liorknafo/power-feed-manual-mill/hardware/fab/README.md

# Fabrication files — MILL POWER FEED v1 controller

Generated by `hardware/tools/export_fab.py` from `hardware/kicad/power-feed.kicad_pcb` (KiCad 9, DRC clean,
schematic parity clean).

| File | Content |
|---|---|
| `power-feed-gerbers.zip` | Gerbers (4 copper, 2 mask, 2 silk, 2 paste, edge) + Excellon drills + drill map: upload this to JLCPCB |
| `gerbers/` | the same files unzipped |
| `power-feed-bom.csv` | BOM, JLCPCB columns: Comment, Designator, Footprint, LCSC Part # (+ MPN) |
| `power-feed-cpl.csv` | pick-and-place: Designator, Mid X, Mid Y, Layer, Rotation (mm, KiCad placement convention: Y up) |

## Board specification (order form)

- Size 100 x 100 mm, rectangular, 4 mounting holes M3.
- **4 layers**, 1.6 mm FR-4, stack-up F.Cu signal / In1 GND / In2 power (+36 V, +3V3) / B.Cu signal.
  JLCPCB standard 4-layer stack (JLC04161H-7628) is fine.
- **Outer copper 1 oz**, inner 0.5 oz (JLC standard). The motor-phase / supply widths and pours are sized for
  1 oz at ~3.5 A RMS; the via counts are the real current limit. Do not order 2 oz: the 0.15 mm spaces and the
  fine-pitch parts (QFN-56, TQFP-48) are below JLC's 2 oz rules.
- Minimum track / space **0.15 mm**, minimum via **0.5 mm / 0.25 mm drill**, minimum drill **0.2 mm**
  (TQFP-48 exposed-pad thermal vias). Hole-to-copper 0.25 mm.
- Surface finish: **HASL lead-free or ENIG** (ENIG preferred for the TQFP-48, QFN-56 and 0402 parts).
- Solder mask any colour; silkscreen white. Vias tented.
- Remove order number: yes (or put it under J6).
- Castellated holes: no. Impedance control: no.

## Assembly notes

- Components on the top side only. Through-hole parts: J1, J2, J5 (Phoenix MSTBA 5.08), J6 (2x7 IDC),
  J7 (JST-XH 7p), C1, C27 (470 uF radial), F1 (5x20 fuse holder) — hand solder or JLC THT assembly.
- J3 (SWD, 1x3 0.1 in pin header, THT) is hand-soldered; it is only needed for debugging (firmware loads over
  USB-C in BOOTSEL mode).
- The MCU is a bare RP2040 (U3, QFN-56 0.4 mm pitch, exposed pad on thermal vias) with W25Q128JVS flash (U4),
  12 MHz crystal (Y1), AP2112K-3.3 LDO (U6), USBLC6-2SC6 USB ESD (U5) and a USB-C receptacle (J4, SMD pins +
  THT shell pegs) on the bottom edge: all machine-placed, no module to hand-solder.
- U2 (TMC5160A) exposed pad and the four CSD88537ND half-bridges need the paste layer as generated.

## Parts without an LCSC number

The schematic carries an `LCSC` field for 190 of 191 parts (73 of 74 BOM lines).
These BOM lines have no LCSC number yet and must be matched to a JLC basic/extended part (or sourced
separately) before ordering assembly:

| Comment | Footprint | Designators |
|---|---|---|
| SWD | PinHeader_1x03_P2.54mm_Vertical | J3 |
