liorknafo/power-feed-manual-mill/mechanical/clutch/MACHINING.md

# Clutch — machining sheet

The model: `mechanical/solidcraft/parts/clutch/` and `clutch.sc` (`mechanical/solidcraft/README.md`). This sheet was
generated from the build123d model the SolidCraft project replaced, with the same numbers as the SolidCraft parts;
keep it in step by hand when a part changes.

All dimensions mm. **Bold** = critical for concentricity or the magnetic gaps: turn these in ONE chucking.
Concentricity budget: every bold diameter ≤ 0.03 TIR to its part's reference bore. After assembly, indicate the
rotor OD and the output shaft: ≤ 0.05 TIR each, or the 0.3 mm hub gap and the tooth mesh suffer.
Magnetic parts: low-carbon steel (1018/1020/12L14), anneal after machining if possible. Never 300-series stainless.

## Field housing (steel) — `field_housing.step`
| Feature | Dimension | Tolerance / note |
|---|---|---|
| OD | **Ø80.0** | h7 (cover spigot fits over it) |
| Length | 20.0 | ±0.05 — sets the 0.3 mm rotor face gap |
| Motor pilot recess (back) | **Ø38.1 (measure your motor) × 2.0 deep** | slide fit on the pilot, ≤0.02 play; the model shows +0.2 |
| Inner pole bore | **Ø19.2** through | concentric with OD and pilot within 0.03 |
| Coil cavity | Ø28.0 … Ø54.0, 15.0 deep from the front | **CNC:** circular pocket with a Ø8–10 end mill round the inner pole (a boring bar can't reach the inner wall), or a face-grooving tool on the lathe. Cut the 4 Ø9 counterbores FIRST: only 1.8 mm of wall is left between each and the cavity |
| Back plate | 5.0 thick | |
| Motor screws | 4× Ø5.5 thru on 47.00 square, c'bore Ø9 from front to z=6 | M5×20 SHCS + nuts behind the motor flange |
| Coil leads | Ø3.2 thru at r=20.5 + 3.2×1.5 groove on the back face | |
| Cover screws | 6× M4 tapped radial, every 60°, 12.0 from the back face (motor side) | no 4th axis needed: fit the cover, then drill Ø3.3 through the cover's holes into the housing, and tap |

## Rotor (steel) — `rotor.step`
| Feature | Dimension | Tolerance / note |
|---|---|---|
| Hub OD | **Ø18.6** × 18.1 long | runs in the Ø19.2 bore: 0.3 radial gap, keep runout < 0.05. Starts 2.2 above the motor flange, clear of the 1.6 pilot |
| Shaft bore | **Ø10 H7**, **flat bottom 0.70 ± 0.03 in front of the face disc's back face** (that is what sets the 0.3 face gap); depth from the hub end ≈ 18.8 with the model's shaft length | finish the bottom with a boring bar (a reamer can't reach it); **the 23HS45-4204S's shaft is 24 long: cut it to 21.0 from the flange face** (face it square, drill Ø2.5 × 8, tap M3 in its end), then the bottom sits at that length + 0.3 from the housing back. Loctite 641 on the D-shaft |
| Retaining screw | Ø3.4 thru + c'bore Ø5.8 × 3.2 from the front | M3×8 SHCS (3.0 head, sits 0.2 below the pole face) into the tapped motor shaft end (drill Ø2.5 × 8, tap M3) |
| Face disc | **Ø76.0** × 5.6 thick | back face sits 0.3 from the housing front; front face = pole face |
| Banana slots | 3 × 112° arcs, r 19.0 … 22.0, through (8° bridges), full-round ends | CNC, Ø3 end mill on the r 20.5 arc (slot = tool width) |
| Tooth ring | r 32.0 … 38.0, 30 teeth (12.0° pitch), flank 30° from axis | flanks meet 0.5 below the pole face; root floor 0.5 deeper (1.0 below the pole face, from r 31.0 out to the OD); tips 0.80 above where the flanks meet; see Teeth |

## Armature (steel) — `armature.step`
| Feature | Dimension | Tolerance / note |
|---|---|---|
| OD × thickness | **Ø76.0 h7 × 6.0** | OD, bore and the tooth-ring face in one chucking (≤ 0.02 TIR): the OD centres the part for milling the teeth and the pin holes; faces parallel within 0.02 |
| Bore | Ø11.5 | clearance over the rotor's M3 head |
| Tooth ring | as the rotor, rotated half a pitch (6.0°) | flanks meet 0.25 behind the pole face, root floor 0.75 behind it (from r 31.0 out), tips truncated 0.1 |
| Drive-pin holes | 3× **Ø6.15–6.20 through** (glue gap for Loctite 680) at r=21.0, 90°/210°/330°, position ±0.02 from the bore, 0.3 × 45° chamfer at the front-face mouth (glue trap) | same program and zero as the hub's bush holes. The pins are bonded in place through the bushes (assembly step 0), so the bushes line them up; through, so excess glue leaves at the back face (r 21 faces the rotor's slot ring, between the poles) |

## Output hub (6061) — `output_hub.step`
| Feature | Dimension | Note |
|---|---|---|
| Flange | **Ø76.0 h7** × **8.7** | its armature-side face is the **released stop** the springs pull the armature against: face it flat and square to the bore within 0.02, and turn the OD, in the same chucking as the bore (the OD, = the armature's, centres the armature when its pins are bonded) |
| Boss | Ø24.0 × 10.0, bore **Ø12 H7** | 2× M5 set screws, mid-boss, at 30° and 150° (midway between the pins, so a hex key reaches them past the springs): one on the shaft flat, one on the round (+ Loctite 243) |
| Bush holes | 3× **Ø10 H7** through at r=21.0, 90°/210°/330°, position ±0.02 from the bore | same program and zero as the armature's pin holes; press the bronze bushes in flush with the **stop face** (the bush bore closes to about F7 on the pins); the 0.7 left on the spring side locates the springs |

## Cover (6061 — must be non-magnetic) — `cover.step`
| Feature | Dimension | Tolerance / note |
|---|---|---|
| OD | Ø88.0 | |
| Spigot bore (over the housing) | **Ø80.0 H7** × 18.0 | slide fit on the housing OD, same chucking as the bearing bore |
| Shoulder / inner cavity | Ø78.0 | the step from the spigot sits on the housing rim and locates the cover axially; clears the Ø76 rotor / armature |
| Bearing bore | **Ø28 H7**, straight through the 8 wall + 28 boss (≈ 89 mm from the open face) | two setups, no long reach: (1) grip the OD lightly (soft jaws: thin wall), face the front, turn the boss, then drill/rough and **bore Ø28 H7 right through from the boss end (36 deep, ~1.3×D)** and cut **both** circlip grooves from that end; (2) mount it on a Ø28 expanding mandrel (or a Ø28 h6 stub turned in place) in the chuck, boss toward the chuck, and bore the Ø80 H7 spigot and the Ø78 cavity: the spigot is then concentric with the bearing bore to the mandrel's accuracy (≤ 0.01). Boring the Ø28 from the open side instead would mean an ~89 mm reach (4.5×D, chatter) |
| Circlip grooves | 2× for DIN 472-28: Ø29.4 × 1.3, **2.1 land** from each end of the bore | the land takes the circlip load: keep the entry chamfer smaller than it |
| Radial screws | 6× Ø4.5 every 60°, 10.0 from the open end, **90° countersink Ø9.2** | M4×8 countersunk (ISO 10642) into the housing, flush: a socket head would stand 4 mm proud, and the one at the bottom would hit the mains tray; drilled together with the housing (see there) |
| Front wall | 8 thick, 4× M5 tapped thru on r=36 at 40/140/190/350° (0° = +X, 90° = drawbolt) | bolts the module to the feed-unit plate |
| Drawbolt hole | M4 tapped **14** deep (drill Ø3.3 × 16), radial, in the front wall at mid-thickness, between two of the M5 (M4 leaves 2 mm of wall each side in the 8 mm wall) | feed-unit belt tension; it points away from the leadscrew. 14 deep because the module moves 6 mm along the M4×30 drawbolt over the tension range |

## Other parts
- Output shaft: Ø12 h6 **unhardened** ground rod (NOT hardened linear shaft: the flats and groove can't be cut in it) × 78. Flats 0.6 deep: × 22 at the pulley end; under the hub boss a Ø10 spot face (plunge a Ø10 end mill). DIN 471-12 groove (Ø11.5 × 1.1) at 29.7 from its motor-side end, just outboard of the inner bearing.
- Drive pins: 3× Ø6 h6 silver steel (unhardened ground rod) × 25.5, 0.5 × 45° lead chamfer at the armature end, bonded 5.5 deep into the armature with Loctite 680 (Amazon B00KC541DA; 0.5 short of its back face). E-clip groove Ø5 × 0.74 (DIN 6799 RS5), 1.0 from the free end. They slide in the hub's bronze bushes, carry the torque (≈ 71 N per pin at the 4.5 N·m cam-out torque) and keep the armature centred.
- Return springs: 3× compression spring, music wire 0.8, OD 9 (ID 7.4: clears the pin, sits on the bush end), free length ≈ 11.9, rate ≈ 2.5 N/mm, solid ≤ 5. Installed 8.7 long released (≈ 8 N each, 24 N total: the armature is pulled firmly against the hub) and 7.6 long engaged (≈ 11 N each, 32 N total). Any catalogue spring near this works; the coil current is calibrated afterwards. On each pin: spring, M6 washer (ISO 7089, Ø6.4/12 × 1.6), E-clip.
- Bushes: 3× sintered (oil-impregnated) bronze plain bush 6 × 10 × 8, ISO 2795 form C.
- Bearing stack (cavity side → outer end): circlip, inner 6001, spacer tube Ø27.95/Ø25 × 12.8 (outer races), outer 6001, circlip. The INNER bearing locates the shaft both ways: the stepped spacer Ø15/Ø12 × 6.6 (hub boss → inner race) on one side, the DIN 471-12 on the shaft on the other (inside the spacer tube); the outer bearing floats on the shaft.
- Assembly (the hub and armature must go on the shaft first: once inside the cover nothing on them is reachable):
  0. **Armature on the hub; the bushes line the pins up.** Glue must never reach a bush (the pin-to-bush gap is
     0.01–0.03; Loctite 680 there would lock the pin), so in this order:
     a. Press the 3 bushes into the hub from the spring side, the stop face on a flat plate, so they finish flush with it.
        Wax both ends of each bush (clean the wax off after curing).
     b. Hub on the shaft with the shaft end **3.70 inside the stop face** (depth micrometer), then the set screws.
     c. Armature on its own: a thin film of 680 on the walls of its 3 holes only, keeping the 1.5 mm at the front-face
        (hub-side) mouth of each dry.
     d. Armature pole face down on PE film on a surface plate (it stands on its tooth tips, ~0.55 proud: that gap lets
        the glue out); the hub on it, stop face on the armature's front face, its bush holes lined up over the armature's
        holes by eye; then a **centring sleeve** over both (any tube bored Ø76 H7, ~25 long). The first pin's chamfer
        finds the rest of the alignment.
     e. Each pin: a Ø6 shaft collar (OD 12–16: it must bridge the Ø10 bush counterbore and clear the Ø24 boss) set 14.2
        from its chamfered end. Push it, dry, straight **down** through its bush into the hole until the collar lands on the
        hub's spring-side face, and never lift it: the tip then sits 0.5 inside the armature's back face. Excess glue is
        pushed out of the open bottom of the hole onto the PE film; the 0.3 mouth chamfer catches any that creeps up.
     f. Clamp lightly (on the hub boss or the shaft end, never on the teeth), let it cure (24 h), collars and sleeve off,
        scrape the back face flush: nothing may stand proud of it (the engaged pole gap is 0.15). Each pin was set by its
        own bush, so three pins in three bushes can't bind. Slide the armature off the bushes, clean the wax off both
        stop faces and the bush ends, slide it back.
     g. On each pin, from the hub's far side: spring (into the counterbore on the bush), washer, E-clip (compress the
        spring with a slotted tube). Check: the armature slides 1.1+ mm toward the motor by hand, freely, and snaps back.
        Keep the stop faces dry (degrease): oil from the bushes on them can make the armature stick to the hub a little.
  1. Inner circlip into the empty cover. 2. Inner 6001 in from the outer end until it seats on that circlip.
  3. Shaft with hub, armature, pins, springs and stepped spacer already fitted: push it through the inner bearing from the cavity side,
     supporting the inner race with a tube from the outer end (Loctite 243 on that seat).
  4. DIN 471-12 down the bore into its groove (~24 deep from the outer end) with a cone on the shaft end and a push tube.
  5. Spacer tube, outer 6001 (slides on), outer circlip.
  6. **Released-gap check.** The springs hold the armature against the hub, so the released gap is set by where the hub
     sits: the stepped spacer (hub boss → inner race) sets it. The gap is out of reach once the cover is on, so measure two
     depths before closing, with a depth micrometer:
     A = rotor pole face above the field housing's front face (rotor glued on, motor shaft in): 5.90;
     B = cover shoulder face (the step that sits on the housing rim) down to the armature's pole face: 7.15.
     B − A is the released gap: 1.25 ± 0.10. Too small: grind the stepped spacer shorter; too big: shim it. After closing,
     turning the output by hand with the coil off must not tick (no tooth contact); coil on (1.5 A) the output locks to
     the motor, coil off it frees at once.
- Coil: ~850 turns 0.32 mm (AWG 28) enamelled Cu on a bobbin Ø28.6…Ø53.4 × 14.5; ≈24 Ω. Leads out through the back plate.
- Bearings: 2× 6001-2RS in an H7 bore. Shaft is h6 ground rod: the inner (locating) bearing is retained with Loctite 243 (Amazon B004L439FE; medium strength, comes off with hand tools: Loctite 641 doesn't ship to Israel), the outer one is a slip fit so it can float. Screws: 4× M5×20 + nuts (motor; the nuts sit behind the 4.8 mm flange in the body's corner relief: check yours has room, else use M5 screws from the motor side into M5 tapped in the housing), 6× M4×8 countersunk ISO 10642 (cover), 1× M3×8 (rotor), 2× M5×6 set screws (hub), 4× M5×35 + washers (module to the 28 mm feed-unit plate), 1× M4×30 drawbolt.
- Coil leads: sleeve them through the back plate, and pot the winding in the cavity (epoxy) so it cannot chafe or move.
## Teeth
- 30 radial teeth, flanks **flat planes** at 30° from the axis: every flank is the plane through a radial line at the pitch
  plane, so a 60° chamfer mill cuts it exactly in one straight pass, and the rotor's gaps and the armature's teeth share those
  lines: both parts come off the SAME program and mate exactly.
- Engaged pole gap 0.15, stroke 1.1 -> released gap 1.25.
- Tips truncated 0.1 (break them 0.1 × 45° after), roots relieved 0.5 below where the flanks meet: a mating tip sits 0.6 above
  the root floor, so the flanks carry all the load and the root corners never touch.
- **Turning (before milling), both parts:**
  - tooth band r 32 → OD: turn to the TIP height: **0.30 proud of the rotor pole face, 0.55 proud of the armature pole face**;
  - run-out groove r 31.0 … 32: turn down to the root floor, 1.3 below the tip height (the cutter runs out into it);
  - face the pole face inside r 31.0 as dimensioned.
- **Milling (3-axis CNC, no indexer needed):**
  - Hold: rotor by its hub in a collet block, teeth up; armature on a fixture plate with a Ø11.5 spigot in its bore and
    3 Ø6 dowels in its pin holes (drill those first), clamped by a centre bolt through the spigot with a Ø24 washer on
    the inner pole face. Centre both on the Ø76 OD.
  - **Z zero on the turned TIP surface** (same on both parts). Pitch plane = 0.35 below it; root floor = 1.30 below it.
  1. Rough each gap with a Ø2 flat end mill to the root floor, radial passes with the **cutter centre from r 32** out past the
     OD (starting further in notches the inner pole face), leaving ~0.1 on the flanks (the floor gap is only 2.25 wide at r 32).
  2. Finish each flank with a **60° chamfer mill** (pointed or ≤ 0.2 flat), one straight radial pass per flank, **tip at the root
     floor (Z −1.30)** (anywhere at or below Z −0.70 still covers the working flank): the cone's side on the flank line at the
     pitch plane, offset by the cone radius at that depth. 60 flanks per part, same program for both.
  3. Measure the chamfer mill's actual angle and point first: each 0.01 mm of flank error on both parts moves the armature 0.035
     axially. **Acceptance:** mate the pair dry and check the pole gap with feeler gauges: 0.15 ± 0.05.
- Lap the pair together with fine compound after cutting; re-check the gap.
- `flank_deg = 45` suits a standard 90° chamfer mill, but the cam-out force then rises ~1.8x (expect ~1.3x more hold current;
  re-calibrate per design.md §7.4).

## Tools (lathe + 3-axis CNC mill; no indexer, no 4th axis, no form cutters)
| Tool | Used for |
|---|---|
| Lathe turning tool, nose radius **≤ 0.3** (e.g. DCMT 11T302) | all ODs, faces, the tooth bands, the run-out grooves, the seating corners (see Corners) |
| Boring bars: min. bore Ø8 (L ≥ 25) and min. bore Ø20 (L ≥ 45) | rotor Ø10 H7 bore with its **flat** bottom; cover Ø28 H7 (from the boss end), Ø78 cavity, Ø80 H7 spigot; housing Ø19.2 pole bore and pilot recess |
| Internal grooving tool 1.3 wide for ≥ Ø26 bores | cover: 2× DIN 472-28 grooves (Ø29.4) |
| External grooving tool 1.1 wide; a 0.7–0.75 wide ground HSS blade | output shaft DIN 471-12 groove; drive-pin E-clip grooves (DIN 6799 RS5, 0.74) |
| Expanding mandrel Ø28 (or a stub turned in place) | cover, 2nd setup |
| Carbide end mills: Ø2 flat (flute ≥ 2), Ø3 (flute ≥ 6), Ø8–10 (flute ≥ 16), Ø10 | tooth roughing; rotor banana slots; housing coil cavity (15 deep); output-shaft spot face and flats, Ø9 counterbores |
| **60° chamfer mill**, pointed or ≤ 0.2 flat (e.g. a 60° spot drill) | the 120 tooth flanks (60 per part) |
| Drills Ø2.5, 3.2, 3.3, 3.4, 4.2, 4.5, 5.5, 6.2, 9.8, 11.8 + reamers Ø10 H7, Ø12 H7 | screw holes; drive-pin holes (Ø6.2 drill = the 6.15–6.20 glue gap); hub bush holes (Ø10 H7); hub bore (Ø12 H7) |
| Taps M3, M4, M5 | rotor screw (motor shaft end), cover/housing radial M4, cover front-wall M5 and drawbolt M4, hub set screws |
| Workholding: ER32 collet block; a fixture plate with an Ø11.5 spigot, 3 Ø6 dowels and a centre bolt | rotor teeth (by its Ø18.6 hub); armature teeth (see Teeth) |
| Measuring: depth micrometer, feeler gauges 0.10–0.20, dial indicator | released-gap check (step 6), tooth-mesh pole gap 0.15 ± 0.05, runout ≤ 0.03 / 0.05 |

## Corners (what the tools leave, and why it doesn't matter)
- Every internal corner along a cutter's axis is modelled round (slot ends, pockets) or is a drilled/counterbored hole.
  (The build123d model's check of this is gone with it: look for sharp internal corners by eye after changing a part.)
- Turned internal corners get the tool's nose radius. Keep it **≤ 0.3** where a part seats in the corner:
  - cover: spigot bore → Ø78 shoulder (the housing's front OD edge is chamfered 0.5 × 45° to clear it);
  - field housing: coil cavity floor corners (the bobbin has 0.3 clearance; chamfer its corners) and the motor-pilot recess
    floor (the motor's pilot edge is chamfered);
  - rotor: hub → face-disc corner (the housing bore's front edge is chamfered 0.5 × 45° to clear it).
- Rotor shaft bore: the motor shaft's end seats on its bottom, so the bottom must be **flat** and is dimensioned from the
  face disc (see Rotor): drill under size, bore to H7 and finish the bottom with the boring bar (a reamer can't reach it).
  A drill point there would set the rotor ~3 mm wrong.
