liorknafo/power-feed-manual-mill/mechanical/feed_unit/FEED_UNIT.md

# X feed unit — SIEG X3.5D left table end

The model: `mechanical/solidcraft/feed_unit.sc` and its parts (`mechanical/solidcraft/README.md`). This sheet was
generated by the build123d model the SolidCraft project replaced; its numbers are the same in the SolidCraft parts.

**Status: concept with PLACEHOLDER mill dimensions.** Measure the items in docs/mill.md, set them in the SolidCraft
parts (`mechanical/solidcraft/README.md` → "Measure first"), run `mechanical/solidcraft/tools/check.py`, and check the
renders before cutting metal.

## Drive
| Item | Value |
|---|---|
| Belt | HTD 5M, 295 mm (59 T), 15 mm wide |
| Pulleys | 20 T (PD 31.83) on the clutch output Ø12; 40 T (PD 63.66) on the Ø15 stub → 2.0:1 |
| Centre distance | 70.71 mm, tension slot ±3 mm along the centre line |
| Module position | 70.7 mm from the leadscrew at -90° (below) |
| Belt plane | 23.0 mm out from the bracket face |
| Overall | ≈316 mm out from the table end (housing end panel) |

Firmware: `belt_ratio = 2.0`, `encoder_counts = 2400` (per leadscrew turn; the encoder is on the stub).

## Parts to make
| Part | Material | Notes |
|---|---|---|
| Plate | 6061, 28 mm, CNC | **Ø32 H7 straight through**: too big to swing on the lathe (300 mm needed), so bore it on the mill with a boring head. DIN 472-32 grooves (Ø33.7 × 1.3) leaving a **2.6 land** at each face: keyseat cutter (head ≤ Ø28, 1.0–1.2 wide, two passes) by circular interpolation, one face, then flip for the other. Clutch-module hole slotted Ø40 **and run on down through the bottom edge** (the module slides up into it from below; the two legs are 35 wide, tied by the tension block) and 4× Ø5.5 slots (±3): 5×D deep, cut them from both faces. Bottom edge: 2 rebates 2.5 deep × 14 wide × 13 in from the outer face at x ±34 (Ø6 end mill from the edge, R3 inner corners) with an M4 × 10 tapped up into each, for the mains tray's tabs. 4× Ø6.6 for the standoffs, each with an Ø11 × 6.5 counterbore in the outer face (M6×70 SHCS heads flush: the low pair sits beside the clutch cover); 3× M3 × 8 deep on r=23 (encoder posts, outer face); 2× M5 × 12 for the tension block (x ±30). Edge holes (M3 × 8 for the housing): stand the plate in the vise on its edge, or use a drill-guide block. Corners R9 |
| Standoffs | steel or 6061 | 4× Ø14 × 35, Ø6.6 thru (M6 screws into the table end) |
| Leadscrew stub | steel, turned from **Ø20** stock | from the table side: tongue 4.8 × 14 × 4 (across the Oldham slot), Ø15 with a 0.6 flat for the 40T set screws, **Ø18 × 2 shoulder** on the inner bearing's inner race (corner radius ≤ 0.3 so the bearing's chamfer clears it), Ø15 h6 at both bearings with **Loctite 243 on the inner one** (as on the clutch; easier than holding k6 and h6 bands on a manual lathe), DIN 471-15 groove (Ø14.3 × 1.1) just outboard of the inner bearing, Ø8 × 10 encoder end |
| Bearing spacer tube | steel or 6061 | Ø31.95 / Ø28 × 1.8, between the outer races. The inner bearing locates the stub (shoulder + DIN 471-15 either side of it); the outer one floats on the stub |
| Oldham disc | steel (1045) or bronze (CuSn12), greased — acetal creeps at the ~45 MPa of a stall/cam-out | Ø24 × 9: tongue 14 × 3.8 on one face (into the leadscrew slot), cross slot 5.0 wide × 4.5 deep on the other. Takes up to ~1 mm offset between the plate and the leadscrew, and end float |
| Encoder disc | 6061, 5 mm | Ø50 with a flat 20 from centre toward the clutch module; Ø22 centre hole; 3× Ø3.4 on r=23 (posts) and 3× Ø3.4 on r=15, 60° offset (encoder, **check your encoder's hole circle**) |
| Encoder posts | 3× M3 hex standoffs F-F, 30 mm, 6 across flats (priaolker brass, Amazon B09NDJFLG7) | |
| Tension block | 6061 | 72 × 14 × 12 on the plate's outer face below the module, bridging the plate's slot, 2× M5 into the plate's legs (x ±30), **with a 39.8 × 28 tongue that fills the slot** from the plate's bottom edge up to 60 (just under the clutch boss): it seals the belt chamber off from the box (chips, coolant) and ties the plate's legs (checked); M4 drawbolt through it into a radial M4 tapped 7 deep in the cover's front wall (bottom, between two module bolts). Tighten the drawbolt to tension the belt, then lock the 4 module bolts |
| Belt guard | PETG print | a cup: closed back against the table end (Ø28 pass-through for the leadscrew and Oldham disc), open face covered by the plate; captured between the two |

## Assembly
1. Plate: outer circlip, outer 6002 (pressed in from the chamber side), spacer tube.
2. Stub: inner 6002 against the shoulder, DIN 471-15 behind it. Push the stub through the outer bearing from the
   chamber side (support the outer bearing's inner race) until the inner bearing seats, then the inner circlip.
3. Encoder to its disc, coupling on the encoder shaft, disc onto the posts, coupling onto the stub end.
4. 40T pulley on the stub (set screws: one on the flat, one on the round), Oldham disc on the stub tongue, guard into the chamber, then
   the plate onto the standoffs: the Oldham tongue goes into the leadscrew slot.
5. Clutch module through the plate's slotted hole (motor bolted to the clutch with its leads toward the front wall, not up
   toward the PCB: checked), 20T pulley and belt, 4 module bolts finger-tight, drawbolt to tension, lock.
   The bolt heads are on the chamber side, outside the guard outline: reach them from the side with a ball-end key.

## Buy
Every bought part ships to Israel from Amazon.com (checked with an Israeli address); the Amazon list "Mill power feed
(SIEG X3.5D)" has them all, and `mechanical/solidcraft/parts/bought/` models each from its listing's drawing.
- HTD 5M pulleys, both hubless (flange, teeth, flange): **20 T Saelno 20-5M-15-8mm** (Amazon B0FNQTJZMX: Ø35 flanges, 16
  between them, 20 overall, Ø8 bore, 2× M5 through the teeth 90° apart) and **40 T uxcell 5M-40T-1/2B** (B0G5YDQS1N:
  Ø67 flanges, 22 overall, Ø12.7 bore with a keyway). Re-bore to Ø12 / Ø15 H7 (the 40T's keyway leaves a 0.25
  trace: harmless). Set screws 90° apart through a tooth root, one on the shaft's flat, one on the round, like the
  clutch hub: the 20T's own 2× M5 (M5×6), on the 40T 2× M5×20 (use its own holes if they are in a tooth root, else
  drill Ø4.2 and tap; the drill nicks the teeth either side: harmless, deburr).
- Belt 295-5M-15 (uxcell B0D5R5Y6VL).
- 2× 6002-2RS, 2× DIN 472-32, 1× DIN 471-15.
- Flexible coupling 6 × 8 mm, uxcell Ø19 × 25 beam type with set screws (B0FN786WNM).
- Encoder: Aideepen LPD3806-600BM-G5-24C, 600 P/R, NPN open collector (B01MZ4V1XP).
- Retaining compounds (Loctite 641 and 638 don't ship to Israel): **Loctite 243** (Amazon B004L439FE) on the bearing
  seats and the motor shaft (medium strength, comes off with hand tools), **Loctite 680** (B00KC541DA, seller ACTOOLS)
  for the clutch's drive pins. Both checked shipping to Israel.
- 4× M6 for the standoffs; 4× M5×35 + washers for the clutch module (28 plate + 8 wall: the tips stop clear of the hub); 2× M5×20 (tension block) + 1× M4×30 (drawbolt); 3× M3 hex standoffs 30 mm F-F (room for the 25 mm coupling) and 6× M3×8.

## Notes
- The module hangs ≈177 mm off the plate on 4 M5 into the cover. The cover's spigot over the clutch housing is
  18 mm long with 6 radial M4, so the motor is held stiffly. A strap from the motor's tail to the
  table end is optional if the mill vibrates a lot.
- The chamber (35 mm) is set by the Oldham disc plus the belt plane: the 40T pulley's inner flange clears the stub tongue.

## Housing: the whole power feed in one compact box (3D printed)
The drive, the controller PCB, the controls and the 36 V supply share one rounded housing on the table end. Outside
it there is only the belt chamber (closed by the guard cup) and the limit switches. The housing carries no load
(the aluminium plate carries the bearings, the module and the belt), so it is printed.

Packing: the clutch and motor hang below the leadscrew, the encoder sits on the leadscrew next to the plate, the
**PCB lies flat above the motor** (components up, connector edge toward the end wall), and the controls sit in a
strip along the upper front with their bodies reaching back over the PCB.

| | |
|---|---|
| Outer size | 116 (front-back) × 204 (high) × 262 mm (along the table); long edges R12, the top-front edge and the end wall chamfered 45° (they lie on the print bed); plus the 35 mm belt chamber and the controls proud of the front |
| `shell` (one print) | back and lower-front walls (3 mm) from the plate to W 248, the rails, the 4 PCB bosses, the louvre blocks; **no floor** (that is the door), no end wall (that is the end cap). **Print standing on its cut face** (the plate-side rim up), 193 mm tall (MK3S: 210), on the 5 × 3 brace that ties its back and front walls across the cut face; above the brace they stand as two tall walls, so **use a brim** (5 mm). Every boss and block has a 45° underside, so **no supports**; only short bridges (≤ 12 mm: rail windows, louvre slots). PETG, 4 perimeters, 20 % gyroid |
| `end_cap` (one print) | the last 68 mm of the box: the end wall, the ends of the back, front and top walls and of the control strip, and the floor under the mains tray's far end (2 ribs carry that end). It exists because the LRS-150-36 (the only 36 V Mean Well on Amazon that ships to Israel) makes the box 262 mm long, too long for one print. **Print standing on the end wall**, 90 mm tall with its blocks; the blocks' ends are 45° wedges, no supports. It goes on **last, sliding along the table axis** (checked: nothing in its way): its floor slides under the tray's far end, a 45° scarf on its bottom band slides under the door's far end and holds the door shut, and 3 blocks reach 22 mm into the shell along its back and front walls: 3× M3×8 countersunk through the shell's walls into heat-set inserts in them. The seam is **lapped over the top and the sides**: the cap's outer 1.2 mm runs 8 mm on over a step in the shell's walls, and the hood's runs 8 mm on over a step in the cap's top (0.2 mm clear), so coolant on the top or the sides can't reach the plugs or the mains tray. Only the sides' bottom 5.5 mm (beside the hinge knuckles) is a plain butt joint, which leads only to the floor under the earthed tray: a bead of silicone there, as on the door seam, if coolant gets in; the hood still lifts straight off, the cap still slides. Take it off (3 screws) before opening the door: it then hangs on the USB, SWD, button and limit-switch wires, so leave them ~150 mm of slack and set the cap down beside the box (or tie it up) rather than let it hang |
| `door` (one print) | **the floor** up to the end cap, both rounded bottom edges included (116 × 193 mm, up to 8.5 mm on the walls): open it and the clutch/motor module and the mains tray go in and come out **from below** (checked: both lift into place with nothing in the way). Hinged along the **back bottom edge** on a Ø3 × 180 steel pin (silver steel / drill blank) through 5 knuckles outside the back wall; push the pin in **from the end-wall end** (that line runs just outside the box; from the plate end it would hit the mill): it slides through every knuckle (Ø3.2) and only its last 30 mm press into the plate-end knuckle (Ø2.95, a drop of CA). To take the door off, punch the pin out from the plate end (there is room under the belt guard). Opened, it swings down and hangs beside the box, so the opening is clear (swing checked to 100°). Shut by one screw on the front side, M3×8 countersunk up into the plate's bottom edge (x 44); its far end lies on the end cap's 45° scarf, which holds it up, so the cap comes off before the door opens and goes on after it shuts. It carries the belt drawbolt access hole (belt tension is set with it shut) and pockets for the PSU's and the tray tabs' screw heads. **Print outer face down**: 45° feet under the rounded edges, 45° drips and a 1.2 mm web from each door knuckle down to the bed (trim the webs off flush after printing), and its far end leans out at 45° (the scarf), no supports. The seam is a plain 0.3 mm butt joint: run a bead of silicone or a strip of foam tape along the front if coolant gets in |
| `hood` (one print) | top + control strip up to the end cap, one L-shaped piece. **Print with the strip face down**: the engraved labels come out crisp on the bed side; its back lip has a 45° inside so it prints without support. Lift it off and the whole PCB is exposed from above |
| Plate | aluminium, 110 wide, bottom corners R9, both top corners chamfered 10.5 × 45° to sit under the housing's chamfered inside |
| Fixing | shell, hood and door overlap the plate edges by 8 mm with 0.25 mm clearance per side, and screw into them (12× M3×8 countersunk into tapped holes); the hood also takes 7× M3×8 into heat-set inserts (Kadrick M3 × 5, B0FD88XTV4: Ø4.0 × 6 holes) in the shell's rails, and the end cap 3 through the shell's walls into inserts in its blocks |
| PCB | on 4 printed bosses (heat-set inserts, M3×6), underside -33 mm below the leadscrew axis, ≥ 3 mm above the motor even with the motor raised 3 mm by the belt tensioner. The rails above it have 12 mm windows over all 4 holes, so a screwdriver and the insert iron go straight down (checked). Trim the SWD header's (J3) pins flush underneath. Air rises past the board between the bosses |
| Plugs | J1/J2/J5 MSTB plugs (≈13 mm) + ferrules: the wires run toward the end wall and turn down past the board's edge, behind the motor tail (74 mm), checked with a plug + wire-bend envelope. Unplugging in place: slide the plug off, the wires have slack below |
| Controls (strip, left → right as you face it) | E-stop **ZGSZJHF 22 mm ultra-short** (Amazon B0FZCN2HCP; 1 NO + 1 NC: the NC is the E-stop loop, ESTOP_SRC–ESTOP_RET; Ø22.35 hole with its key notch, 3.5 wide (its drawing: 3.3 +0.2), so it can't turn; Ø32.3 mushroom 25.7 proud, only 18.3 behind the panel to its pin tips, so it clears the J6 ribbon plug with room to spare; its ring nut is drawn but not dimensioned, modelled Ø30) on a **printed yellow Ø45 legend plate** (1 mm, keyed the same), LEFT/STOP/RIGHT toggle (DMWD ON-OFF-ON latching DPDT, B0BTSPYM34: Ø12 hole (Ø12.2 here) + key notch for its lock washer, body 29.7 × 19.8 × 28.7) over RAPID (Gebildet Ø16 stainless momentary, B081JJBN4G: 22 behind the panel), SPEED dial (EC11-type encoder; CAD = Bourns PEC11R: M7 bushing, nut in front, no lug hole; snip the lug if yours has one: two printed ribs either side of its body stop it turning into the OLED) with the uxcell Ø30 knurled aluminium handwheel (B0DGFB1K9F, hub toward the panel, its 2 set screws on the shaft), the Hosyond 1.3" SH1106 OLED (B0C3L7N917, holes on 30.3 × 28) on 4 M2 posts behind its window; adapter board 40 × 28 (2×7 IDC) on 4 posts on the strip's inside, ~200 mm ribbon down to J6 so the hood can be lifted and set beside the unit. All shapes from the Amazon listings' drawings (`mechanical/solidcraft/parts/bought/`), checked against the strip, the PCB, its plugs and each other, the E-stop and toggle through their key play |
| End wall (on the end cap) | the mains inlet (recessed 9 mm, see Power), one M16 cable gland for the limit switches (uxcell nylon M16×1.5, B08K8HPHGM), low beside the motor. **Programming ports, usable with the box closed:** a Ø21.6 hole for a round threaded USB-C panel extension (QIANRENON 5 Gbps, B0FX2MZDTS: M21 thread, Ø27.5 flange outside, its nut inside; body and strain relief reach 34.5 in, 30 cm cable to a male plug; the Adafruit #6069 with its M12 thread doesn't ship to Israel), **plus a 90° USB-C adapter (male to female, "up/down" type, rgzhihuifz B08P5HRH3Z) in J4**: J4 is only 29 mm from the wall and the extension's straight male end is long (~38 mm allowed: the listing doesn't give it), so it goes down into the adapter from above (space checked, with the panel end's body and its cable turning away); **BOOT and RESET** buttons (Twidec PBS-110 7 mm momentary NO, pre-wired, B07RPS2ZY3, in Ø7.2 holes, recessed in Ø16.5 × 8.5 counterbores (room for a 1/4" 10 mm socket, ≤ 16 OD, on the 10 AF nut) so the caps stay 0.3 mm below the wall face and can't be pressed by a bump or a palm; a fingertip still reaches them; solder their 2 wires across the pads of SW1 / SW2 on the PCB, in parallel with them) and a recessed **SWD port** (1×3 0.1" header, SWCLK / GND / SWDIO like J3, pressed into the slot from outside with a drop of CA; solder 3 wires to its inner pins and run them to J3) |
| Vents | intake through louvre blocks on the back and front walls beside the motor (slots climb 45° inward, so chips and spray can't reach the mains tray); no floor vents; exhaust through a louvre block high on the back wall, beside the encoder (slots climb 45° inward through 7.5 mm, so chips can't fall in), away from the fuse. The block takes a 40 mm fan (4× M3 self-tapping, 32 mm square) on its inside |

- **Power, built in: the mains tray.** All 230 V lives in an earthed, folded **aluminium tray** under the clutch and
  motor (104 wide, 32 high over the PSU and 42 over the terminal/inlet zone, W 63…308; 1.5 mm
  1050/5052 sheet: floor, two side walls with inward-folded lid flanges over the terminal zone, end face, and two flat floor tabs
  that reach under the plate). Model: `mechanical/solidcraft/parts/mains/mains_tray.json` (+ `mains_tray_lid.json`), SolidCraft sheet-metal parts with
  the real 1.5 mm bends (export STEP from them for a fold drawing); flat patterns below. It holds:
  - a Mean Well **LRS-150-36** (36 V / 4.3 A, 159 × 97 × 30, case 241A; Amazon B019GYOQDW, PowerNex: no LRS-75-36 or
    LRS-100-36 listing ships to Israel), screwed through the tray floor into its two base holes (24 and 102 from the
    terminal end): **M3 × 4 button head (ISO 7380)** — the case allows 3 mm of thread, the tray is 1.5 — reached through
    the service door; their heads sit in pockets in the door. Terminals 1 L, 2 N, 3 FG, 4–5 −V, 6–7 +V, toward the inlet;
  - a **snap-in IEC C14 inlet with fuse and rocker switch** clipped into the tray's end face (cut-out
    47.2 × 28.2): the **JOYNANO 3-in-1** (Amazon B071VLCTPB), sold for 0.8–1.5 mm panels, so it grips the 1.5 mm
    tray sheet (most snap-ins are for 2 mm and would rattle); its listing has no drawing, so the CAD uses the same generic
    module's drawing (SINORS, B0H5TNSZ7L: flange 50 × 30.8 × 3, cut-out 47 × 27.5 R2, body 20.5 + tabs 10): C14 bay left,
    rocker right, fuse drawer under the bay. Swap its 5 A fuse for a T 2 A ceramic. The cord: buy it locally, an ordinary
    C13 cord with an Israeli (SI 32) plug, 3 × 0.75 mm² or more. The C13
    plug (LS-13 type: body 24.6 × 17, nose 23 × 15) reaches the inlet through the end wall's opening. It sits 9 mm behind the printed end wall's opening, so
    coolant running down the end wall doesn't reach it. Fit an IEC retaining clip (V-lock or a wire bail) so the cord
    can't half-unplug on a vibrating table;
  - a separate aluminium **lid** over the terminal/inlet zone, its plate-side edge folded down to just above the PSU
    (so the zone is closed all round): 4× M3×8 button head + Ø12 washer into **open-end M3 rivnuts** (HANGLIFE, B0DF72LHVP: Ø5 hole,
    grip 0.5–1.5, 9 long; no closed-end M3 rivnut ships to Israel) in the walls' 10 mm folded flanges: the lid's holes
    are Ø8.5 so it lies flat over the rivnuts' Ø8 × 0.8 flanges, the washer clamps it, and each M3×8 ends inside its
    rivnut (2.7 mm short of the open end as bought; setting shortens the body, so check with the screw in that the
    tip stays inside, else use M3×6), so no screw tip reaches into the mains zone; the screws also bond the lid to the tray. Its flat part lies 1 mm above the
    PSU case; over the terminals it rises with the terminal zone (checked: ≥ 3 mm to the modelled screw heads; the head
    height is inferred from the drawing, so check it on your PSU), and line the
    inside of the fold (and the lid above the terminals) with 0.4 mm Nomex/Formex insulating sheet either way. A Ø10 grommet in it: the **only** thing that leaves the
    tray is the 36 V pair (1 mm², 300/500 V insulation since it runs inside the mains tray, to J1).
  - **Flat patterns** (cut flat on the CNC, then fold): `mechanical/solidcraft/flat/mains_tray_flat.dxf` and
    `mains_tray_lid_flat.dxf`, SolidCraft's own unfold of the sheet-metal parts (K 0.33, inside radius 1.5). They were
    checked against the build123d flats they replace: the same blank sizes (tray 197.535 × 295.134, lid 104 × 93.134),
    the same outline vertex for vertex, the same holes, inlet cut-out, drawbolt notch and reliefs (Ø5.43 round relief
    where two bend lines cross). Bend lines are drawn only where there is material, so the end face's stops at ±47.85
    and each wall's at the corner relief, split at W 223 where the wall height steps. DXF in mm: the outline on layer
    `OUTLINE`, holes and cut-outs on `CUT`, bend centre lines on `BEND_UP` (ignore them in CAM). **The tray's blank is
    drawn from the INSIDE** (seen from above the floor: every bend folds up toward you); the lid's from above, as
    before. Re-export them from the parts after any change (`mechanical/solidcraft/README.md`). The end face takes the
    corners: its full 104 width folds up, the walls stop 0.25 mm inside it, so above the corner reliefs the only gap is
    that slit.
    **Bend method:** inside radius 1.5 mm (1 t: about the least 5052-H32 takes at 1.5 mm; radius the brake's
    clamping-bar nose to it), **K-factor 0.33** (DIN 6935: k/2 = (0.65 + 0.5·lg(r/t))/2 = 0.325 at r = t; the
    generic K-factor chart, The Fabricator, gives 0.33 for air-bent aluminium with r ≤ t), so a bend allowance of
    3.134 mm and a **bend deduction of 2.866 mm per bend**: a flange is its outside length − BD/2 for each
    bent edge, and each bend line lies BD/2 in from where the two outside faces meet. Fold a test strip first and
    correct `bend_k` if the flanges come out long or short.
    Tray blank 197.5 × 295.1 (9 holes, 5 bends): fold the two lid flanges first, then the
    side walls, then the end face (brake fingers set at most 84 wide, between the lid flanges' edges,
    and taller than the 42.5 walls). The end face takes the corners (full width);
    the walls stop 0.25 mm short of its inside, the lid's folded edge is 0.25 mm narrower a side than the
    gap between the walls, and the lid flanges start 1.75 mm past that edge's inside face, clear of its
    inside radius, so the lid sits down on them (that leaves a 1.75 × 3.5 window at the top of each wall
    beside the lid's folded edge: close both with silicone too). Ø5.4 round reliefs where the floor's two bends meet at the end
    face (each leaves a small hole in a bottom corner of the inlet end: close them with a dab of silicone after
    folding, against swarf), and reliefs 3.5 deep where a bend starts partway along an edge: 1.5 wide at the
    walls' plate ends, 3.25 at the lid flanges' PSU-side ends, 1.75 at both ends of
    the lid's fold (so cut the blank with a Ø1.5 cutter or smaller, or file those reliefs). Lid blank
    104.0 × 93.1 (5 holes, 1 bend).
    **Holes near a fold** (from the check):
    2× Ø5.0 hole in the back lid flange: its edge 0.50 mm inside the fold's tangent line;
    2× Ø5.0 hole in the front lid flange: its edge 0.50 mm inside the fold's tangent line;
    2× Ø8.5 hole in the lid: its edge 0.75 mm short of the fold's tangent line.
    The rivnut holes sit 5 mm from the walls'
    outside, so at this radius they reach into the lid flanges' folds: they are cut flat with the rest (layer `CUT`)
    and may pull slightly oval, so run a Ø5 drill through each after folding. The rivnuts' Ø8 flanges also overhang
    the folds' outside round (flat only from 3.0 mm out): check each rivnut seats; moving them out needs
    wider flanges (not done). The lid's Ø8.5 holes stay outside its fold.
  - **Fixing and earth:** the tray goes in from below. Its two floor tabs sit in rebates in the plate's bottom edge and
    2× **M4 × 8 button head (ISO 7380)** go up through them into the plate, with a **serrated lock washer (DIN 6798 J
    M4, 0.5 thick) between each tab and the plate**, in the rebate: it bites both bare metals (checked against every other
    hole in the plate); the heads sit in pockets in the door. That holds it and earths it; 2 ribs on the end cap
    carry its far end. PE: inlet ⏚ → an M4 stud on the tray (ring terminal, star washer) → PSU ⏚. Leave both earth
    leads longer than L/N so they pull out last. Don't anodise the plate or the tray, or scrape the bond faces.
    Through the plate the motor (4 M5), the clutch (cover + housing screws), the encoder posts, the stub and the mill
    table are all on the same earth.
  - **Wiring:** 0.75 mm² 300/500 V wire, insulated female spades on the inlet (fuse in **L**), crimp ferrules in the
    PSU. 36 mm of free wiring room between the PSU terminals and the inlet body (checked). Tie each mains wire next to
    its spade and its terminal, so one loose wire can't move. Wire the whole tray on the bench, lid on, before it
    goes in: the PSU terminals can't be reached with the motor above them.
  - **Fuse:** T 2 A ceramic (high breaking capacity) 5 × 20 for 230 V; T 4 A for 120 V (the LRS-150 draws 3 A there at full load).
  - **Power budget:** about 35–50 W at rapid traverse and about 60 W during the clutch pull-in (54 W for 50 ms with
    the motor at its 1 A hold current); the LRS-150's 155 W covers all of it, a jam at rapid (motor at full torque,
    ~100 W) included. If the LRS ever trips (overload, or the overvoltage latch,
    which needs a mains off/on to reset), the clutch springs release and the board shows `NO 36V`; nothing restarts
    on its own until the switch is centred.
  - **No floor vents** (the tray is above the floor). The motor breathes through louvred slots in the back and front
    walls beside it; the PSU convects up out of the open tray (its own perforated case is the cover there). Two Ø4
    drains in the floor behind the inlet let out any coolant that gets past the recess.
  - The cord moves with the table: give it a loop or a cable chain, a P-clip on the unit and strain relief at the
    stand. The rocker switch is the mains switch; the E-stop removes the drive enable and the clutch, not mains.
  - **Before first power-up (commissioning):** with the cord unplugged, measure from the cord's earth pin to the plate,
    the motor case, the clutch cover, the encoder body and the PSU case: each ≤ 0.1 Ω. Check L/N/PE continuity and
    that the fuse is in L. Only then plug in.
  - Your S-350-36 is no longer needed for this unit.
- **Programming with the box closed:**
  - **From your Mac, whatever the firmware does:** USB-C cable from the Mac to the end-wall USB-C. Hold **BOOT**, tap
    **RESET**, release BOOT: the RP2040 comes up as the `RPI-RP2` drive; copy `power-feed.uf2` onto it. (With the 36 V
    supply off it's even simpler: hold BOOT while plugging the cable in; USB powers the logic.)
  - **Same thing from the menu** when the firmware runs: settings (long-press the dial while stopped) → last item
    **USB FLASH** → hold.
  - **Debugging:** Raspberry Pi Debug Probe on the end-wall SWD port (its
    JST-to-0.1" cable), then `cargo run --release` in `firmware/feed-app` (probe-rs flashes, resets and shows logs).
    The 36 V supply must be on (the probe doesn't power the board), or USB-C power is enough for the logic.
- **Fuse:** the inlet's fuse drawer, under its C14 bay, is reached from outside through the end wall's opening (cord unplugged).
- **Heat:** the motor is inside and the PCB sits above it. Default run current 3 A (~16 W in the coils), 1 A at standstill.
  PETG's glass transition is ~80 °C; the walls are ≥ 5.8 mm from the motor. On the bench, run it closed for 30 min:
  if the motor case passes ~60 °C or the PSU case passes ~60 °C (the LRS gives full power only up to 50 °C ambient;
  it runs at about a third of its load here), fit the 40 mm fan (exhaust), lower `MOTOR mA` in the menu (light feeds need far
  less), or reprint in ASA (needs an enclosure on the MK3S to print without warping).
- **Order** (on the bench, before the plate goes onto the mill; the box goes on first, the module and the tray go in
  from below, the PCB from above):
  1. Plate: stub bearings and stub, encoder. Put the 4 module bolts (M5×35) into the plate's slots from the chamber side
     now, tips just flush with the outer face (on the mill there is no room for them: the chamber is 35 deep). Shell onto
     the plate edges (back and front screws), heat-set inserts, door on its hinge (pin through the knuckles along the
     back), hanging open.
  2. **Clutch/motor module up through the bottom**: its bearing boss and output shaft slide up the plate's slot until the
     cover's front face is on the plate (checked: nothing in the way on the whole lift). Run the 4 bolts into the cover,
     then the 20T pulley, belt and guard in the chamber.
  3. **Tension block up from below**: its tongue slides up into the slot and closes it; 2× M5 into the plate's legs,
     drawbolt into the cover. Tension the belt, lock the 4 module bolts.
  4. Mains tray, fully built on the bench (PSU in, **inlet clipped into its end face**, earth stud, L/N/PE tied, 36 V pair
     out through the grommet, lid on): **up through the bottom** with the inlet in place (checked, flange included),
     tabs into the plate's rebates (a serrated washer on each tab's M4 hole first), 2× M4 up into the plate. Feed the 36 V pair up beside the motor.
     Recommended extra: a green/yellow lead from the tray's earth stud to an M4 tapped hole in the plate's outer face,
     so the tray stays bonded even with its two screws loose.
  5. Hood off: PCB onto its bosses; plug the 36 V pair into J1, the motor, clutch and encoder leads behind the motor tail.
  6. Limit-switch cable through the end cap's gland; USB-C extension, BOOT/RESET and SWD wires from the end cap to the
     PCB (the cap stays off, beside the box, on its wires).
  7. Fan (optional; it covers the H1 hole's tool path, so after the PCB); hood with its controls.
  8. Close the door: its screw on the front side. Then slide the end cap on along the table axis (its floor under the
     tray's end, its scarf under the door's end) and fit its 3 screws through the shell's walls. Earth test (above)
     before the first plug-in. Then the plate onto the mill.
  - **Service on the mill, from below:** **unplug the mains cord first** (the tray hangs on it otherwise). The end
    cap's 3 screws (slide it off; it hangs on its wires), the door's screw, and the door swings down to the back: the PSU's screws, the belt
    tension, and the mains tray (unplug J1, 2 screws: it drops out with its inlet). **Repeat the earth test every time
    the tray has been out.**
  - **The module can't come out on the mill:** its 20T pulley sits inside the belt guard, which is trapped between the
    plate and the table. Take the plate off the table first, then: door open, tray out, tension block off, belt off, back
    the 4 bolts out of the cover (they stay in the plate), and the module comes down out of the slot.
- **Possible next size cut:** the floor is set by the belt-tension block under the clutch; behind it (from W ≈ 130)
  the floor could step up ~35 mm, under the motor. Not done yet.

## PLACEHOLDERS (measure, then edit `F`)
- `screw_d`, `screw_end_slot_w`, `screw_end_slot_d`, `screw_end_z`: the left leadscrew end and its drive slot.
  - If there is no slot, use a pinned sleeve coupling instead of the tongue.
- `standoffs`: where M6 can go into the table end or the left bracket.
- `motor_angle_deg`: rotate the module if it hits the saddle, the base or the DRO cable at full travel.
- The housing reaches -10 mm in front of the table's front edge (the dial knob, 22 proud, included) and 157 mm below the
  leadscrew: check both against the saddle, the DRO reader and the base at full right travel.
- `chamber`: the minimum is set by the clutch output shaft; the script asserts it fits.
