liorknafo/power-feed-manual-mill/hardware/renders/pcb_bottom.png

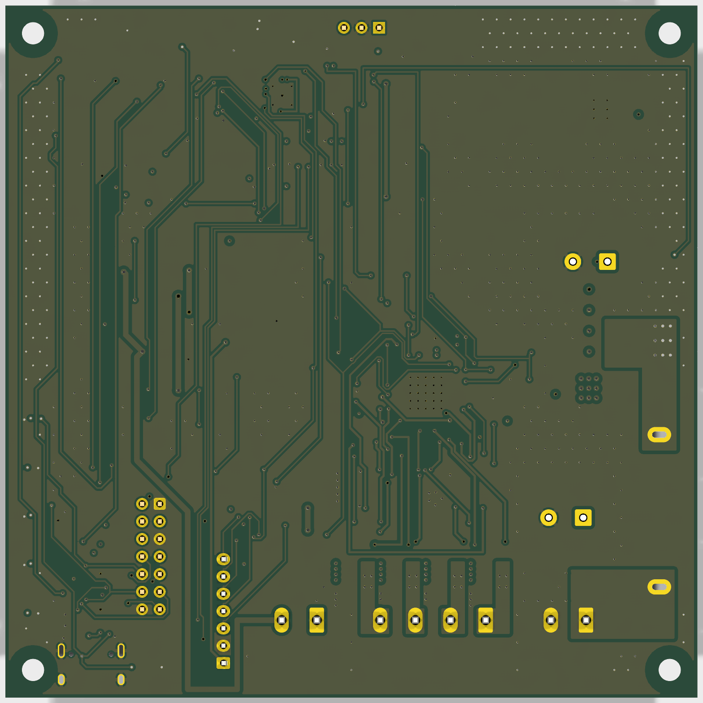
hardware/renders/pcb_bottom.png
