liorknafo/power-feed-manual-mill/hardware/renders/pcb_top.png

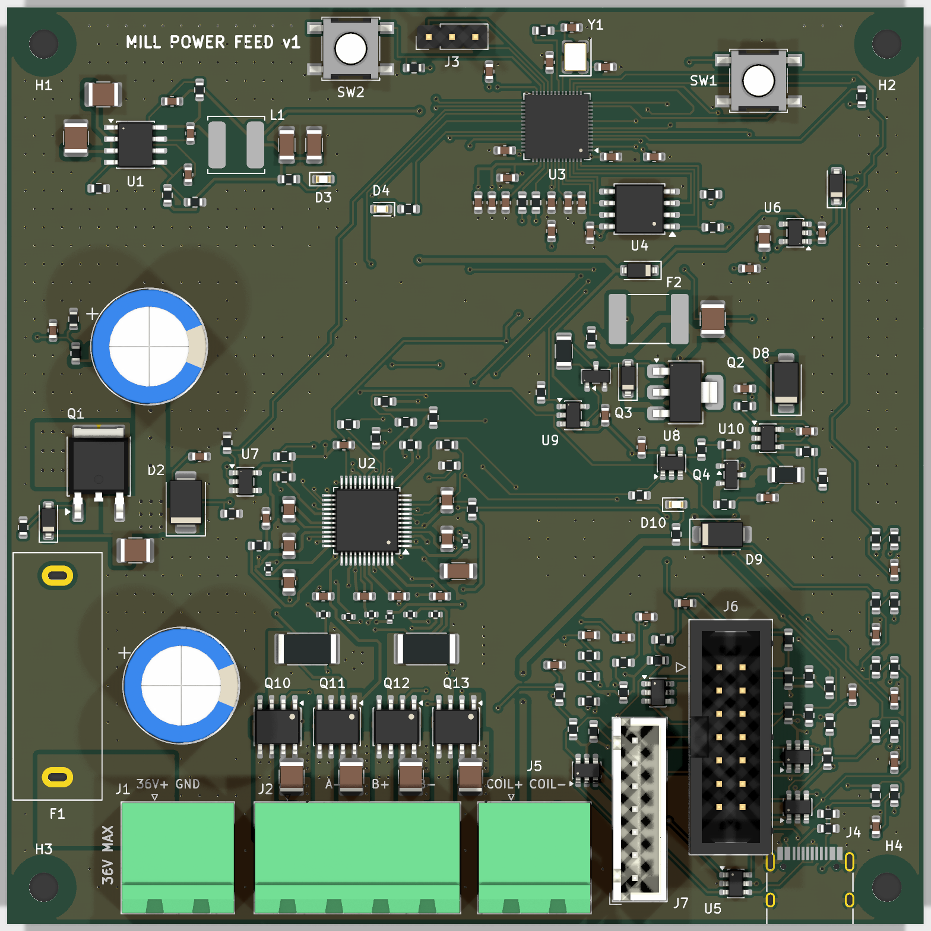
hardware/renders/pcb_top.png
