liorknafo/power-feed-manual-mill/mechanical/solidcraft/renders/feed_unit_back.png

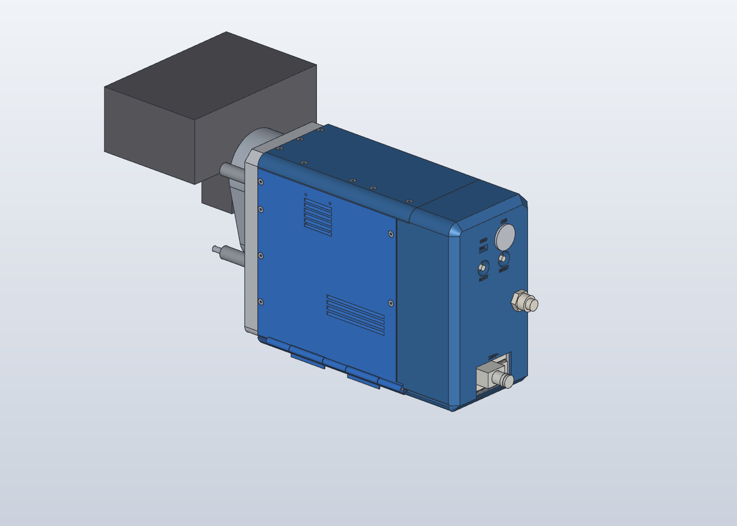
mechanical/solidcraft/renders/feed_unit_back.png
