liorknafo/power-feed-manual-mill/mechanical/solidcraft/renders/mains_tray.png

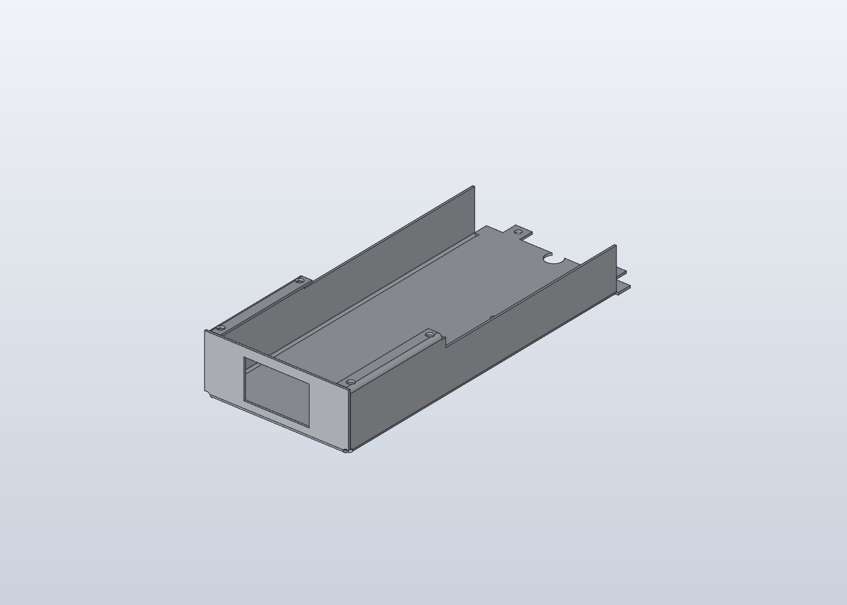
mechanical/solidcraft/renders/mains_tray.png
