liorknafo/power-feed-manual-mill/hardware/fab/power-feed-bom.csv

Comment | Designator | Footprint | LCSC Part # | MPN
2.2nF 50V | C5 | C_0603_1608Metric | C1604 | FH 0603B222K500NT
3.3nF | C6 | C_0603_1608Metric | C1613 | Samsung CL10B332KB8NNNC
22nF 100V | C13 | C_0805_2012Metric | C107137 | Yageo CC0805KRX7R0BB223
470nF | C16 | C_0603_1608Metric | C1623 | Samsung CL10B474KA8NNNC
10uF 25V | C17 | C_1206_3216Metric | C13585 | Samsung CL31A106KBHNNNE
1nF | C51 | C_0603_1608Metric | C1588 | Samsung CL10B102KB8NNNC
470uF 63V | C1,C27 | CP_Radial_D12.5mm_P5.00mm | C407954 | Panasonic EEUFR1J471
10nF | C10,C53,C57,C58,C59,C60 | C_0603_1608Metric | C57112 | FH 0603B103K500NT
100nF 100V | C11,C12,C14 | C_0805_2012Metric | C28233 | Samsung CL21B104KCFNNNE
4.7uF 10V | C15,C45 | C_0805_2012Metric | C1779 | Samsung CL21A475KAQNNNE
100nF | C18,C28,C29,C30,C31,C32,C33,C34,C35,C38,C39,C40,C41,C46,C47,C48,C49,C52,C54,C55,C56,C61 | C_0603_1608Metric | C14663 | Yageo CC0603KRX7R9BB104
220nF 50V | C19,C21,C23,C25 | C_0603_1608Metric | C64705 | Samsung CL10B224KB8NNNC
2.2uF 100V | C2,C3,C4,C20,C22,C24,C26,C50 | C_1210_3225Metric | C86054 | Murata GRM32ER72A225KA35L
1uF | C36,C37,C44 | C_0603_1608Metric | C15849 | Samsung CL10A105KB8NNNC
15pF | C42,C43 | C_0603_1608Metric | C1644 | Samsung CL10C150JB8NNNC
100pF | C7,C62,C63,C64 | C_0603_1608Metric | C14858 | Samsung CL10C101JB8NNNC
22uF 10V | C8,C9 | C_1206_3216Metric | C12891 | Samsung CL31A226KAHNNNE
15V | D1 | D_SOD-123 | C129730 | onsemi MMSZ5245BT1G
SMBJ36A (TVS) | D2 | D_SMB | C114001 | SMBJ36A
12V | D7 | D_SOD-123 | C82050 | onsemi MMSZ5242BT1G
SS210 (fast decay) | D8 | D_SMA | C14996 | SS210
SS210 (freewheel) | D9 | D_SMA | C14996 | SS210
yellow | D10 | LED_0603_1608Metric | C965802 | XINGLIGHT XL-1608UYC-06
USBLC6-4SC6 | D11,D12,D13,D14 | SOT-23-6 | C111212 | USBLC6-4SC6
green | D3,D4 | LED_0603_1608Metric | C12624 | KENTO KT-0603G
B5819W | D5,D6 | D_SOD-123 | C8598 | Changjing B5819W SL
5A T 5x20 | F1 | Fuseholder_XC_BLX-A_5x20mm_P22.00mm | C3131 | BLX-A holder + Littelfuse 0215005.MXP (C142718)
PTC 0.5A/60V | F2 | Fuse_2920_7451Metric | C207082 | Littelfuse 2920L050DR (0.5 A hold, 1 A trip, 60 V)
36V IN | J1 | PhoenixContact_MSTBA_2,5_2-G-5,08_1x02_P5.08mm_Horizontal | C441204 | KF2EDGR-5.08-2P (+ plug KF2EDGK-5.08-2P C440880)
MOTOR A+ A- B+ B- | J2 | PhoenixContact_MSTBA_2,5_4-G-5,08_1x04_P5.08mm_Horizontal | C441206 | KF2EDGR-5.08-4P (+ plug KF2EDGK-5.08-4P C440882)
SWD | J3 | PinHeader_1x03_P2.54mm_Vertical |  | 2.54 mm 1x3 male header, hand-solder (Debug Probe's JST-to-0.1in cable)
USB-C | J4 | USB_C_Receptacle_HRO_TYPE-C-31-M-12 | C165948 | HRO TYPE-C-31-M-12
CLUTCH COIL | J5 | PhoenixContact_MSTBA_2,5_2-G-5,08_1x02_P5.08mm_Horizontal | C441204 | KF2EDGR-5.08-2P (+ plug KF2EDGK-5.08-2P C440880)
PANEL 2x7 IDC | J6 | IDC-Header_2x07_P2.54mm_Vertical | C2977595 | ZHOURI DC3-2.54-14PAS (2x7 shrouded box header)
JST-XH 7p | J7 | JST_XH_B7B-XH-A_1x07_P2.50mm_Vertical | C144398 | JST B7B-XH-A(LF)(SN)
47uH | L1 | L_TDK_VLS6045EX_VLS6045AF | C404505 | TDK VLS6045EX-470M
SQD50P06-15L | Q1 | TO-252-2 | C3281500 | SQD50P06-15L_GE3
AGM60P20R | Q2 | SOT-223-3_TabPin2 | C6719402 | AGM60P20R
2N7002 | Q3 | SOT-23 | C8545 | 2N7002
SI2308A | Q4 | SOT-23 | C347491 | UMW SI2308A
CSD88537ND | Q10,Q11,Q12,Q13 | SOIC-8_3.9x4.9mm_P1.27mm | C117439 | CSD88537ND
41.2k | R2 | R_0603_1608Metric | C2930101 | FOJAN FRC0603F4122TS
31.6k | R4 | R_0603_1608Metric | C25967 | UNI-ROYAL 0603WAF3162T5E
4.7k | R6 | R_0603_1608Metric | C23162 | UNI-ROYAL 0603WAF4701T5E
7.5k | R8 | R_0603_1608Metric | C23234 | UNI-ROYAL 0603WAF7501T5E
2.2 | R9 | R_0603_1608Metric | C22939 | UNI-ROYAL 0603WAF220KT5E
330 | R43 | R_0603_1608Metric | C23138 | UNI-ROYAL 0603WAF3300T5E
4.7k | R48 | R_1206_3216Metric | C17936 | UNI-ROYAL 1206W4F4701T5E
0.1 1% 1W | R51 | R_1206_3216Metric | C7467250 | FOJAN FRM121WFR100TM
22k | R1,R52 | R_0603_1608Metric | C31850 | UNI-ROYAL 0603WAF2202T5E
4.7 | R10,R11,R12,R13,R14,R15,R16,R17 | R_0402_1005Metric | C25121 | UNI-ROYAL 0402WGF470KTCE
0.05 1% 3W | R18,R21 | R_2512_6332Metric | C346860 | CSM2512FT50L0
47 | R19,R20,R22,R23 | R_0603_1608Metric | C23182 | UNI-ROYAL 0603WAF470JT5E
10k | R24,R27,R37,R38,R39,R45,R55,R57,R59,R61,R63,R65,R67,R69,R71,R79,R80 | R_0603_1608Metric | C25804 | UNI-ROYAL 0603WAF1002T5E
1k | R25,R26,R28,R44,R53,R56,R58,R60,R62,R64,R66,R68,R70,R72 | R_0603_1608Metric | C21190 | UNI-ROYAL 0603WAF1001T5E
5.1k | R29,R30 | R_0603_1608Metric | C23186 | UNI-ROYAL 0603WAF5101T5E
100k | R3,R7,R40,R41,R42,R46,R50 | R_0603_1608Metric | C25803 | UNI-ROYAL 0603WAF1003T5E
27 | R31,R32 | R_0603_1608Metric | C25190 | UNI-ROYAL 0603WAF270JT5E
33 | R33,R34,R35,R36 | R_0603_1608Metric | C23140 | UNI-ROYAL 0603WAF330JT5E
2.2k | R47,R73,R75,R77 | R_0603_1608Metric | C4190 | UNI-ROYAL 0603WAF2201T5E
100 | R49,R74,R76,R78,R81,R82 | R_0603_1608Metric | C22775 | UNI-ROYAL 0603WAF1000T5E
200k | R5,R54 | R_0603_1608Metric | C25811 | UNI-ROYAL 0603WAF2003T5E
BOOTSEL | SW1 | SW_SPST_B3S-1000 | C2733655 | Omron B3S-1000
RESET | SW2 | SW_SPST_B3S-1000 | C2733655 | Omron B3S-1000
LM5164DDAR | U1 | HSOP-8-1EP_3.9x4.9mm_P1.27mm_EP2.41x3.1mm_ThermalVias | C477928 | LM5164DDAR
TMC5160A-TA | U2 | TQFP-48-1EP_7x7mm_P0.5mm_EP5x5mm_ThermalVias | C516354
RP2040 | U3 | QFN-56-1EP_7x7mm_P0.4mm_EP3.2x3.2mm_ThermalVias | C2040 | Raspberry Pi RP2040
W25Q128JVS | U4 | SOIC-8_5.3x5.3mm_P1.27mm | C113767 | Winbond W25Q128JVSIQ (W25Q16 is out of stock; firmware uses the first 2 MB)
USBLC6-2SC6 | U5 | SOT-23-6 | C7519 | STMicroelectronics USBLC6-2SC6
AP2112K-3.3 | U6 | SOT-23-5 | C51118 | Diodes AP2112K-3.3TRG1
74LVC1G00 | U7 | SOT-23-5 | C7826 | SN74LVC1G00DBVR
TLV9061 | U10 | SOT-23-5 | C398358 | TLV9061IDBVR
74AHCT1G08 | U8,U9 | SOT-23-5 | C113521 | SN74AHCT1G08DBVR
12MHz | Y1 | Crystal_SMD_3225-4Pin_3.2x2.5mm | C20625731 | Abracon ABM8-272-T3 (12 MHz, CL 10 pF, ESR 50R; RPi-approved)
