liorknafo/power-feed-manual-mill/mechanical/solidcraft/flat/mains_tray_lid_flat.dxf

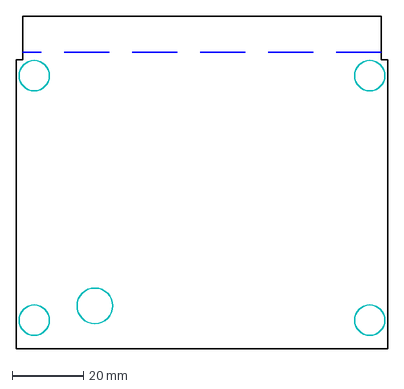
[picture p9: CAD file, 2026-11-13]
mechanical/solidcraft/flat/mains_tray_lid_flat.dxf
104.0 x 93.1 mm
