liorknafo/power-feed-manual-mill/mechanical/solidcraft/flat/mains_tray_flat.dxf

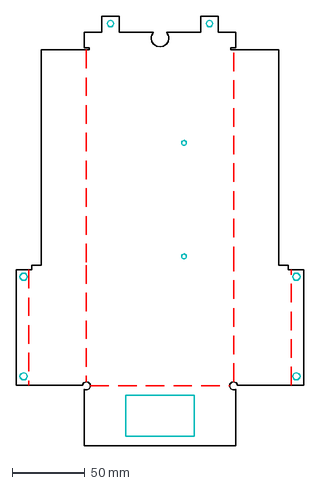
[picture p10: CAD file, 2026-11-13]
mechanical/solidcraft/flat/mains_tray_flat.dxf
197.5 x 295.1 mm
