liorknafo/power-feed-manual-mill/hardware/kicad/power-feed.kicad_pcb

## KiCad design hardware/kicad/power-feed.kicad_pcb (2026-10-21)

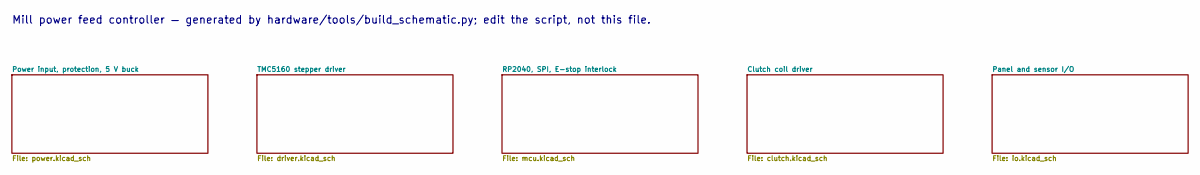
[picture p11: schematic power-feed.kicad_sch, Mill power feed controller]

Notes on the sheet:
Mill power feed controller — generated by hardware/tools/build_schematic.py; edit the script, not this file.

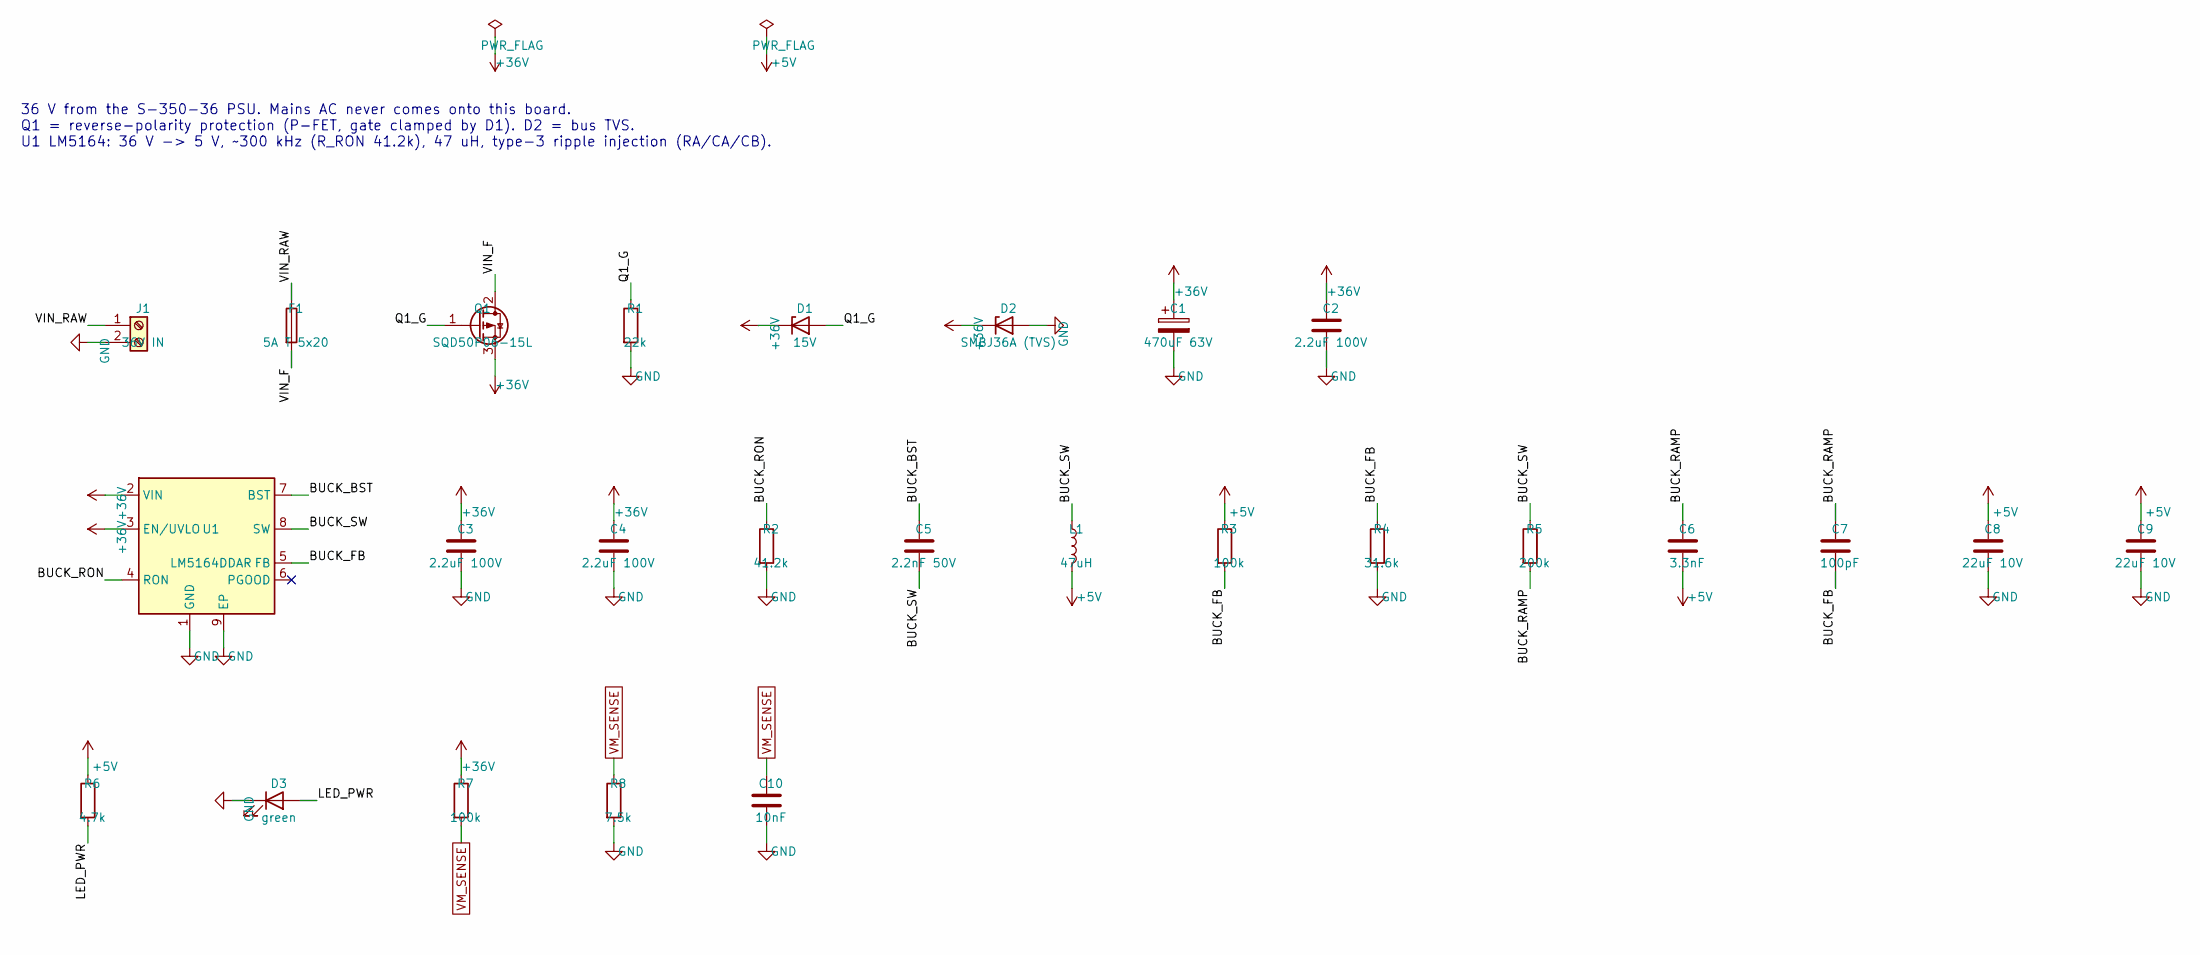
[picture p12: schematic power.kicad_sch, Power input, protection, 5 V buck]

Parts:
C1: 470uF 63V; CP_Radial_D12.5mm_P5.00mm; MPN Panasonic EEUFR1J471; LCSC C407954
C2, C3, C4: 2.2uF 100V; C_1210_3225Metric; MPN Murata GRM32ER72A225KA35L; LCSC C86054
C5: 2.2nF 50V; C_0603_1608Metric; MPN FH 0603B222K500NT; LCSC C1604
C6: 3.3nF; C_0603_1608Metric; MPN Samsung CL10B332KB8NNNC; LCSC C1613
C7: 100pF; C_0603_1608Metric; MPN Samsung CL10C101JB8NNNC; LCSC C14858
C8, C9: 22uF 10V; C_1206_3216Metric; MPN Samsung CL31A226KAHNNNE; LCSC C12891
C10: 10nF; C_0603_1608Metric; MPN FH 0603B103K500NT; LCSC C57112
D1: 15V; D_SOD-123; MPN onsemi MMSZ5245BT1G; LCSC C129730
D2: SMBJ36A (TVS); D_SMB; MPN SMBJ36A; LCSC C114001
D3: green; LED_0603_1608Metric; MPN KENTO KT-0603G; LCSC C12624
F1: 5A T 5x20; Fuseholder_XC_BLX-A_5x20mm_P22.00mm; MPN BLX-A holder + Littelfuse 0215005.MXP (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; LCSC C3131
J1: 36V IN; PhoenixContact_MSTBA_2,5_2-G-5,08_1x02_P5.08mm_Horizontal; MPN KF2EDGR-5.08-2P (+ plug KF2EDGK-5.08-2P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; LCSC C441204
L1: 47uH; L_TDK_VLS6045EX_VLS6045AF; MPN TDK VLS6045EX-470M; LCSC C404505
Q1: SQD50P06-15L; TO-252-2; MPN SQD50P06-15L_GE3; LCSC C3281500
R1: 22k; R_0603_1608Metric; MPN UNI-ROYAL 0603WAF2202T5E; LCSC C31850
R2: 41.2k; R_0603_1608Metric; MPN FOJAN FRC0603F4122TS; LCSC C2930101
R3, R7: 100k; R_0603_1608Metric; MPN UNI-ROYAL 0603WAF1003T5E; LCSC C25803
R4: 31.6k; R_0603_1608Metric; MPN UNI-ROYAL 0603WAF3162T5E; LCSC C25967
R5: 200k; R_0603_1608Metric; MPN UNI-ROYAL 0603WAF2003T5E; LCSC C25811
R6: 4.7k; R_0603_1608Metric; MPN UNI-ROYAL 0603WAF4701T5E; LCSC C23162
R8: 7.5k; R_0603_1608Metric; MPN UNI-ROYAL 0603WAF7501T5E; LCSC C23234
U1: LM5164DDAR; HSOP-8-1EP_3.9x4.9mm_P1.27mm_EP2.41x3.1mm_ThermalVias; MPN LM5164DDAR; LCSC C477928

Connections:
+5V: C6.2, C8.1, C9.1, L1.2, R3.1, R6.1; also elsewhere on the board
+36V: C1.1, C2.1, C3.1, C4.1, D1.1 (K), D2.1 (K), Q1.3 (S), R7.1, U1.2 (VIN), U1.3 (EN/UVLO); also elsewhere on the board
/Power input, protection, 5 V buck/BUCK_BST: C5.1, U1.7 (BST)
/Power input, protection, 5 V buck/BUCK_FB: C7.2, R3.2, R4.1, U1.5 (FB)
/Power input, protection, 5 V buck/BUCK_RAMP: C6.1, C7.1, R5.2
/Power input, protection, 5 V buck/BUCK_RON: R2.1, U1.4 (RON)
/Power input, protection, 5 V buck/BUCK_SW: C5.2, L1.1, R5.1, U1.8 (SW)
/Power input, protection, 5 V buck/LED_PWR: D3.2 (A), R6.2
/Power input, protection, 5 V buck/Q1_G: D1.2 (A), Q1.1 (G), R1.1
/Power input, protection, 5 V buck/VIN_F: F1.2, Q1.2 (D)
/Power input, protection, 5 V buck/VIN_RAW: F1.1, J1.1
GND: C1.2, C2.2, C3.2, C4.2, C8.2, C9.2, C10.2, D2.2 (A), D3.1 (K), J1.2, R1.2, R2.2, R4.2, R8.2, U1.1 (GND), U1.9 (EP); also elsewhere on the board
VM_SENSE: C10.1, R7.2, R8.1; also elsewhere on the board

Notes on the sheet:
36 V from the S-350-36 PSU. Mains AC never comes onto this board. Q1 = reverse-polarity protection (P-FET, gate clamped by D1). D2 = bus TVS. U1 LM5164: 36 V -> 5 V, ~300 kHz (R_RON 41.2k), 47 uH, type-3 ripple injection (RA/CA/CB).

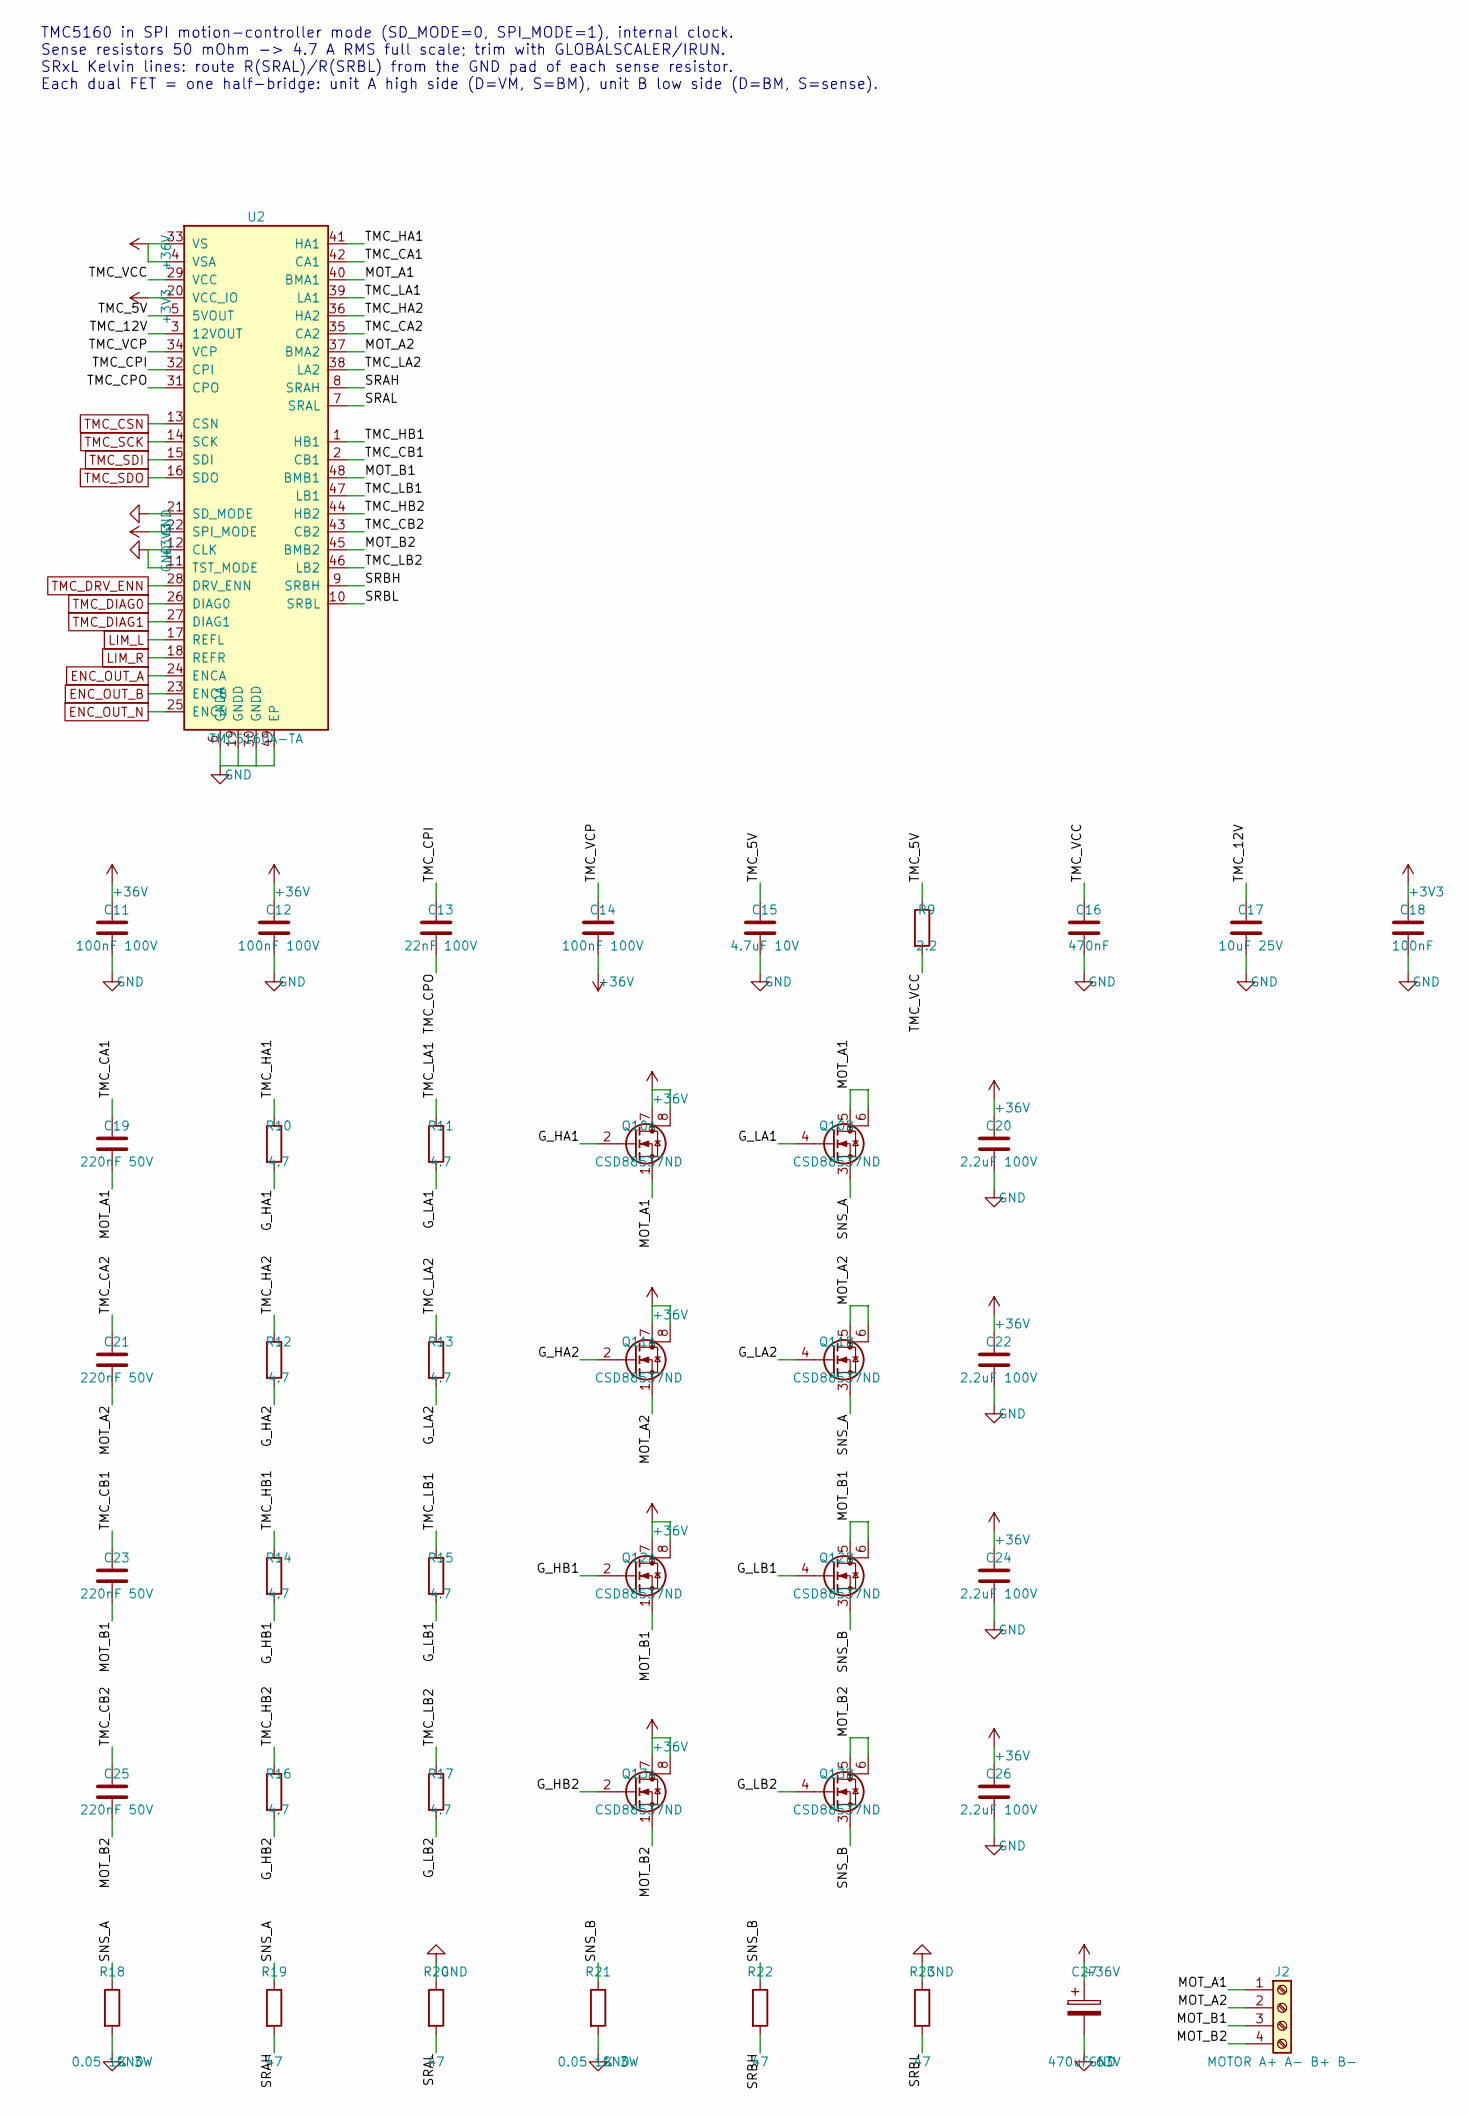
[picture p13: schematic driver.kicad_sch, TMC5160 stepper driver]

Parts:
C11, C12, C14: 100nF 100V; C_0805_2012Metric; MPN Samsung CL21B104KCFNNNE; LCSC C28233
C13: 22nF 100V; C_0805_2012Metric; MPN Yageo CC0805KRX7R0BB223; LCSC C107137
C15: 4.7uF 10V; C_0805_2012Metric; MPN Samsung CL21A475KAQNNNE; LCSC C1779
C16: 470nF; C_0603_1608Metric; MPN Samsung CL10B474KA8NNNC; LCSC C1623
C17: 10uF 25V; C_1206_3216Metric; MPN Samsung CL31A106KBHNNNE; LCSC C13585
C18: 100nF; C_0603_1608Metric; MPN Yageo CC0603KRX7R9BB104; LCSC C14663
C19, C21, C23, C25: 220nF 50V; C_0603_1608Metric; MPN Samsung CL10B224KB8NNNC; LCSC C64705
C20, C22, C24, C26: 2.2uF 100V; C_1210_3225Metric; MPN Murata GRM32ER72A225KA35L; LCSC C86054
C27: 470uF 63V; CP_Radial_D12.5mm_P5.00mm; MPN Panasonic EEUFR1J471; LCSC C407954
J2: MOTOR A+ A- B+ B-; PhoenixContact_MSTBA_2,5_4-G-5,08_1x04_P5.08mm_Horizontal; MPN KF2EDGR-5.08-4P (+ plug KF2EDGK-5.08-4P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; LCSC C441206
Q10, Q11, Q12, Q13: CSD88537ND; SOIC-8_3.9x4.9mm_P1.27mm; MPN CSD88537ND; LCSC C117439
R9: 2.2; R_0603_1608Metric; MPN UNI-ROYAL 0603WAF220KT5E; LCSC C22939
R10, R11, R12, R13, R14, R15, R16, R17: 4.7; R_0402_1005Metric; MPN UNI-ROYAL 0402WGF470KTCE; LCSC C25121
R18, R21: 0.05 1% 3W; R_2512_6332Metric; MPN CSM2512FT50L0; LCSC C346860
R19, R20, R22, R23: 47; R_0603_1608Metric; MPN UNI-ROYAL 0603WAF470JT5E; LCSC C23182
U2: TMC5160A-TA; TQFP-48-1EP_7x7mm_P0.5mm_EP5x5mm_ThermalVias; LCSC C516354

Connections:
+3V3: C18.1, U2.20 (VCC_IO), U2.22 (SPI_MODE); also elsewhere on the board
+36V: C11.1, C12.1, C14.2, C20.1, C22.1, C24.1, C26.1, C27.1, Q10.7 (D), Q10.8 (D), Q11.7 (D), Q11.8 (D), Q12.7 (D), Q12.8 (D), Q13.7 (D), Q13.8 (D), U2.4 (VSA), U2.33 (VS); also elsewhere on the board
/TMC5160 stepper driver/G_HA1: Q10.2 (G), R10.2
/TMC5160 stepper driver/G_HA2: Q11.2 (G), R12.2
/TMC5160 stepper driver/G_HB1: Q12.2 (G), R14.2
/TMC5160 stepper driver/G_HB2: Q13.2 (G), R16.2
/TMC5160 stepper driver/G_LA1: Q10.4 (G), R11.2
/TMC5160 stepper driver/G_LA2: Q11.4 (G), R13.2
/TMC5160 stepper driver/G_LB1: Q12.4 (G), R15.2
/TMC5160 stepper driver/G_LB2: Q13.4 (G), R17.2
/TMC5160 stepper driver/MOT_A1: C19.2, J2.1, Q10.1 (S), Q10.5 (D), Q10.6 (D), U2.40 (BMA1)
/TMC5160 stepper driver/MOT_A2: C21.2, J2.2, Q11.1 (S), Q11.5 (D), Q11.6 (D), U2.37 (BMA2)
/TMC5160 stepper driver/MOT_B1: C23.2, J2.3, Q12.1 (S), Q12.5 (D), Q12.6 (D), U2.48 (BMB1)
/TMC5160 stepper driver/MOT_B2: C25.2, J2.4, Q13.1 (S), Q13.5 (D), Q13.6 (D), U2.45 (BMB2)
/TMC5160 stepper driver/SNS_A: Q10.3 (S), Q11.3 (S), R18.1, R19.1
/TMC5160 stepper driver/SNS_B: Q12.3 (S), Q13.3 (S), R21.1, R22.1
/TMC5160 stepper driver/SRAH: R19.2, U2.8 (SRAH)
/TMC5160 stepper driver/SRAL: R20.2, U2.7 (SRAL)
/TMC5160 stepper driver/SRBH: R22.2, U2.9 (SRBH)
/TMC5160 stepper driver/SRBL: R23.2, U2.10 (SRBL)
/TMC5160 stepper driver/TMC_5V: C15.1, R9.1, U2.5 (5VOUT)
/TMC5160 stepper driver/TMC_12V: C17.1, U2.3 (12VOUT)
/TMC5160 stepper driver/TMC_CA1: C19.1, U2.42 (CA1)
/TMC5160 stepper driver/TMC_CA2: C21.1, U2.35 (CA2)
/TMC5160 stepper driver/TMC_CB1: C23.1, U2.2 (CB1)
/TMC5160 stepper driver/TMC_CB2: C25.1, U2.43 (CB2)
/TMC5160 stepper driver/TMC_CPI: C13.1, U2.32 (CPI)
/TMC5160 stepper driver/TMC_CPO: C13.2, U2.31 (CPO)
/TMC5160 stepper driver/TMC_HA1: R10.1, U2.41 (HA1)
/TMC5160 stepper driver/TMC_HA2: R12.1, U2.36 (HA2)
/TMC5160 stepper driver/TMC_HB1: R14.1, U2.1 (HB1)
/TMC5160 stepper driver/TMC_HB2: R16.1, U2.44 (HB2)
/TMC5160 stepper driver/TMC_LA1: R11.1, U2.39 (LA1)
/TMC5160 stepper driver/TMC_LA2: R13.1, U2.38 (LA2)
/TMC5160 stepper driver/TMC_LB1: R15.1, U2.47 (LB1)
/TMC5160 stepper driver/TMC_LB2: R17.1, U2.46 (LB2)
/TMC5160 stepper driver/TMC_VCC: C16.1, R9.2, U2.29 (VCC)
/TMC5160 stepper driver/TMC_VCP: C14.1, U2.34 (VCP)
ENC_OUT_A: U2.24 (ENCA); also elsewhere on the board
ENC_OUT_B: U2.23 (ENCB); also elsewhere on the board
ENC_OUT_N: U2.25 (ENCN); also elsewhere on the board
GND: C11.2, C12.2, C15.2, C16.2, C17.2, C18.2, C20.2, C22.2, C24.2, C26.2, C27.2, R18.2, R20.1, R21.2, R23.1, U2.6 (GNDA), U2.11 (TST_MODE), U2.12 (CLK), U2.19 (GNDD), U2.21 (SD_MODE), U2.30 (GNDD), U2.49 (EP); also elsewhere on the board
LIM_L: U2.17 (REFL); also elsewhere on the board
LIM_R: U2.18 (REFR); also elsewhere on the board
TMC_CSN: U2.13 (CSN); also elsewhere on the board
TMC_DIAG0: U2.26 (DIAG0); also elsewhere on the board
TMC_DIAG1: U2.27 (DIAG1); also elsewhere on the board
TMC_DRV_ENN: U2.28 (DRV_ENN); also elsewhere on the board
TMC_SCK: U2.14 (SCK); also elsewhere on the board
TMC_SDI: U2.15 (SDI); also elsewhere on the board
TMC_SDO: U2.16 (SDO); also elsewhere on the board

Notes on the sheet:
TMC5160 in SPI motion-controller mode (SD_MODE=0, SPI_MODE=1), internal clock. Sense resistors 50 mOhm -> 4.7 A RMS full scale; trim with GLOBALSCALER/IRUN. SRxL Kelvin lines: route R(SRAL)/R(SRBL) from the GND pad of each sense resistor. Each dual FET = one half-bridge: unit A high side (D=VM, S=B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

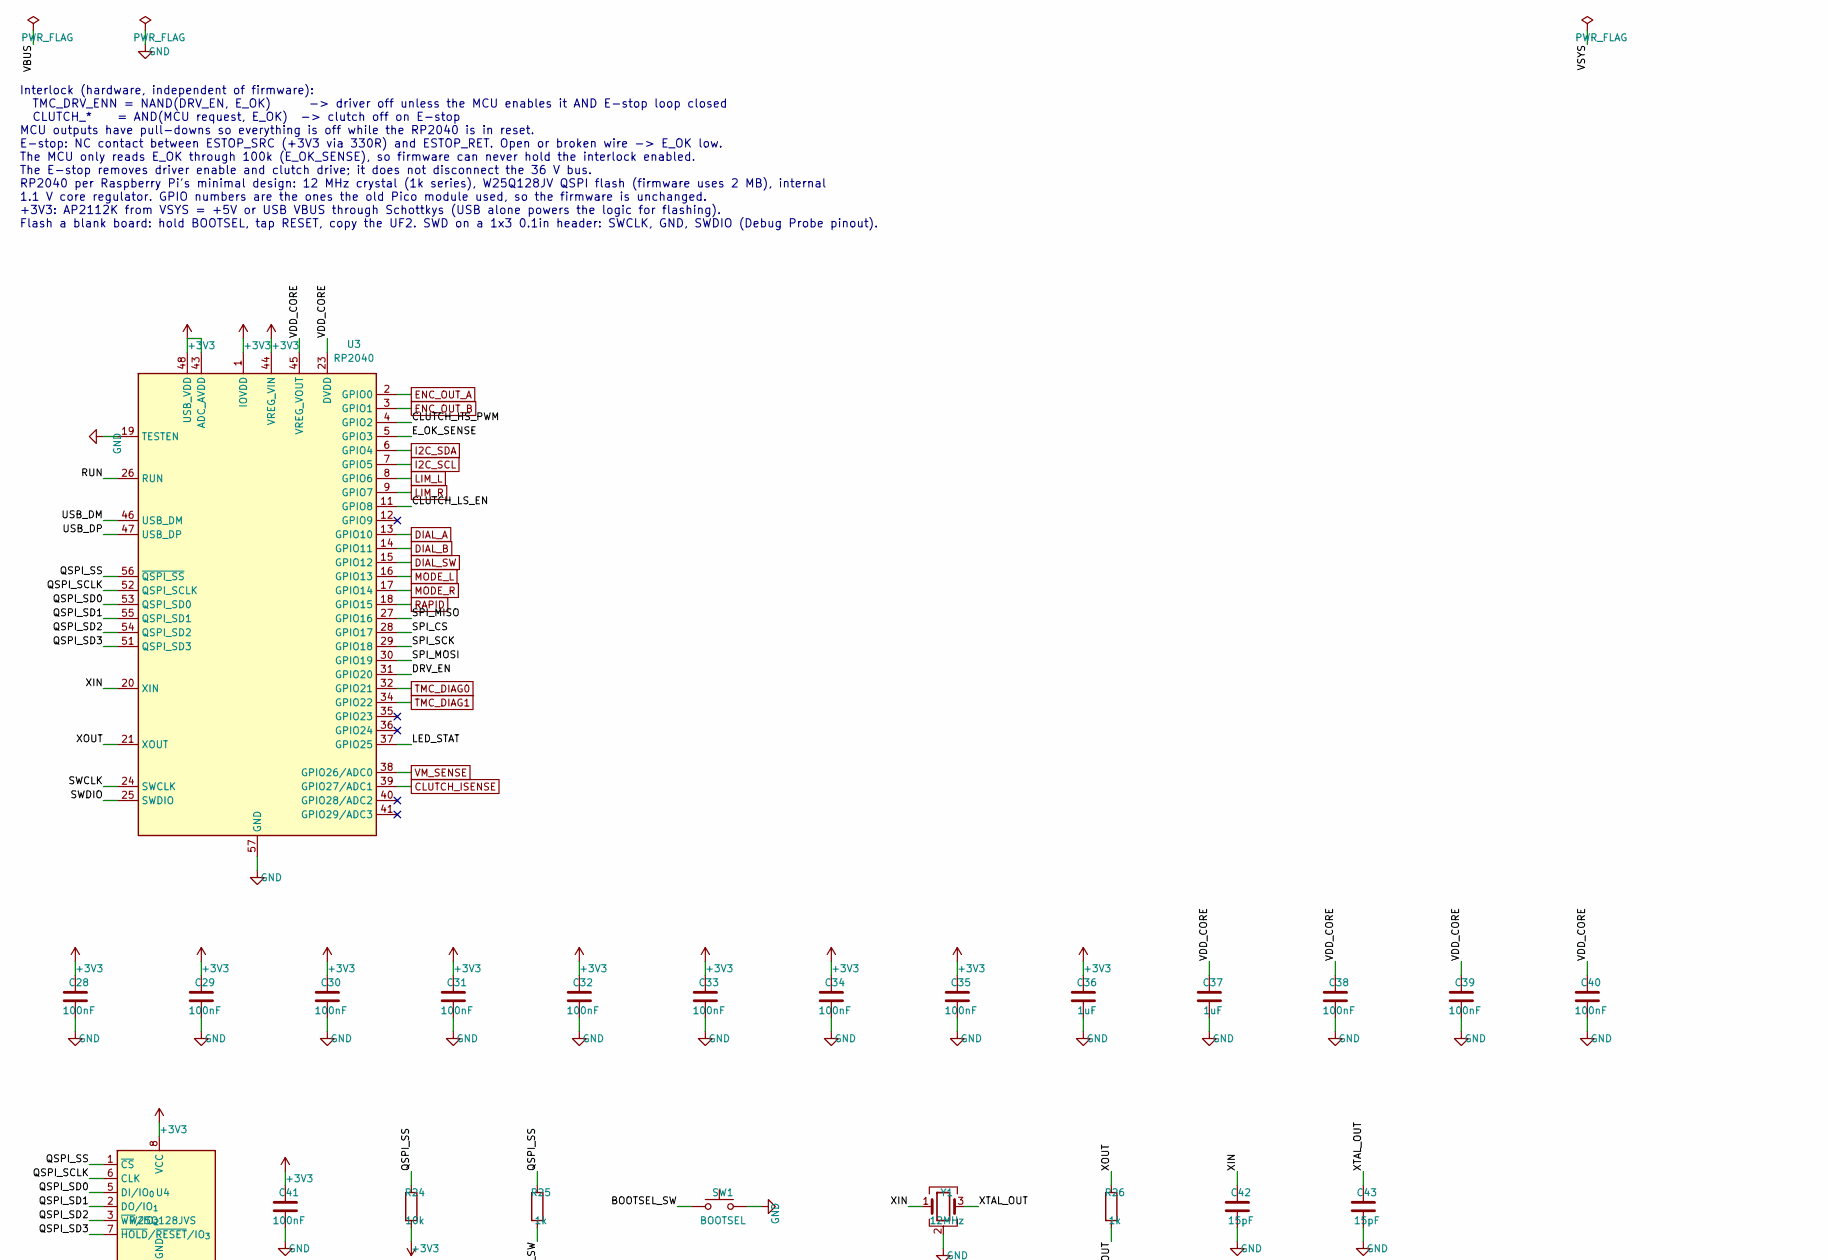
[picture p14: schematic mcu.kicad_sch, RP2040, SPI, E-stop interlock, part in row 1, column 1]

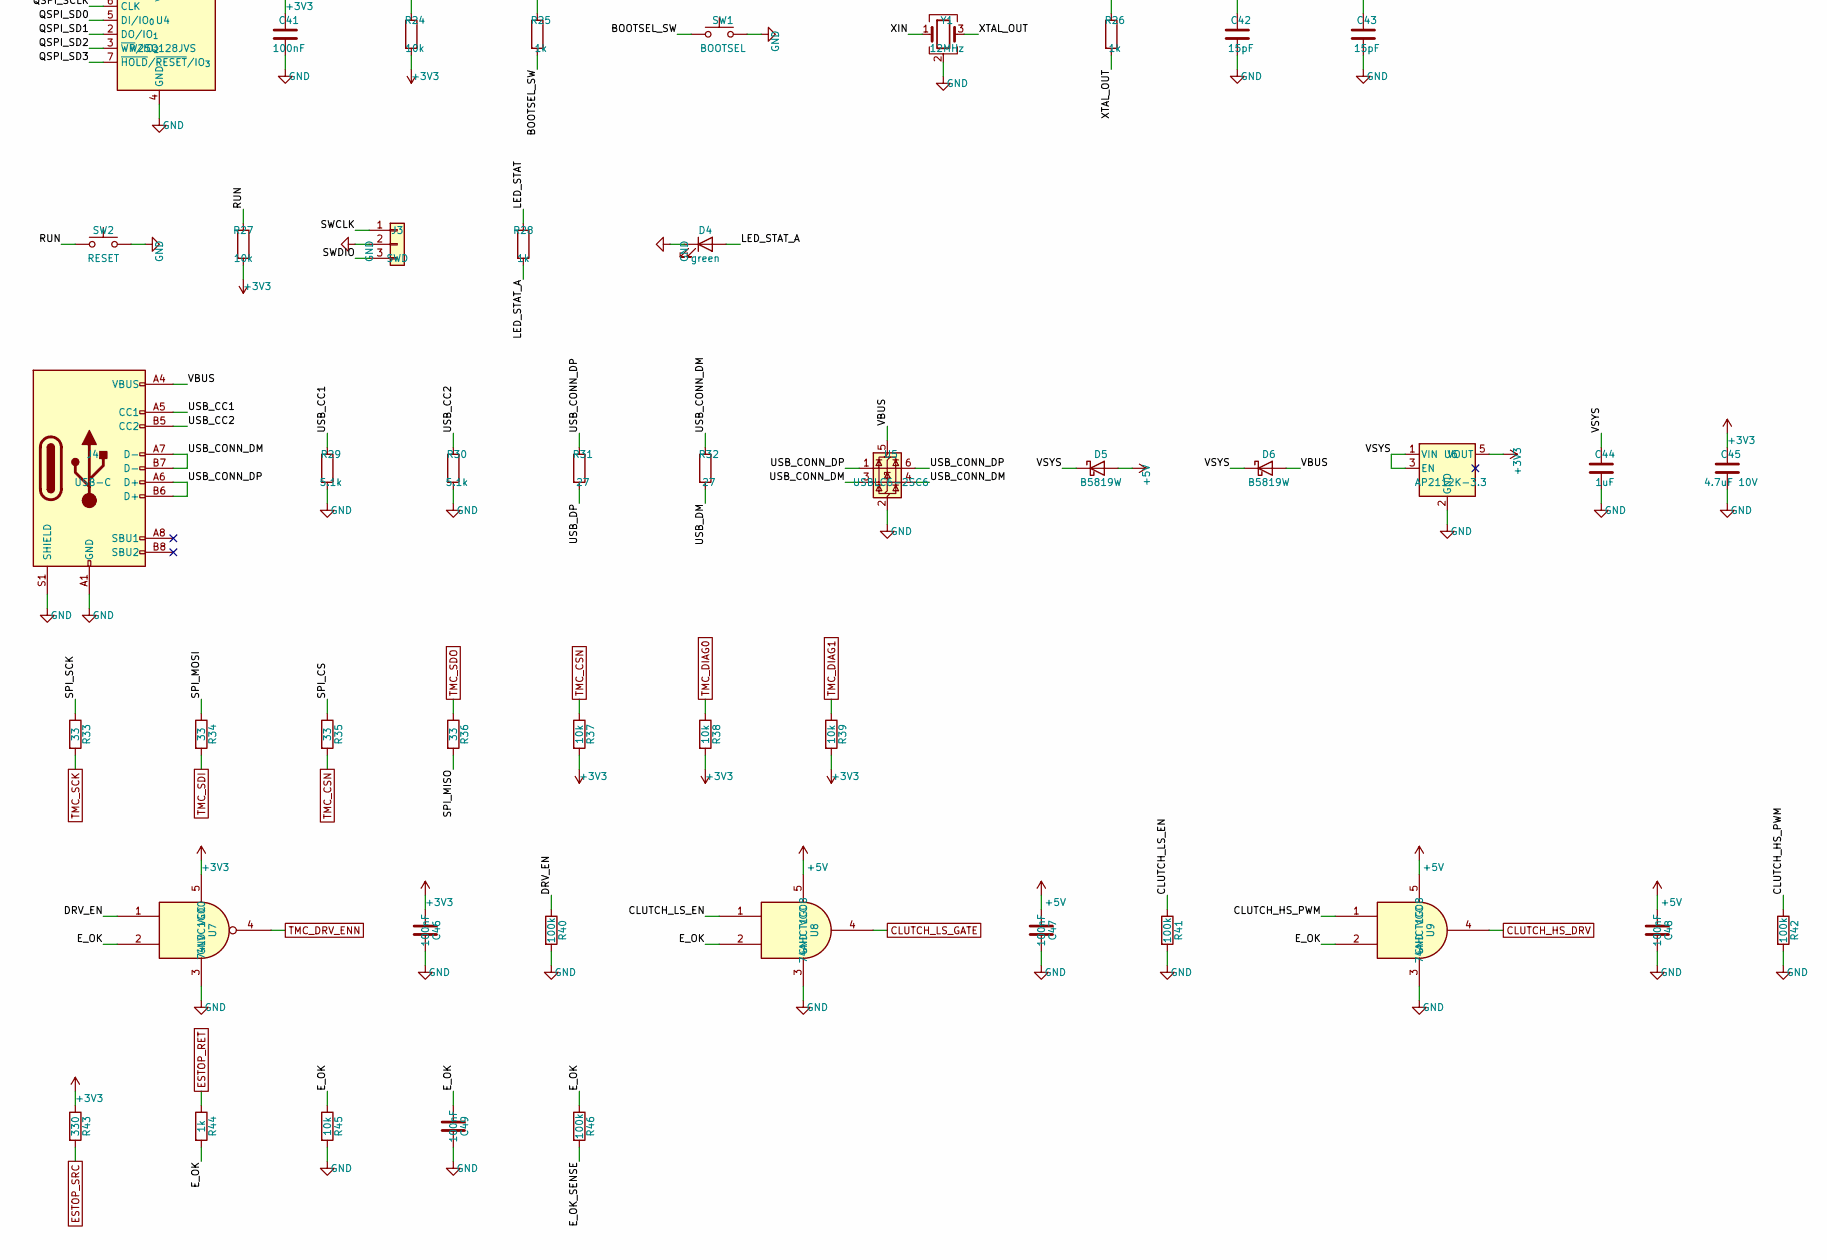
[picture p15: schematic mcu.kicad_sch, RP2040, SPI, E-stop interlock, part in row 2, column 1]

Parts:
C28, C29, C30, C31, C32, C33, C34, C35, C38, C39, C40, C41, C46, C47, C48, C49: 100nF; C_0603_1608Metric; MPN Yageo CC0603KRX7R9BB104; LCSC C14663
C36, C37, C44: 1uF; C_0603_1608Metric; MPN Samsung CL10A105KB8NNNC; LCSC C15849
C42, C43: 15pF; C_0603_1608Metric; MPN Samsung CL10C150JB8NNNC; LCSC C1644
C45: 4.7uF 10V; C_0805_2012Metric; MPN Samsung CL21A475KAQNNNE; LCSC C1779
D4: green; LED_0603_1608Metric; MPN KENTO KT-0603G; LCSC C12624
D5, D6: B5819W; D_SOD-123; MPN Changjing B5819W SL; LCSC C8598
J3: SWD; PinHeader_1x03_P2.54mm_Vertical; MPN 2.54 mm 1x3 male header, hand-solder (D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
J4: USB-C; USB_C_Receptacle_HRO_TYPE-C-31-M-12; MPN HRO TYPE-C-31-M-12; LCSC C165948
R24, R27, R37, R38, R39, R45: 10k; R_0603_1608Metric; MPN UNI-ROYAL 0603WAF1002T5E; LCSC C25804
R25, R26, R28, R44: 1k; R_0603_1608Metric; MPN UNI-ROYAL 0603WAF1001T5E; LCSC C21190
R29, R30: 5.1k; R_0603_1608Metric; MPN UNI-ROYAL 0603WAF5101T5E; LCSC C23186
R31, R32: 27; R_0603_1608Metric; MPN UNI-ROYAL 0603WAF270JT5E; LCSC C25190
R33, R34, R35, R36: 33; R_0603_1608Metric; MPN UNI-ROYAL 0603WAF330JT5E; LCSC C23140
R40, R41, R42, R46: 100k; R_0603_1608Metric; MPN UNI-ROYAL 0603WAF1003T5E; LCSC C25803
R43: 330; R_0603_1608Metric; MPN UNI-ROYAL 0603WAF3300T5E; LCSC C23138
SW1: BOOTSEL; SW_SPST_B3S-1000; MPN Omron B3S-1000; LCSC C2733655
SW2: RESET; SW_SPST_B3S-1000; MPN Omron B3S-1000; LCSC C2733655
U3: RP2040; QFN-56-1EP_7x7mm_P0.4mm_EP3.2x3.2mm_ThermalVias; MPN Raspberry Pi RP2040; LCSC C2040
U4: W25Q128JVS; SOIC-8_5.3x5.3mm_P1.27mm; MPN Winbond W25Q128JVSIQ (W25Q16 is out of 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; LCSC C113767
U5: USBLC6-2SC6; SOT-23-6; MPN STMicroelectronics USBLC6-2SC6; LCSC C7519
U6: AP2112K-3.3; SOT-23-5; MPN Diodes AP2112K-3.3TRG1; LCSC C51118
U7: 74LVC1G00; SOT-23-5; MPN SN74LVC1G00DBVR; LCSC C7826
U8, U9: 74AHCT1G08; SOT-23-5; MPN SN74AHCT1G08DBVR; LCSC C113521
Y1: 12MHz; Crystal_SMD_3225-4Pin_3.2x2.5mm; MPN Abracon ABM8-272-T3 (12 MHz, CL 10 pF, 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; LCSC C20625731

Connections:
+3V3: C28.1, C29.1, C30.1, C31.1, C32.1, C33.1, C34.1, C35.1, C36.1, C41.1, C45.1, C46.1, R24.2, R27.2, R37.2, R38.2, R39.2, R43.1, U3.1 (IOVDD), U3.10 (IOVDD), U3.22 (IOVDD), U3.33 (IOVDD), U3.42 (IOVDD), U3.43 (ADC_AVDD), U3.44 (VREG_VIN), U3.48 (USB_VDD), U3.49 (IOVDD), U4.8 (VCC), U6.5 (VOUT), U7.5 (VCC); also elsewhere on the board
+5V: C47.1, C48.1, D5.2 (A), U8.5 (VCC), U9.5 (VCC); also elsewhere on the board
/RP2040, SPI, E-stop interlock/BOOTSEL_SW: R25.2, SW1.1
/RP2040, SPI, E-stop interlock/CLUTCH_HS_PWM: R42.1, U3.4 (GPIO2), U9.1
/RP2040, SPI, E-stop interlock/CLUTCH_LS_EN: R41.1, U3.11 (GPIO8), U8.1
/RP2040, SPI, E-stop interlock/DRV_EN: R40.1, U3.31 (GPIO20), U7.1
/RP2040, SPI, E-stop interlock/E_OK: C49.1, R44.2, R45.1, R46.1, U7.2, U8.2, U9.2
/RP2040, SPI, E-stop interlock/E_OK_SENSE: R46.2, U3.5 (GPIO3)
/RP2040, SPI, E-stop interlock/LED_STAT: R28.1, U3.37 (GPIO25)
/RP2040, SPI, E-stop interlock/LED_STAT_A: D4.2 (A), R28.2
/RP2040, SPI, E-stop interlock/QSPI_SCLK: U3.52 (QSPI_SCLK), U4.6 (CLK)
/RP2040, SPI, E-stop interlock/QSPI_SD0: U3.53 (QSPI_SD0), U4.5 (DI/IO_{0})
/RP2040, SPI, E-stop interlock/QSPI_SD1: U3.55 (QSPI_SD1), U4.2 (DO/IO_{1})
/RP2040, SPI, E-stop interlock/QSPI_SD2: U3.54 (QSPI_SD2), U4.3 (~WP/IO_{2})
/RP2040, SPI, E-stop interlock/QSPI_SD3: U3.51 (QSPI_SD3), U4.7 (~HOLD/~RESET/IO_{3})
/RP2040, SPI, E-stop interlock/QSPI_SS: R24.1, R25.1, U3.56 (~QSPI_SS), U4.1 (~CS)
/RP2040, SPI, E-stop interlock/RUN: R27.1, SW2.1, U3.26 (RUN)
/RP2040, SPI, E-stop interlock/SPI_CS: R35.1, U3.28 (GPIO17)
/RP2040, SPI, E-stop interlock/SPI_MISO: R36.2, U3.27 (GPIO16)
/RP2040, SPI, E-stop interlock/SPI_MOSI: R34.1, U3.30 (GPIO19)
/RP2040, SPI, E-stop interlock/SPI_SCK: R33.1, U3.29 (GPIO18)
/RP2040, SPI, E-stop interlock/SWCLK: J3.1, U3.24 (SWCLK)
/RP2040, SPI, E-stop interlock/SWDIO: J3.3, U3.25 (SWDIO)
/RP2040, SPI, E-stop interlock/USB_CC1: J4.A5 (CC1), R29.1
/RP2040, SPI, E-stop interlock/USB_CC2: J4.B5 (CC2), R30.1
/RP2040, SPI, E-stop interlock/USB_CONN_DM: J4.A7 (D-), J4.B7 (D-), R32.1, U5.3 (I/O2), U5.4 (I/O2)
/RP2040, SPI, E-stop interlock/USB_CONN_DP: J4.A6 (D+), J4.B6 (D+), R31.1, U5.1 (I/O1), U5.6 (I/O1)
/RP2040, SPI, E-stop interlock/USB_DM: R32.2, U3.46 (USB_DM)
/RP2040, SPI, E-stop interlock/USB_DP: R31.2, U3.47 (USB_DP)
/RP2040, SPI, E-stop interlock/VBUS: D6.2 (A), J4.A4 (VBUS), J4.A9 (VBUS), J4.B4 (VBUS), J4.B9 (VBUS), U5.5 (VBUS)
/RP2040, SPI, E-stop interlock/VDD_CORE: C37.1, C38.1, C39.1, C40.1, U3.23 (DVDD), U3.45 (VREG_VOUT), U3.50 (DVDD)
/RP2040, SPI, E-stop interlock/VSYS: C44.1, D5.1 (K), D6.1 (K), U6.1 (VIN), U6.3 (EN)
/RP2040, SPI, E-stop interlock/XIN: C42.1, U3.20 (XIN), Y1.1
/RP2040, SPI, E-stop interlock/XOUT: R26.1, U3.21 (XOUT)
/RP2040, SPI, E-stop interlock/XTAL_OUT: C43.1, R26.2, Y1.3
CLUTCH_HS_DRV: U9.4; also elsewhere on the board
CLUTCH_ISENSE: U3.39 (GPIO27/ADC1); also elsewhere on the board
CLUTCH_LS_GATE: U8.4; also elsewhere on the board
DIAL_A: U3.13 (GPIO10); also elsewhere on the board
DIAL_B: U3.14 (GPIO11); also elsewhere on the board
DIAL_SW: U3.15 (GPIO12); also elsewhere on the board
ENC_OUT_A: U3.2 (GPIO0); also elsewhere on the board
ENC_OUT_B: U3.3 (GPIO1); also elsewhere on the board
ESTOP_RET: R44.1; also elsewhere on the board
ESTOP_SRC: R43.2; also elsewhere on the board
GND: C28.2, C29.2, C30.2, C31.2, C32.2, C33.2, C34.2, C35.2, C36.2, C37.2, C38.2, C39.2, C40.2, C41.2, C42.2, C43.2, C44.2, C45.2, C46.2, C47.2, C48.2, C49.2, D4.1 (K), J3.2, J4.A1 (GND), J4.A12 (GND), J4.B1 (GND), J4.B12 (GND), J4.S1 (SHIELD), R29.2, R30.2, R40.2, R41.2, R42.2, R45.2, SW1.2, SW2.2, U3.19 (TESTEN), U3.57 (GND), U4.4 (GND), U5.2 (GND), U6.2 (GND), U7.3 (GND), U8.3 (GND), U9.3 (GND), Y1.2 (G), Y1.4 (G); also elsewhere on the board
I2C_SCL: U3.7 (GPIO5); also elsewhere on the board
I2C_SDA: U3.6 (GPIO4); also elsewhere on the board
LIM_L: U3.8 (GPIO6); also elsewhere on the board
LIM_R: U3.9 (GPIO7); also elsewhere on the board
MODE_L: U3.16 (GPIO13); also elsewhere on the board
MODE_R: U3.17 (GPIO14); also elsewhere on the board
RAPID: U3.18 (GPIO15); also elsewhere on the board
TMC_CSN: R35.2, R37.1; also elsewhere on the board
TMC_DIAG0: R38.1, U3.32 (GPIO21); also elsewhere on the board
TMC_DIAG1: R39.1, U3.34 (GPIO22); also elsewhere on the board
TMC_DRV_ENN: U7.4; also elsewhere on the board
TMC_SCK: R33.2; also elsewhere on the board
TMC_SDI: R34.2; also elsewhere on the board
TMC_SDO: R36.1; also elsewhere on the board
VM_SENSE: U3.38 (GPIO26/ADC0); also elsewhere on the board

Notes on the sheet:
Interlock (hardware, independent of firmware): TMC_DRV_ENN = NAND(DRV_EN, E_OK) -> driver off unless the MCU enables it AND E-stop loop closed CLUTCH_* = AND(MCU request, E_OK) -> clutch off on E-stop MCU outputs have pull-downs so everything is off while the RP2040 is in reset. E-stop: NC contact 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

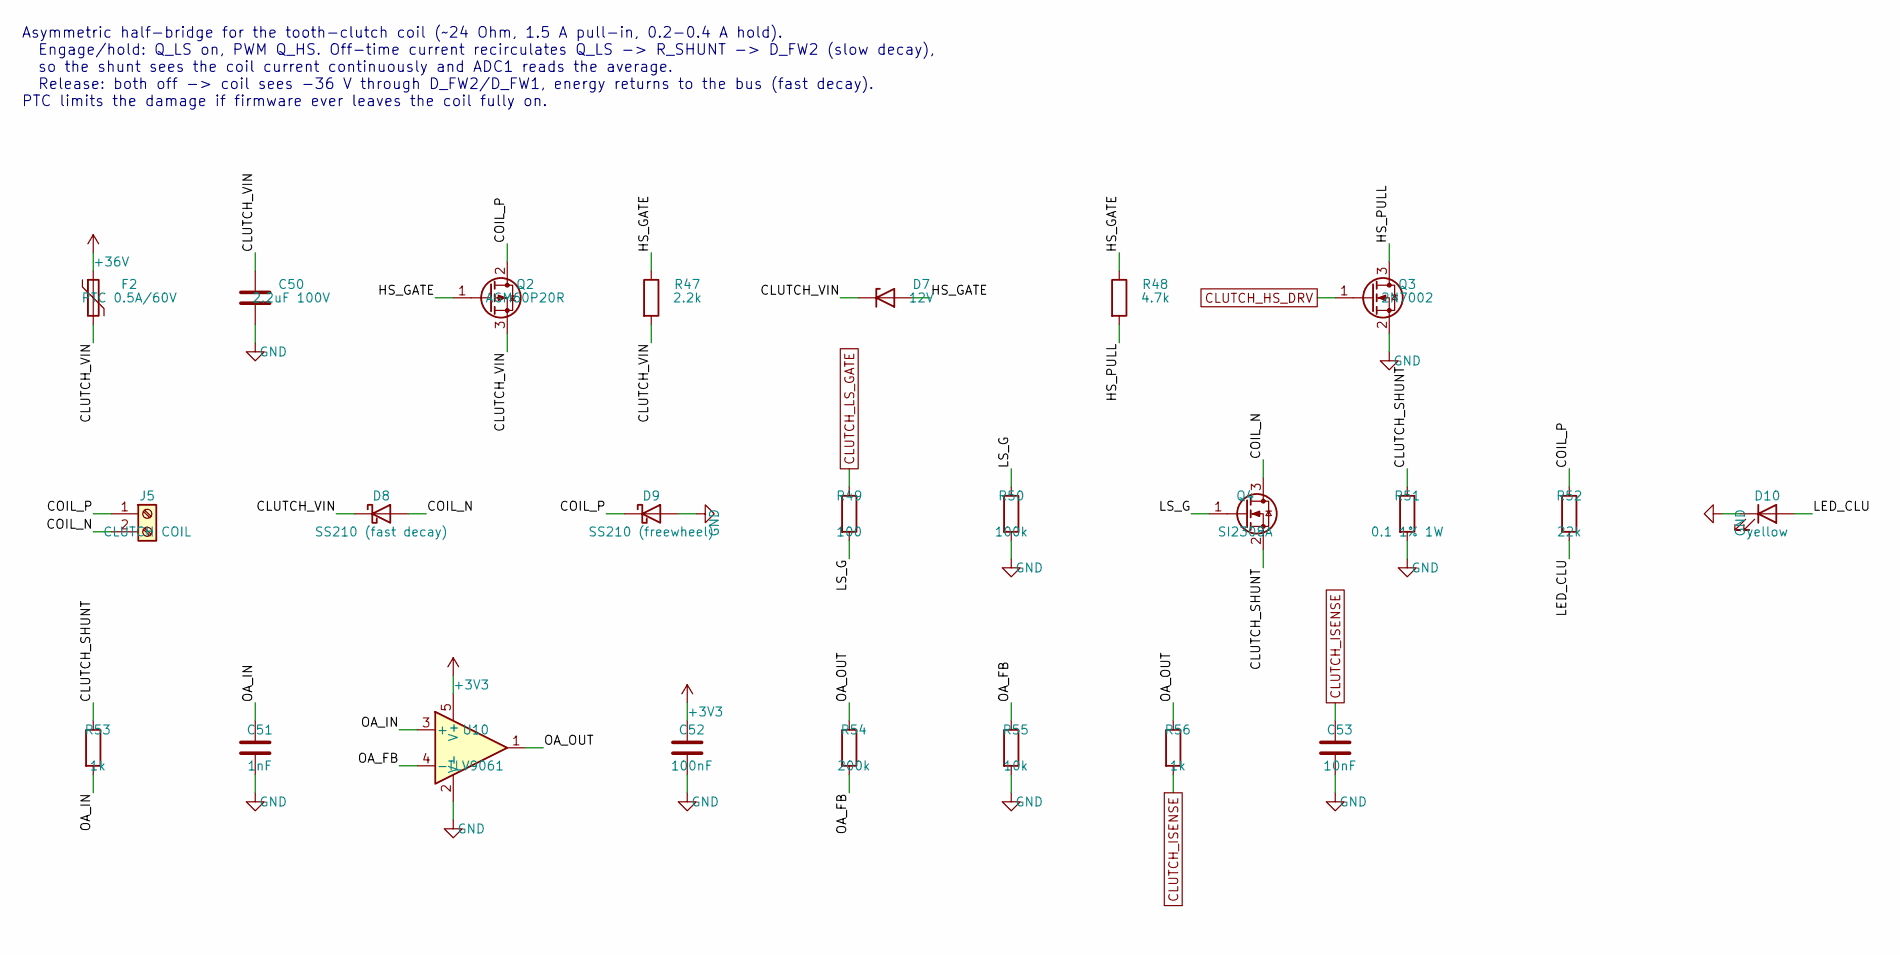
[picture p16: schematic clutch.kicad_sch, Clutch coil driver]

Parts:
C50: 2.2uF 100V; C_1210_3225Metric; MPN Murata GRM32ER72A225KA35L; LCSC C86054
C51: 1nF; C_0603_1608Metric; MPN Samsung CL10B102KB8NNNC; LCSC C1588
C52: 100nF; C_0603_1608Metric; MPN Yageo CC0603KRX7R9BB104; LCSC C14663
C53: 10nF; C_0603_1608Metric; MPN FH 0603B103K500NT; LCSC C57112
D7: 12V; D_SOD-123; MPN onsemi MMSZ5242BT1G; LCSC C82050
D8: SS210 (fast decay); D_SMA; MPN SS210; LCSC C14996
D9: SS210 (freewheel); D_SMA; MPN SS210; LCSC C14996
D10: yellow; LED_0603_1608Metric; MPN XINGLIGHT XL-1608UYC-06; LCSC C965802
F2: PTC 0.5A/60V; Fuse_2920_7451Metric; MPN Littelfuse 2920L050DR (0.5 A hold, 1 A 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; LCSC C207082
J5: CLUTCH COIL; PhoenixContact_MSTBA_2,5_2-G-5,08_1x02_P5.08mm_Horizontal; MPN KF2EDGR-5.08-2P (+ plug KF2EDGK-5.08-2P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; LCSC C441204
Q2: AGM60P20R; SOT-223-3_TabPin2; MPN AGM60P20R; LCSC C6719402
Q3: 2N7002; SOT-23; MPN 2N7002; LCSC C8545
Q4: SI2308A; SOT-23; MPN UMW SI2308A; LCSC C347491
R47: 2.2k; R_0603_1608Metric; MPN UNI-ROYAL 0603WAF2201T5E; LCSC C4190
R48: 4.7k; R_1206_3216Metric; MPN UNI-ROYAL 1206W4F4701T5E; LCSC C17936
R49: 100; R_0603_1608Metric; MPN UNI-ROYAL 0603WAF1000T5E; LCSC C22775
R50: 100k; R_0603_1608Metric; MPN UNI-ROYAL 0603WAF1003T5E; LCSC C25803
R51: 0.1 1% 1W; R_1206_3216Metric; MPN FOJAN FRM121WFR100TM; LCSC C7467250
R52: 22k; R_0603_1608Metric; MPN UNI-ROYAL 0603WAF2202T5E; LCSC C31850
R53, R56: 1k; R_0603_1608Metric; MPN UNI-ROYAL 0603WAF1001T5E; LCSC C21190
R54: 200k; R_0603_1608Metric; MPN UNI-ROYAL 0603WAF2003T5E; LCSC C25811
R55: 10k; R_0603_1608Metric; MPN UNI-ROYAL 0603WAF1002T5E; LCSC C25804
U10: TLV9061; SOT-23-5; MPN TLV9061IDBVR; LCSC C398358

Connections:
+3V3: C52.1, U10.5 (V+); also elsewhere on the board
+36V: F2.1; also elsewhere on the board
/Clutch coil driver/CLUTCH_SHUNT: Q4.2 (S), R51.1, R53.1
/Clutch coil driver/CLUTCH_VIN: C50.1, D7.1 (K), D8.1 (K), F2.2, Q2.3 (S), R47.2
/Clutch coil driver/COIL_N: D8.2 (A), J5.2, Q4.3 (D)
/Clutch coil driver/COIL_P: D9.1 (K), J5.1, Q2.2 (D), R52.1
/Clutch coil driver/HS_GATE: D7.2 (A), Q2.1 (G), R47.1, R48.1
/Clutch coil driver/HS_PULL: Q3.3 (D), R48.2
/Clutch coil driver/LED_CLU: D10.2 (A), R52.2
/Clutch coil driver/LS_G: Q4.1 (G), R49.2, R50.1
/Clutch coil driver/OA_FB: R54.2, R55.1, U10.4 (-)
/Clutch coil driver/OA_IN: C51.1, R53.2, U10.3 (+)
/Clutch coil driver/OA_OUT: R54.1, R56.1, U10.1
CLUTCH_HS_DRV: Q3.1 (G); also elsewhere on the board
CLUTCH_ISENSE: C53.1, R56.2; also elsewhere on the board
CLUTCH_LS_GATE: R49.1; also elsewhere on the board
GND: C50.2, C51.2, C52.2, C53.2, D9.2 (A), D10.1 (K), Q3.2 (S), R50.2, R51.2, R55.2, U10.2 (V-); also elsewhere on the board

Notes on the sheet:
Asymmetric half-bridge for the tooth-clutch coil (~24 Ohm, 1.5 A pull-in, 0.2-0.4 A hold). Engage/hold: Q_LS on, PWM Q_HS. Off-time current recirculates Q_LS -> R_SHUNT -> D_FW2 (slow decay), so the shunt sees the coil current continuously and ADC1 reads the average. Release: both off -> coil sees 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
