liorknafo/power-feed-manual-mill/hardware/kicad/power-feed.kicad_pcb

## KiCad design hardware/kicad/power-feed.kicad_pcb (continued)

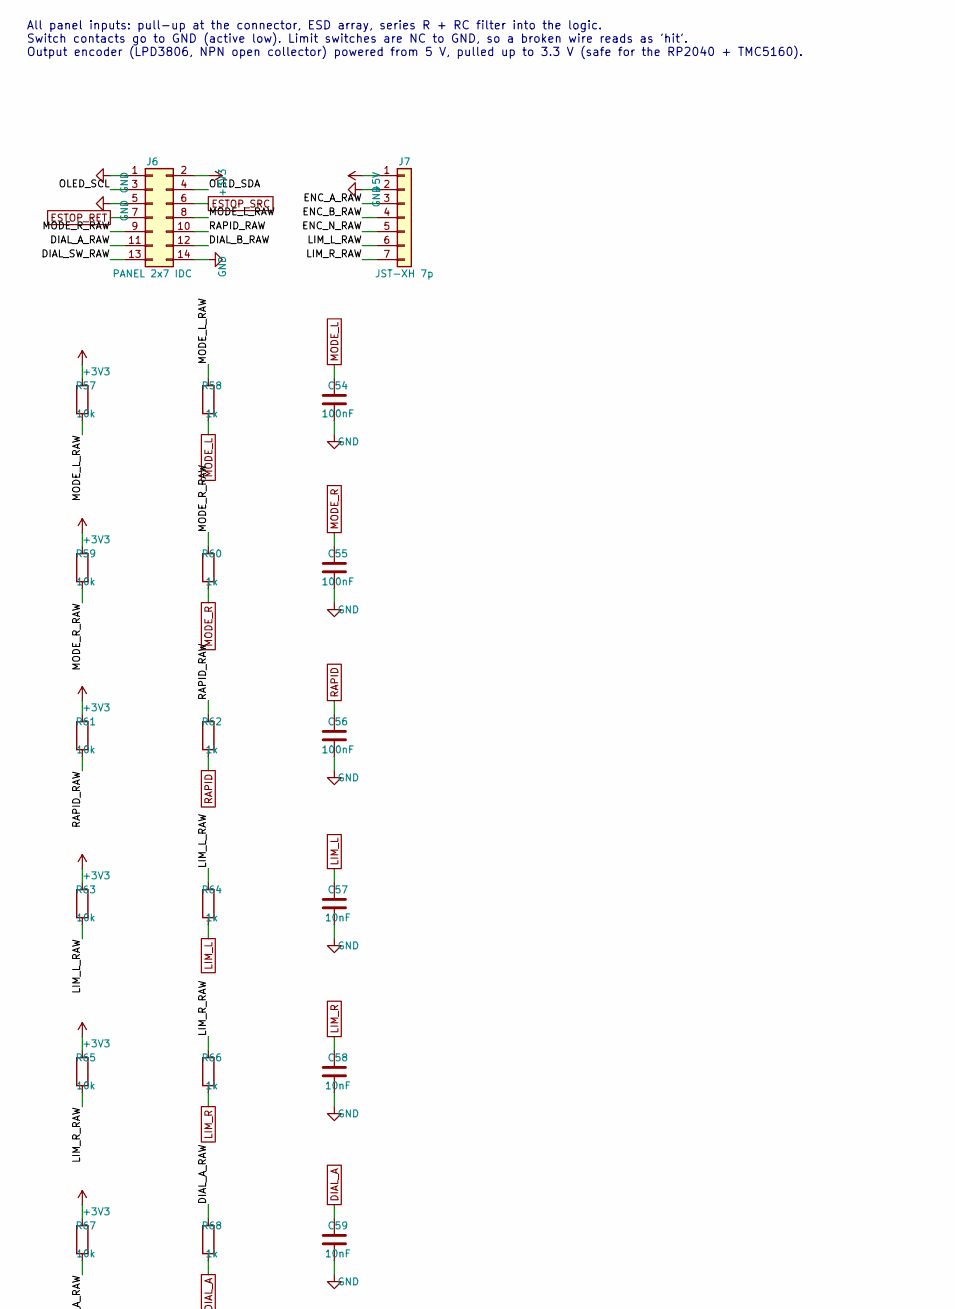
[picture p17: schematic io.kicad_sch, Panel and sensor I/O, part in row 1, column 1]

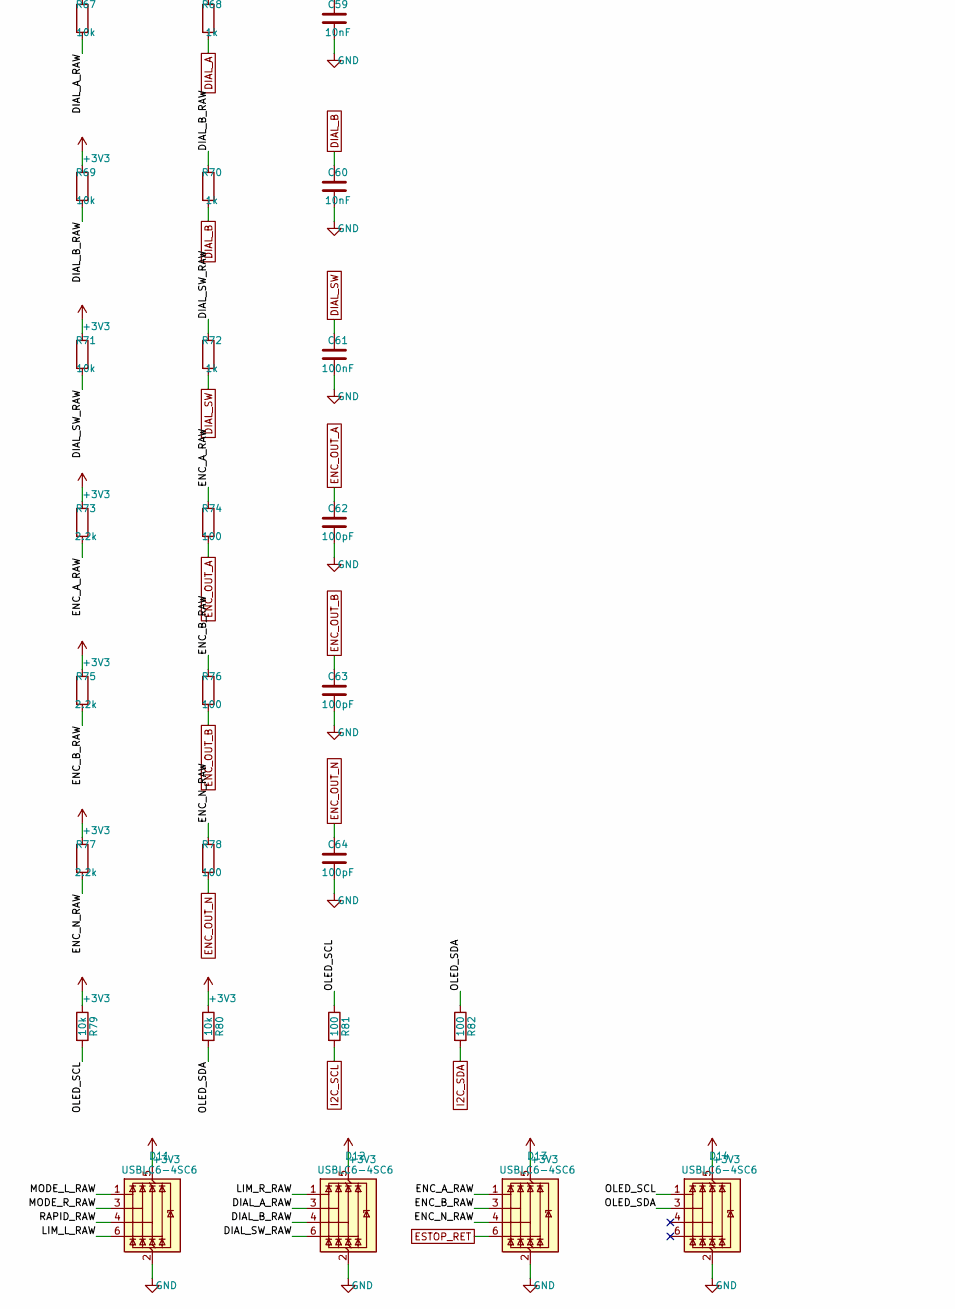
[picture p18: schematic io.kicad_sch, Panel and sensor I/O, part in row 2, column 1]

Parts:
C54, C55, C56, C61: 100nF; C_0603_1608Metric; MPN Yageo CC0603KRX7R9BB104; LCSC C14663
C57, C58, C59, C60: 10nF; C_0603_1608Metric; MPN FH 0603B103K500NT; LCSC C57112
C62, C63, C64: 100pF; C_0603_1608Metric; MPN Samsung CL10C101JB8NNNC; LCSC C14858
D11, D12, D13, D14: USBLC6-4SC6; SOT-23-6; MPN USBLC6-4SC6; LCSC C111212
J6: PANEL 2x7 IDC; IDC-Header_2x07_P2.54mm_Vertical; MPN ZHOURI DC3-2.54-14PAS (2x7 shrouded box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; LCSC C2977595
J7: JST-XH 7p; JST_XH_B7B-XH-A_1x07_P2.50mm_Vertical; MPN JST B7B-XH-A(LF)(SN); LCSC C144398
R57, R59, R61, R63, R65, R67, R69, R71, R79, R80: 10k; R_0603_1608Metric; MPN UNI-ROYAL 0603WAF1002T5E; LCSC C25804
R58, R60, R62, R64, R66, R68, R70, R72: 1k; R_0603_1608Metric; MPN UNI-ROYAL 0603WAF1001T5E; LCSC C21190
R73, R75, R77: 2.2k; R_0603_1608Metric; MPN UNI-ROYAL 0603WAF2201T5E; LCSC C4190
R74, R76, R78, R81, R82: 100; R_0603_1608Metric; MPN UNI-ROYAL 0603WAF1000T5E; LCSC C22775

Connections:
+3V3: D11.5 (VBUS), D12.5 (VBUS), D13.5 (VBUS), D14.5 (VBUS), J6.2, R57.1, R59.1, R61.1, R63.1, R65.1, R67.1, R69.1, R71.1, R73.1, R75.1, R77.1, R79.1, R80.1; also elsewhere on the board
+5V: J7.1; also elsewhere on the board
/Panel and sensor I/O/DIAL_A_RAW: D12.3 (I/O2), J6.11, R67.2, R68.1
/Panel and sensor I/O/DIAL_B_RAW: D12.4 (I/O3), J6.12, R69.2, R70.1
/Panel and sensor I/O/DIAL_SW_RAW: D12.6 (I/O4), J6.13, R71.2, R72.1
/Panel and sensor I/O/ENC_A_RAW: D13.1 (I/O1), J7.3, R73.2, R74.1
/Panel and sensor I/O/ENC_B_RAW: D13.3 (I/O2), J7.4, R75.2, R76.1
/Panel and sensor I/O/ENC_N_RAW: D13.4 (I/O3), J7.5, R77.2, R78.1
/Panel and sensor I/O/LIM_L_RAW: D11.6 (I/O4), J7.6, R63.2, R64.1
/Panel and sensor I/O/LIM_R_RAW: D12.1 (I/O1), J7.7, R65.2, R66.1
/Panel and sensor I/O/MODE_L_RAW: D11.1 (I/O1), J6.8, R57.2, R58.1
/Panel and sensor I/O/MODE_R_RAW: D11.3 (I/O2), J6.9, R59.2, R60.1
/Panel and sensor I/O/OLED_SCL: D14.1 (I/O1), J6.3, R79.2, R81.1
/Panel and sensor I/O/OLED_SDA: D14.3 (I/O2), J6.4, R80.2, R82.1
/Panel and sensor I/O/RAPID_RAW: D11.4 (I/O3), J6.10, R61.2, R62.1
DIAL_A: C59.1, R68.2; also elsewhere on the board
DIAL_B: C60.1, R70.2; also elsewhere on the board
DIAL_SW: C61.1, R72.2; also elsewhere on the board
ENC_OUT_A: C62.1, R74.2; also elsewhere on the board
ENC_OUT_B: C63.1, R76.2; also elsewhere on the board
ENC_OUT_N: C64.1, R78.2; also elsewhere on the board
ESTOP_RET: D13.6 (I/O4), J6.7; also elsewhere on the board
ESTOP_SRC: J6.6; also elsewhere on the board
GND: C54.2, C55.2, C56.2, C57.2, C58.2, C59.2, C60.2, C61.2, C62.2, C63.2, C64.2, D11.2 (GND), D12.2 (GND), D13.2 (GND), D14.2 (GND), J6.1, J6.5, J6.14, J7.2; also elsewhere on the board
I2C_SCL: R81.2; also elsewhere on the board
I2C_SDA: R82.2; also elsewhere on the board
LIM_L: C57.1, R64.2; also elsewhere on the board
LIM_R: C58.1, R66.2; also elsewhere on the board
MODE_L: C54.1, R58.2; also elsewhere on the board
MODE_R: C55.1, R60.2; also elsewhere on the board
RAPID: C56.1, R62.2; also elsewhere on the board

Notes on the sheet:
All panel inputs: pull-up at the connector, ESD array, series R + RC filter into the logic. Switch contacts go to GND (active low). Limit switches are NC to GND, so a broken wire reads as 'hit'. Output encoder (LPD3806, NPN open collector) powered from 5 V, pulled up to 3.3 V (safe for the RP2040 +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

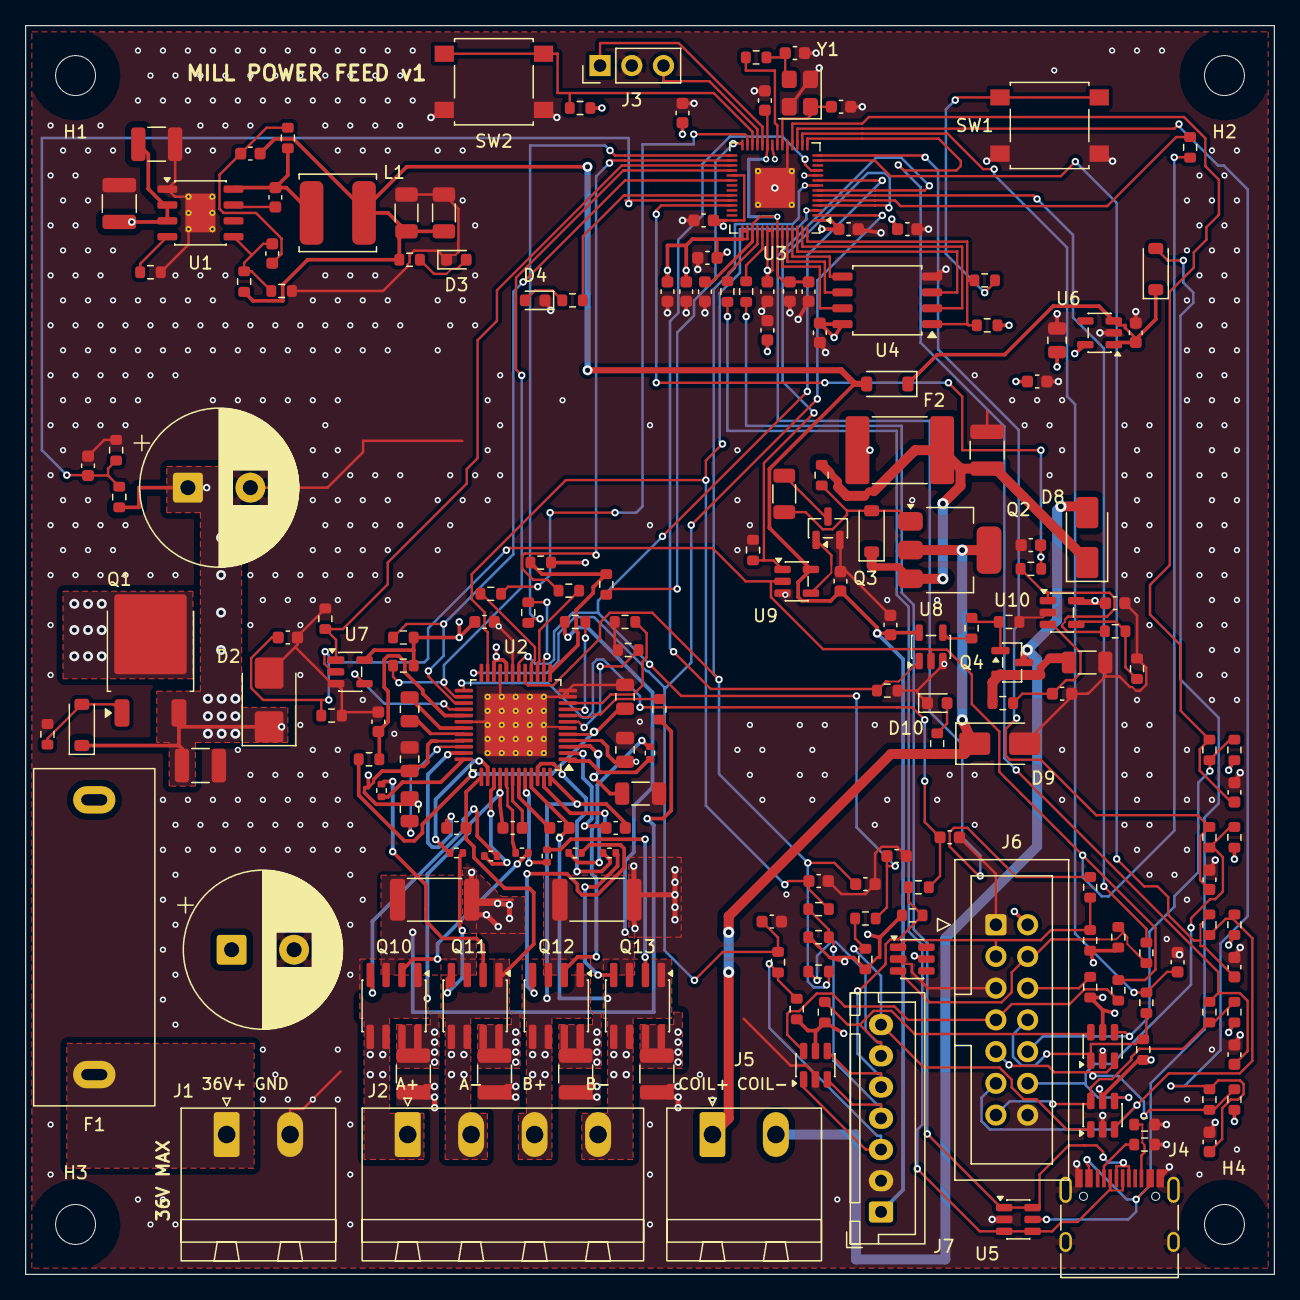
[picture p19: board power-feed.kicad_pcb from above]

Board: 4 copper layers, 100.0 x 100.0 mm, 195 parts (0 on the bottom side), 132 nets.

Other parts of the board:
H1, H2, H3, H4: M3; MountingHole_3.2mm_M3
