liorknafo/power-feed-manual-mill/firmware/feed-core/src/state.rs

//! The power-feed state machine (docs/design.md §3), as a pure function of inputs.
//!
//! ```text
//! INTERLOCK -(switch centre)-> IDLE -(L/R)-> ENGAGING -(teeth meshed)-> RUNNING
//!                               ^                                        |(centre / flip / limit)
//!                               +---- RELEASING <---- STOPPING <---------+
//! any state --(E-stop, driver error, stall, bus V, switch wiring, no engage)--> FAULT
//! FAULT --(switch centre and cause gone)--> IDLE
//! ```
//! Rules enforced here:
//! * the clutch is only energised with the motor stopped (plus the slow engagement jog), and only
//!   released after the motor has stopped and the driver is disabled;
//! * a fault drops the driver enable and the clutch in the same step;
//! * nothing starts moving until the switch has been seen in the centre (at power-up, after a
//!   fault, after a limit stop);
//! * a limit switch blocks motion toward that limit only.

use crate::clutch::ClutchCmd;
use crate::settings::Settings;
use crate::units::{self, MICROSTEPS};

/// 3-position switch.
#[derive(Clone, Copy, Debug, PartialEq, Eq)]
pub enum Mode {
    Center,
    Left,
    Right,
    /// Both contacts closed: wiring fault.
    Invalid,
}

/// Feed direction. `Right` is positive motor velocity (flip the motor wires or `Settings` sign later
/// if the table moves the wrong way).
#[derive(Clone, Copy, Debug, PartialEq, Eq)]
pub enum Dir {
    Left,
    Right,
}

impl Dir {
    pub fn sign(self) -> i32 {
        match self {
            Dir::Left => -1,
            Dir::Right => 1,
        }
    }
    fn of(mode: Mode) -> Option<Dir> {
        match mode {
            Mode::Left => Some(Dir::Left),
            Mode::Right => Some(Dir::Right),
            _ => None,
        }
    }
}

#[derive(Clone, Copy, Debug, PartialEq, Eq)]
pub enum Fault {
    EStop,
    DriverError,
    Stall,
    OverVoltage,
    UnderVoltage,
    SwitchWiring,
    ClutchNoEngage,
    StopTimeout,
    /// TMC5160 not configured (no answer, or it reset).
    DriverNotReady,
    /// ADC readings implausible.
    Sensor,
    /// Clutch commanded on but no coil current: coil unplugged / open, or the sense amp is dead.
    ClutchOpen,
    /// The limit BEHIND the table tripped while feeding: motor or limit wiring reversed.
    WrongDirection,
}

impl Fault {
    pub fn text(self) -> &'static str {
        match self {
            Fault::EStop => "E-STOP",
            Fault::DriverError => "DRIVER FAULT",
            Fault::Stall => "STALL / JAM",
            Fault::OverVoltage => "BUS OVERVOLT",
            Fault::UnderVoltage => "NO 36V",
            Fault::SwitchWiring => "SWITCH WIRING",
            Fault::ClutchNoEngage => "CLUTCH NO ENGAGE",
            Fault::StopTimeout => "STOP TIMEOUT",
            Fault::DriverNotReady => "DRIVER NOT READY",
            Fault::Sensor => "SENSOR FAULT",
            Fault::ClutchOpen => "CLUTCH OPEN",
            Fault::WrongDirection => "LIMIT WRONG WAY",
        }
    }
}

#[derive(Clone, Copy, Debug, PartialEq)]
pub enum EngagePhase {
    /// Driver enabled, motor holding.
    Enable,
    /// Coil full-on.
    PullIn,
    /// Slow jog until the output encoder follows the motor.
    /// `follow` = (motor, encoder) when the output first moved; engagement is proven when, from
    /// there on, the output moves in step with the motor.
    Jog { motor0: i32, enc0: i32, t_jog: u32, follow: Option<(i32, i32)> },
}

#[derive(Clone, Copy, Debug, PartialEq)]
pub enum State {
    Interlock,
    Idle,
    Engaging { dir: Dir, phase: EngagePhase, t0: u32 },
    /// `rapid_armed`: rapid only after the button was seen released in this run;
    /// `behind_was_hit`: the limit behind us was already active when the run started.
    Running { dir: Dir, rapid_armed: bool, behind_was_hit: bool },
    Stopping { dir: Dir, t0: u32 },
    /// `coil_off` = second phase (driver already off, coil now off).
    Releasing { coil_off: bool, t0: u32 },
    Fault(Fault),
}

impl State {
    pub fn name(&self) -> &'static str {
        match self {
            State::Interlock => "CENTRE SWITCH",
            State::Idle => "READY",
            State::Engaging { .. } => "ENGAGING",
            State::Running { .. } => "RUN",
            State::Stopping { .. } => "STOPPING",
            State::Releasing { .. } => "RELEASE",
            State::Fault(f) => f.text(),
        }
    }
}

/// Everything the controller needs to know, sampled once per control step.
#[derive(Clone, Copy, Debug)]
pub struct Inputs {
    pub now_ms: u32,
    pub mode: Mode,
    pub rapid: bool,
    pub estop_ok: bool,
    pub limit_left: bool,
    pub limit_right: bool,
    /// TMC5160 driver error (overtemperature, short) from SPI status / DIAG0.
    pub driver_fault: bool,
    /// Encoder deviation (TMC5160 ENC_STATUS.deviation_warn) or the MCU's own cross-check.
    pub deviation: bool,
    /// TMC5160 reports zero velocity.
    pub standstill: bool,
    /// TMC5160 XACTUAL (microsteps).
    pub motor_usteps: i32,
    /// Output-side encoder position (counts).
    pub output_counts: i32,
    pub bus_mv: u32,
    /// Speed-dial detents since the last step.
    pub dial_detents: i32,
    pub dial_fast: bool,
    /// The TMC5160 answered and is configured.
    pub driver_ready: bool,
    /// The app detected implausible ADC readings.
    pub sensor_fault: bool,
    /// The app saw the clutch commanded on with (almost) no coil current.
    pub clutch_open: bool,
}

impl Inputs {
    /// A quiet, healthy machine with the switch centred; tests start from here.
    pub fn idle(now_ms: u32) -> Inputs {
        Inputs {
            now_ms,
            mode: Mode::Center,
            rapid: false,
            estop_ok: true,
            limit_left: false,
            limit_right: false,
            driver_fault: false,
            deviation: false,
            standstill: true,
            motor_usteps: 0,
            output_counts: 0,
            bus_mv: 36_000,
            dial_detents: 0,
            dial_fast: false,
            driver_ready: true,
            sensor_fault: false,
            clutch_open: false,
        }
    }
}

#[derive(Clone, Copy, Debug, PartialEq)]
pub enum Motion {
    /// Decelerate to zero and hold (velocity mode, v = 0).
    Stop,
    /// Signed speed in microsteps/s (the TMC5160 ramps to it).
    Velocity(f32),
    /// Position move to an absolute XACTUAL target at a given speed (engagement jog).
    Jog { target: i32, speed: f32 },
}

#[derive(Clone, Copy, Debug, PartialEq)]
pub struct Outputs {
    pub driver_enable: bool,
    pub motion: Motion,
    pub clutch: ClutchCmd,
    /// Arm the encoder-deviation (stall) check.
    pub deviation_monitor: bool,
    /// One-shot: set X_ENC := XACTUAL and clear the deviation flag before arming the monitor.
    pub resync_encoder: bool,
}

const DRIVER_SETTLE_MS: u32 = 20;
const DRIVER_OFF_MS: u32 = 5;
const JOG_TIMEOUT_MS: u32 = 3000;
/// Output movement (counts) that starts the "is it following?" check.
const FOLLOW_START_COUNTS: i32 = 2;

pub struct Controller {
    pub settings: Settings,
    pub state: State,
    /// Feed setpoint, mm/min.
    pub feed_mm_min: f32,
    /// Movement is blocked until the switch has been seen in the centre.
    need_center: bool,
    /// Which limit stopped us last (for the display).
    pub limit_hold: Option<Dir>,
}

impl Controller {
    pub fn new(settings: Settings) -> Self {
        Controller {
            feed_mm_min: settings.feed_default_mm_min,
            settings,
            state: State::Interlock,
            need_center: true,
            limit_hold: None,
        }
    }

    fn active_fault(&self, i: &Inputs) -> Option<Fault> {
        if i.mode == Mode::Invalid {
            return Some(Fault::SwitchWiring);
        }
        if !i.estop_ok {
            return Some(Fault::EStop);
        }
        if i.sensor_fault {
            return Some(Fault::Sensor);
        }
        if i.clutch_open {
            return Some(Fault::ClutchOpen);
        }
        if i.driver_fault {
            return Some(Fault::DriverError);
        }
        if i.bus_mv > self.settings.bus_max_mv {
            return Some(Fault::OverVoltage);
        }
        if i.bus_mv < self.settings.bus_min_mv {
            return Some(Fault::UnderVoltage);
        }
        if !i.driver_ready {
            return Some(Fault::DriverNotReady);
        }
        if i.deviation && self.monitoring() {
            return Some(Fault::Stall);
        }
        None
    }

    fn monitoring(&self) -> bool {
        matches!(self.state, State::Running { .. } | State::Stopping { .. })
    }

    fn limit_toward(i: &Inputs, dir: Dir) -> bool {
        match dir {
            Dir::Left => i.limit_left,
            Dir::Right => i.limit_right,
        }
    }

    fn limit_behind(i: &Inputs, dir: Dir) -> bool {
        match dir {
            Dir::Left => i.limit_right,
            Dir::Right => i.limit_left,
        }
    }

    /// Longest normal stop: from the fastest speed at the configured deceleration, with margin.
    pub fn stop_timeout_ms(&self) -> u32 {
        let s = &self.settings;
        let v_mm_s = s.rapid_mm_min.max(s.feed_max_mm_min) / 60.0;
        (v_mm_s / s.accel_mm_s2 * 1500.0) as u32 + 1000
    }

    /// Replace the settings (after a menu save) and keep the feed setpoint inside the new range.
    pub fn set_settings(&mut self, s: Settings) {
        self.settings = s;
        self.feed_mm_min = self.feed_mm_min.clamp(s.feed_min_mm_min, s.feed_max_mm_min);
    }

    /// Run one control step.
    pub fn step(&mut self, i: &Inputs) -> Outputs {
        let s = self.settings;
        let now = i.now_ms;

        // speed dial works in every state
        if i.dial_detents != 0 {
            let step = units::dial_step(self.feed_mm_min, i.dial_fast);
            self.feed_mm_min = (self.feed_mm_min + i.dial_detents as f32 * step).clamp(s.feed_min_mm_min, s.feed_max_mm_min);
        }

        if i.mode == Mode::Center {
            self.need_center = false;
            self.limit_hold = None;
        }

        // faults pre-empt everything
        let mut resync = false;
        if !matches!(self.state, State::Fault(_)) {
            if let Some(f) = self.active_fault(i) {
                self.state = State::Fault(f);
                self.need_center = true;
            }
        }

        self.state = match self.state {
            State::Interlock => {
                if i.mode == Mode::Center {
                    State::Idle
                } else {
                    State::Interlock
                }
            }
            State::Fault(f) => {
                if i.mode == Mode::Center && self.active_fault(i).is_none() {
                    State::Idle
                } else {
                    State::Fault(f)
                }
            }
            State::Idle => match Dir::of(i.mode) {
                Some(dir) if !self.need_center => {
                    if Self::limit_toward(i, dir) {
                        self.need_center = true;
                        self.limit_hold = Some(dir);
                        State::Idle
                    } else {
                        State::Engaging { dir, phase: EngagePhase::Enable, t0: now }
                    }
                }
                _ => State::Idle,
            },
            State::Engaging { dir, phase, t0 } => {
                if Dir::of(i.mode) != Some(dir) || Self::limit_toward(i, dir) {
                    if Self::limit_toward(i, dir) {
                        self.need_center = true;
                        self.limit_hold = Some(dir);
                    }
                    State::Releasing { coil_off: false, t0: now }
                } else {
                    match phase {
                        // the motor must be at a standstill before the coil pulls in (it may still be
                        // coasting down from a previous run that was cut by a fault)
                        EngagePhase::Enable if now.wrapping_sub(t0) >= DRIVER_SETTLE_MS && i.standstill => {
                            State::Engaging { dir, phase: EngagePhase::PullIn, t0: now }
                        }
                        EngagePhase::PullIn if now.wrapping_sub(t0) >= s.clutch_pull_in_ms => State::Engaging {
                            dir,
                            phase: EngagePhase::Jog { motor0: i.motor_usteps, enc0: i.output_counts, t_jog: now, follow: None },
                            t0,
                        },
                        EngagePhase::Jog { motor0, enc0, t_jog, follow } => {
                            let out_moved = (i.output_counts - enc0) * dir.sign();
                            let motor_moved = (i.motor_usteps - motor0) * dir.sign();
                            let jog_len = (s.jog_max_steps * MICROSTEPS) as i32;
                            let upc = units::usteps_per_count(&s);
                            // start the follow check once the output begins to move with the motor turning
                            let follow = match follow {
                                None if out_moved.abs() >= FOLLOW_START_COUNTS && motor_moved > 0 => {
                                    Some((i.motor_usteps, i.output_counts))
                                }
                                f => f,
                            };
                            let engaged = follow.is_some_and(|(m0, e0)| {
                                let out_d = (i.output_counts - e0) * dir.sign();
                                let mot_d = (i.motor_usteps - m0) * dir.sign();
                                let out_us = out_d as f32 * upc;
                                out_d >= s.engage_detect_counts as i32
                                    && mot_d > 0
                                    && out_us >= 0.6 * mot_d as f32
                                    && out_us <= 1.6 * mot_d as f32
                            });
                            if engaged {
                                resync = true;
                                State::Running { dir, rapid_armed: !i.rapid, behind_was_hit: Self::limit_behind(i, dir) }
                            } else if (motor_moved >= jog_len - (MICROSTEPS as i32 / 2) && i.standstill)
                                || now.wrapping_sub(t_jog) > JOG_TIMEOUT_MS
                                || out_moved < -(s.engage_detect_counts as i32)
                            {
                                self.need_center = true;
                                State::Fault(Fault::ClutchNoEngage)
                            } else {
                                State::Engaging { dir, phase: EngagePhase::Jog { motor0, enc0, t_jog, follow }, t0 }
                            }
                        }
                        _ => State::Engaging { dir, phase, t0 },
                    }
                }
            }
            State::Running { dir, rapid_armed, behind_was_hit } => {
                let behind = Self::limit_behind(i, dir);
                if behind && !behind_was_hit {
                    // the limit behind the table tripped while feeding away from it:
                    // the motor (or a limit) is wired the wrong way round
                    self.need_center = true;
                    State::Fault(Fault::WrongDirection)
                } else if Self::limit_toward(i, dir) {
                    self.need_center = true;
                    self.limit_hold = Some(dir);
                    State::Stopping { dir, t0: now }
                } else if Dir::of(i.mode) != Some(dir) {
                    // centre, or flipped straight to the other side: full stop and release first
                    State::Stopping { dir, t0: now }
                } else {
                    State::Running { dir, rapid_armed: rapid_armed || !i.rapid, behind_was_hit: behind_was_hit && behind }
                }
            }
            State::Stopping { dir, t0 } => {
                if i.standstill && now != t0 {
                    State::Releasing { coil_off: false, t0: now }
                } else if now.wrapping_sub(t0) > self.stop_timeout_ms() {
                    self.need_center = true;
                    State::Fault(Fault::StopTimeout)
                } else {
                    State::Stopping { dir, t0 }
                }
            }
            State::Releasing { coil_off, t0 } => {
                if !coil_off && now.wrapping_sub(t0) >= DRIVER_OFF_MS {
                    State::Releasing { coil_off: true, t0: now }
                } else if coil_off && now.wrapping_sub(t0) >= s.clutch_release_ms {
                    State::Idle
                } else {
                    State::Releasing { coil_off, t0 }
                }
            }
        };

        self.outputs(i, resync)
    }

    fn outputs(&self, i: &Inputs, resync: bool) -> Outputs {
        let s = &self.settings;
        let off = Outputs {
            driver_enable: false,
            motion: Motion::Stop,
            clutch: ClutchCmd::Off,
            deviation_monitor: false,
            resync_encoder: false,
        };
        match self.state {
            State::Interlock | State::Idle | State::Fault(_) => off,
            State::Engaging { dir, phase, .. } => match phase {
                EngagePhase::Enable => Outputs { driver_enable: true, ..off },
                EngagePhase::PullIn => Outputs { driver_enable: true, clutch: ClutchCmd::PullIn, ..off },
                EngagePhase::Jog { motor0, .. } => Outputs {
                    driver_enable: true,
                    clutch: ClutchCmd::Hold,
                    motion: Motion::Jog {
                        target: motor0 + dir.sign() * (s.jog_max_steps * MICROSTEPS) as i32,
                        speed: (s.jog_speed_steps_s * MICROSTEPS) as f32,
                    },
                    ..off
                },
            },
            State::Running { dir, rapid_armed, .. } => {
                let mm_min = if i.rapid && rapid_armed { s.rapid_mm_min } else { self.feed_mm_min };
                Outputs {
                    driver_enable: true,
                    clutch: ClutchCmd::Hold,
                    motion: Motion::Velocity(dir.sign() as f32 * units::feed_to_usteps_s(s, mm_min)),
                    deviation_monitor: !resync,
                    resync_encoder: resync,
                }
            }
            State::Stopping { .. } => Outputs { driver_enable: true, clutch: ClutchCmd::Hold, deviation_monitor: true, ..off },
            // driver off first (unloads the teeth), then the coil
            State::Releasing { coil_off, .. } => Outputs { clutch: if coil_off { ClutchCmd::Off } else { ClutchCmd::Hold }, ..off },
        }
    }

    /// Speed currently shown on the display, mm/min.
    pub fn display_feed(&self, rapid: bool) -> f32 {
        match self.state {
            State::Running { rapid_armed: true, .. } if rapid => self.settings.rapid_mm_min,
            _ => self.feed_mm_min,
        }
    }
}

#[cfg(test)]
mod tests {
    use super::*;

    /// Small simulator: TMC5160 ramps instantly, clutch meshes after `mesh_after` motor microsteps of jog.
    struct Sim {
        c: Controller,
        i: Inputs,
        mesh_after: Option<i32>,
        engaged: bool,
        out_acc: f32,
        log: Vec<Outputs>,
    }

    impl Sim {
        fn new() -> Sim {
            Sim { c: Controller::new(Settings::default()), i: Inputs::idle(0), mesh_after: Some(256 * 3), engaged: false, out_acc: 0.0, log: vec![] }
        }
        fn tick(&mut self, n: u32) -> Outputs {
            let mut o = None;
            for _ in 0..n {
                self.i.now_ms += 1;
                let out = self.c.step(&self.i);
                // crude plant: instant ramps; once meshed, the leadscrew encoder follows the motor
                // through the belt (usteps_per_count microsteps per count)
                let upc = units::usteps_per_count(&self.c.settings);
                let d = match out.motion {
                    Motion::Jog { target, .. } if out.driver_enable => (target - self.i.motor_usteps).signum() * 64,
                    Motion::Velocity(v) if out.driver_enable => (v / 1000.0) as i32,
                    _ => 0,
                };
                self.i.motor_usteps += d;
                self.i.standstill = d == 0;
                if let Some(m) = self.mesh_after {
                    if self.i.motor_usteps.abs() >= m && out.clutch != ClutchCmd::Off {
                        self.engaged = true;
                    }
                }
                if self.engaged {
                    self.out_acc += d as f32 / upc;
                    self.i.output_counts = self.out_acc.round() as i32;
                }
                if out.clutch == ClutchCmd::Off {
                    self.engaged = false;
                }
                self.log.push(out);
                o = Some(out);
            }
            o.unwrap()
        }
        fn run_to_running(&mut self, mode: Mode) {
            self.i.mode = Mode::Center;
            self.tick(2);
            self.i.mode = mode;
            for _ in 0..2000 {
                self.tick(1);
                if matches!(self.c.state, State::Running { .. }) {
                    return;
                }
            }
            panic!("never reached Running: {:?}", self.c.state);
        }
    }

    #[test]
    fn powers_up_in_interlock_until_switch_centred() {
        let mut s = Sim::new();
        s.i.mode = Mode::Right;
        let o = s.tick(100);
        assert_eq!(s.c.state, State::Interlock);
        assert!(!o.driver_enable && o.clutch == ClutchCmd::Off);
        s.i.mode = Mode::Center;
        s.tick(1);
        assert_eq!(s.c.state, State::Idle);
    }

    #[test]
    fn engage_sequence_order() {
        let mut s = Sim::new();
        s.run_to_running(Mode::Right);
        // driver enabled before the clutch, clutch pulled in before any motion
        let first_drv = s.log.iter().position(|o| o.driver_enable).unwrap();
        let first_clutch = s.log.iter().position(|o| o.clutch != ClutchCmd::Off).unwrap();
        let first_move = s.log.iter().position(|o| !matches!(o.motion, Motion::Stop)).unwrap();
        assert!(first_drv < first_clutch && first_clutch < first_move);
        let pullin: Vec<_> = s.log.iter().filter(|o| o.clutch == ClutchCmd::PullIn).collect();
        assert!(pullin.iter().all(|o| matches!(o.motion, Motion::Stop)), "no motion during pull-in");
        // the step that enters Running re-syncs the encoder before arming the stall monitor
        let enter = s.log.iter().position(|o| matches!(o.motion, Motion::Velocity(_))).unwrap();
        assert!(s.log[enter].resync_encoder && !s.log[enter].deviation_monitor);
        let o = s.tick(1);
        assert!(o.deviation_monitor && !o.resync_encoder);
        assert!(matches!(o.motion, Motion::Velocity(v) if v > 0.0));
    }

    #[test]
    fn stop_then_release_driver_before_coil() {
        let mut s = Sim::new();
        s.run_to_running(Mode::Left);
        s.log.clear();
        s.i.mode = Mode::Center;
        for _ in 0..200 {
            s.tick(1);
            if s.c.state == State::Idle {
                break;
            }
        }
        assert_eq!(s.c.state, State::Idle);
        // the coil is never switched off while the driver is still enabled or the motor commanded to move
        for o in &s.log {
            if o.clutch == ClutchCmd::Off {
                assert!(!o.driver_enable);
            }
        }
        let drv_off = s.log.iter().position(|o| !o.driver_enable).unwrap();
        let coil_off = s.log.iter().position(|o| o.clutch == ClutchCmd::Off).unwrap();
        assert!(drv_off < coil_off);
    }

    #[test]
    fn direct_reversal_goes_through_idle() {
        let mut s = Sim::new();
        s.run_to_running(Mode::Left);
        s.i.mode = Mode::Right; // flip straight across
        let mut seen = vec![];
        for _ in 0..3000 {
            s.tick(1);
            let n = s.c.state.name();
            if seen.last() != Some(&n) {
                seen.push(n);
            }
            if matches!(s.c.state, State::Running { dir: Dir::Right, .. }) {
                break;
            }
        }
        assert_eq!(seen, ["STOPPING", "RELEASE", "READY", "ENGAGING", "RUN"]);
    }

    #[test]
    fn estop_drops_everything_in_the_same_step_and_latches() {
        let mut s = Sim::new();
        s.run_to_running(Mode::Right);
        s.i.estop_ok = false;
        let o = s.tick(1);
        assert_eq!(s.c.state, State::Fault(Fault::EStop));
        assert!(!o.driver_enable && o.clutch == ClutchCmd::Off);
        // releasing the E-stop does not restart while the switch is still on
        s.i.estop_ok = true;
        let o = s.tick(500);
        assert!(matches!(s.c.state, State::Fault(_)) && !o.driver_enable);
        // centre clears it, and only then can a new run start
        s.i.mode = Mode::Center;
        s.tick(1);
        assert_eq!(s.c.state, State::Idle);
    }

    #[test]
    fn fault_does_not_clear_while_cause_persists() {
        let mut s = Sim::new();
        s.tick(2);
        s.i.estop_ok = false;
        s.tick(5);
        s.i.mode = Mode::Center;
        s.tick(50);
        assert_eq!(s.c.state, State::Fault(Fault::EStop));
    }

    #[test]
    fn stall_only_counts_while_monitoring() {
        let mut s = Sim::new();
        s.tick(2);
        s.i.deviation = true; // stale flag while idle is ignored
        s.tick(10);
        assert_eq!(s.c.state, State::Idle);
        s.i.deviation = false;
        s.run_to_running(Mode::Right);
        s.tick(2);
        s.i.deviation = true;
        let o = s.tick(1);
        assert_eq!(s.c.state, State::Fault(Fault::Stall));
        assert!(!o.driver_enable && o.clutch == ClutchCmd::Off);
    }

    #[test]
    fn limit_blocks_only_its_direction_and_needs_centre() {
        let mut s = Sim::new();
        s.run_to_running(Mode::Right);
        s.i.limit_right = true;
        s.tick(200);
        assert_eq!(s.c.state, State::Idle);
        // limit released but switch still Right: must not restart by itself
        s.i.limit_right = false;
        s.tick(200);
        assert_eq!(s.c.state, State::Idle);
        // the other direction works after passing through centre
        s.i.limit_right = true;
        s.run_to_running(Mode::Left);
        // and Right stays blocked while its limit is active
        s.i.mode = Mode::Center;
        s.tick(200);
        s.i.mode = Mode::Right;
        s.tick(200);
        assert_eq!(s.c.state, State::Idle);
        assert_eq!(s.c.limit_hold, Some(Dir::Right));
    }

    #[test]
    fn clutch_that_never_meshes_faults() {
        let mut s = Sim::new();
        s.mesh_after = None;
        s.i.mode = Mode::Center;
        s.tick(2);
        s.i.mode = Mode::Left;
        s.tick(4000);
        assert_eq!(s.c.state, State::Fault(Fault::ClutchNoEngage));
    }

    #[test]
    fn switch_back_to_centre_during_engage_releases() {
        let mut s = Sim::new();
        s.mesh_after = None;
        s.i.mode = Mode::Center;
        s.tick(2);
        s.i.mode = Mode::Right;
        s.tick(30); // in pull-in
        assert!(matches!(s.c.state, State::Engaging { .. }));
        s.i.mode = Mode::Center;
        s.tick(100);
        assert_eq!(s.c.state, State::Idle);
    }

    #[test]
    fn bus_voltage_and_wiring_faults() {
        let mut s = Sim::new();
        s.tick(2);
        s.i.bus_mv = 45_000;
        s.tick(1);
        assert_eq!(s.c.state, State::Fault(Fault::OverVoltage));
        s.i.bus_mv = 36_000;
        s.i.mode = Mode::Invalid;
        s.tick(5);
        s.i.mode = Mode::Center;
        s.tick(1);
        assert_eq!(s.c.state, State::Idle);
        s.i.bus_mv = 5_000; // PSU off, board on USB
        s.tick(1);
        assert_eq!(s.c.state, State::Fault(Fault::UnderVoltage));
    }

    #[test]
    fn rapid_and_dial() {
        let mut s = Sim::new();
        s.i.dial_detents = 4; // 50 + 4*5 = 70
        s.tick(1);
        s.i.dial_detents = 0;
        assert_eq!(s.c.feed_mm_min, 70.0);
        s.i.dial_detents = -1000;
        s.tick(1);
        s.i.dial_detents = 0;
        assert_eq!(s.c.feed_mm_min, s.c.settings.feed_min_mm_min);
        s.run_to_running(Mode::Right);
        let slow = match s.tick(1).motion {
            Motion::Velocity(v) => v,
            m => panic!("{m:?}"),
        };
        s.i.rapid = true;
        let fast = match s.tick(1).motion {
            Motion::Velocity(v) => v,
            m => panic!("{m:?}"),
        };
        assert!(fast > slow * 10.0);
    }

    #[test]
    fn handwheel_nudge_without_motor_motion_does_not_engage() {
        let mut s = Sim::new();
        s.mesh_after = None; // clutch never meshes
        s.i.mode = Mode::Center;
        s.tick(2);
        s.i.mode = Mode::Right;
        // during pull-in the motor is still: a handwheel nudge must not count
        s.tick(25);
        for _ in 0..20 {
            s.i.output_counts += 2;
            s.tick(1);
            assert!(!matches!(s.c.state, State::Running { .. }), "engaged while the motor was still");
        }
        // during the jog: the handwheel spun much faster than the motor drives it
        for _ in 0..30 {
            s.i.output_counts += 10;
            s.tick(1);
            assert!(!matches!(s.c.state, State::Running { .. }), "engaged on foreign motion");
        }
    }

    #[test]
    fn pull_in_waits_for_standstill() {
        let mut c = Controller::new(Settings::default());
        let mut i = Inputs::idle(0);
        c.step(&i);
        i.mode = Mode::Left;
        i.standstill = false; // motor still coasting from a previous run
        for t in 1..200 {
            i.now_ms = t;
            let o = c.step(&i);
            assert_eq!(o.clutch, ClutchCmd::Off, "coil must stay off while the rotor turns");
        }
        i.standstill = true;
        let mut pulled = false;
        for t in 200..300 {
            i.now_ms = t;
            pulled |= c.step(&i).clutch == ClutchCmd::PullIn;
        }
        assert!(pulled);
    }

    #[test]
    fn limit_behind_tripping_means_wrong_direction() {
        let mut s = Sim::new();
        s.run_to_running(Mode::Right);
        s.tick(5);
        s.i.limit_left = true; // the LEFT limit trips while we feed RIGHT
        let o = s.tick(1);
        assert_eq!(s.c.state, State::Fault(Fault::WrongDirection));
        assert!(!o.driver_enable && o.clutch == ClutchCmd::Off);
    }

    #[test]
    fn can_drive_away_from_a_limit_already_hit() {
        let mut s = Sim::new();
        s.i.limit_left = true; // parked on the left limit
        s.run_to_running(Mode::Right);
        s.tick(50);
        assert!(matches!(s.c.state, State::Running { .. }));
        s.i.limit_left = false; // moved off it
        s.tick(50);
        s.i.limit_left = true; // and if it trips again now, that is wrong
        s.tick(1);
        assert_eq!(s.c.state, State::Fault(Fault::WrongDirection));
    }

    #[test]
    fn driver_not_ready_blocks_running() {
        let mut s = Sim::new();
        s.i.driver_ready = false;
        s.tick(2);
        s.i.mode = Mode::Right;
        let o = s.tick(500);
        assert_eq!(s.c.state, State::Fault(Fault::DriverNotReady));
        assert!(!o.driver_enable && o.clutch == ClutchCmd::Off);
    }

    #[test]
    fn rapid_needs_a_fresh_press() {
        let mut s = Sim::new();
        s.i.rapid = true; // held through the engagement
        s.run_to_running(Mode::Right);
        let held = match s.tick(1).motion {
            Motion::Velocity(v) => v,
            m => panic!("{m:?}"),
        };
        s.i.rapid = false;
        s.tick(1);
        s.i.rapid = true;
        let fresh = match s.tick(1).motion {
            Motion::Velocity(v) => v,
            m => panic!("{m:?}"),
        };
        assert!(fresh > held * 5.0);
    }

    #[test]
    fn stop_timeout_scales_with_speed_and_accel() {
        let mut c = Controller::new(Settings::default());
        let base = c.stop_timeout_ms();
        let mut s = c.settings;
        s.accel_mm_s2 = 5.0;
        s.rapid_mm_min = 2000.0;
        c.set_settings(s);
        assert!(c.stop_timeout_ms() > 6700 + 1000, "{} vs base {}", c.stop_timeout_ms(), base);
    }

    #[test]
    fn lowering_feed_max_clamps_the_setpoint() {
        let mut c = Controller::new(Settings::default());
        c.feed_mm_min = 300.0;
        let mut s = c.settings;
        s.feed_max_mm_min = 200.0;
        c.set_settings(s);
        assert_eq!(c.feed_mm_min, 200.0);
    }

    #[test]
    fn sensor_fault_drops_outputs() {
        let mut s = Sim::new();
        s.run_to_running(Mode::Left);
        s.i.sensor_fault = true;
        let o = s.tick(1);
        assert_eq!(s.c.state, State::Fault(Fault::Sensor));
        assert!(!o.driver_enable && o.clutch == ClutchCmd::Off);
    }

    #[test]
    fn driver_reset_mid_run_latches_until_centre() {
        let mut s = Sim::new();
        s.run_to_running(Mode::Right);
        // the app sees the TMC5160 reset flag: one step with the driver not ready...
        s.i.driver_ready = false;
        let o = s.tick(1);
        assert_eq!(s.c.state, State::Fault(Fault::DriverNotReady));
        assert!(!o.driver_enable && o.clutch == ClutchCmd::Off);
        // ...and even after it is configured again, nothing restarts while the switch is still on
        s.i.driver_ready = true;
        let o = s.tick(500);
        assert!(matches!(s.c.state, State::Fault(_)) && !o.driver_enable);
        s.i.mode = Mode::Center;
        s.tick(1);
        assert_eq!(s.c.state, State::Idle);
    }

    #[test]
    fn open_clutch_coil_faults_with_its_own_message() {
        let mut s = Sim::new();
        s.i.mode = Mode::Center;
        s.tick(2);
        s.i.mode = Mode::Left;
        s.tick(30);
        s.i.clutch_open = true;
        let o = s.tick(1);
        assert_eq!(s.c.state, State::Fault(Fault::ClutchOpen));
        assert_eq!(s.c.state.name(), "CLUTCH OPEN");
        assert!(!o.driver_enable && o.clutch == ClutchCmd::Off);
    }
}
