liorknafo/power-feed-manual-mill/(commit log)

2026-10-20 Add power-feed design spec and controller PCB schematic
    - docs/design.md: requirements, architecture, firmware state machine,
    Pico pin map, BOM, DIY electromagnetic tooth clutch, safety notes.
    - hardware/tools: Python generator that writes the KiCad 9 schematic
    from a circuit description, plus a checker (KiCad ERC, exported
    netlist vs intended nets, footprint presence).
    - hardware/kicad: generated project — TMC5160 + 4x CSD88537ND bridge,
    LM5164 36->5 V buck, Pico, hardware E-stop interlock, clutch coil
    half-bridge with current sense, protected panel I/O, BOM with LCSC
    numbers, BLX-A fuse-holder footprint.
    [bom.csv, clutch.kicad_sch, driver.kicad_sch, io.kicad_sch, mcu.kicad_sch, power-feed.kicad_sch, power.kicad_sch]
2026-10-20 Add routed controller PCB, clutch CAD and mill notes
    - Schematic: panel ribbon (2x7 IDC) + feed-unit header (JST-XH 7) so all
    connectors fit one 100 mm board edge; fix stub-bridging in the generator.
    - PCB (hardware/tools/build_pcb.py): 100x100 mm 4-layer board built from the
    netlist - fixed placement for power/connectors, auto-placed passives,
    GND / split +36V/+3V3 inner planes, Freerouting, post-route power pours,
    GND stitching; fix_planes.py drops plane vias for leftovers;
    check_pcb.py runs DRC with schematic parity. 3D renders in hardware/renders.
    Status: 5 unconnected items + 2 starved thermals left for interactive
    routing (see hardware/kicad/drc.json after check_pcb.py).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
    [clutch.kicad_sch, driver.kicad_sch, io.kicad_sch, mcu.kicad_sch, power-feed.kicad_pcb, power.kicad_sch]
2026-10-20 Add parametric controller enclosure and front panel CAD
    build123d models with STEP/STL export and shaded renders:
    - mechanical/enclosure: base, lid and fuse hatch for the 100x100 PCB
    (connector window/slot, USB hole, vents, ears, PETG and 3 mm alu presets)
    - mechanical/panel: pendant box with E-stop, toggle, rapid, encoder, OLED,
    ribbon strain relief, magnet back cover and engraved labels
    - mechanical/README.md with parameters, print notes and hardware lists
2026-10-20 Add Rust firmware: tested core logic + Embassy app for the Pico
    - firmware/feed-core (no_std, 35 host tests): power-feed state machine with
    every safety rule from design.md §3 (interlock, engage sequence with
    jog-to-mesh, stop->release ordering, latched faults, limits, reversal via
    idle), units, TMC5160 register maths, clutch PI current control,
    quadrature dial, button/menu, versioned settings blob.
    - firmware/feed-app (embassy-rp 0.10): 1 kHz control loop on an interrupt
    executor with watchdog, TMC5160 SPI driver, clutch PWM/ADC, SH1106/SSD1306
    OLED UI at 10 Hz, settings menu + flash storage.
    - firmware/tools/elf2uf2.py for drag-and-drop flashing.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
    [build.rs, clutch.rs, lib.rs, main.rs, menu.rs, oled.rs, quadrature.rs]
2026-10-20 Clutch: round Loctite rotor bore, generated machining sheet
2026-10-20 Add X feed unit (SIEG X3.5D left end); encoder moves to the leadscrew
    - mechanical/feed_unit: parametric mount plate, standoffs, belt chamber +
    printed guard, leadscrew stub on 2x 6002 with drive tongue, HTD-5M 20T/40T
    295 mm belt (2:1, C = 70.71 mm), clutch module bolted through its cover,
    output encoder on the stub. Mill-side dimensions are PLACEHOLDERS
    (FEED_UNIT.md lists them).
    - clutch: thicker cover front wall with 4x M5 for the plate, longer output
    shaft for the pulley.
    - firmware: encoder_counts is now per leadscrew turn; usteps_per_count
    includes the belt ratio (encoder after the belt also catches belt slip).
    - render.py: arbitrary cut plane and camera up vector.
    Co-Aut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
    [main.rs, settings.rs, units.rs]
2026-10-20 Finish controller PCB: DRC clean, silkscreen, JLCPCB fab outputs
    - manual_fixes.py closes the last 5 DRC errors: In2 +3V3 corridor extended
    under U2 VCC_IO vias, B.Cu +3V3 feed for the clutch op-amp, C19 bootstrap
    cap flipped with CA1/HA1/MOT_A1 re-routed, GND vias at the D9/D10 ESD
    arrays' isolated pads; redundant via-in-pad vias removed. DRC: 0 errors,
    0 unconnected, parity clean.
    - silk_cleanup.py: passive references to F.Fab, remaining references
    relocated clear of pads/silk/edge, connector pin labels, 36V MAX warning
    and board title (silk warnings 153 -> 0).
    - export_fab.py: Gerbers, Excellon drills + maps, JLC BOM/CPL, zip and
    hardware/fab/README.md with board specs and p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
    [power-feed-B_Cu.gbl, power-feed-B_Mask.gbs, power-feed-B_Paste.gbp, power-feed-B_Silkscreen.gbo, power-feed-Edge_Cuts.gm1, power-feed-F_Cu.gtl, power-feed-F_Mask.gts, power-feed-F_Paste.gtp]
2026-10-20 Firmware review fixes: limit polarity, driver bring-up, engagement proof
    - SW_MODE limit polarity was inverted (pol_stop=1 means low-active): now
    0b0011 (high = hit, matching NC-to-GND switches), with a test.
    - TMC5160 is configured once 36 V is present, re-initialised after a chip
    reset or bus loss; DRIVER NOT READY fault until then. Latched GSTAT
    driver errors clear when the switch is centred.
    - Engagement requires the output to follow the motor (0.6-1.6x over >=8
    counts) instead of any output movement; the coil only pulls in at
    standstill.
    - New faults: LIMIT WRONG WAY (limit behind the table trips), SENSOR FAULT
    (stuck ADC / open coil). Stop timeout derived from speed and acc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
    [clutch.rs, main.rs, menu.rs, settings.rs, state.rs, tmc.rs, tmc5160.rs, ui.rs]
2026-10-20 Firmware: latch a fault on TMC reset mid-run; CLUTCH OPEN fault
    - A TMC5160 reset or bus loss now holds driver_ready false for 500 ms, so
    the state machine latches DRIVER NOT READY (test added) instead of
    silently re-initialising in the same tick.
    - Open clutch coil is its own fault (CLUTCH OPEN); README commissioning
    step 2 updated (dummy coil resistor to see the jog).
    - Clear only GSTAT.drv_err on centre (keep the reset flag visible);
    clutch hold minimum 50 mA; jog writes XTARGET, RAMPMODE, VMAX.
    [main.rs, settings.rs, state.rs, tmc5160.rs]
2026-10-20 Complete LCSC part numbers in the BOM
    Every BOM line now has an LCSC number except the Pico module (A1), which
    is marked "user-supplied, hand-solder". Parts were checked against the
    JLCPCB parts library for spec, Basic/Extended status and stock.
    - build_schematic.py: RES_PARTS / CAP_PARTS value+footprint lookup tables
    used by R() / C(), which now raise if a passive has no entry; props for
    the diodes, LEDs, logic ICs, PTC (Littelfuse 2920L050DR, 60 V), IDC
    header (ZHOURI DC3-2.54-14PAS), JST-XH 7p and the Omron B3S-1000 reset
    button.
    - Regenerated the schematic sheets, kicad/bom.csv, fab BOM and the README
    missing-LCSC table. PCB, CPL, gerbers and drills are unchanged.
    Co-Authored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
    [bom.csv, clutch.kicad_sch, driver.kicad_sch, io.kicad_sch, mcu.kicad_sch, power-feed-bom.csv, power.kicad_sch]
2026-10-20 Fix enclosure PCB insertion and panel print tolerances
    Enclosure:
    - move the 4 lid-screw bosses beside the board on the left/right walls
    (outside the 100x100 outline, 0.8 mm from the PCB edge, 8.4 mm from the
    PCB screw axes); side margin 6.3 mm, outer 117.6 mm wide
    - add a wall pad around the USB hole so the plug still reaches the Pico
    - add insertion_sweep(): PCB lifted 0..45 mm in 1 mm steps, zero
    intersection with the base (negative control with overlapping bosses
    is flagged)
    Panel:
    - print-compensated holes: E-stop 22.5, toggle 12.4, rapid 16.3,
    encoder 7.4 / pin 3.2
    - depth is now a parameter, 60 mm (12 mm behind the E-stop body)
    - EC11 bushing check (panel + nut vs bushing l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
2026-10-20 Clutch review fixes: released-flat springs, through-bored circlip bearing stack, hub clear of pilot
    - Leaf springs flat when released (spacer 2.4), 0.3x14 stadium straps at 55°, ~25 N engaged;
    armature pockets clear the hub-end low-head screws; blind spring holes at r=30
    - Cover: 18 mm spigot with a Ø78 shoulder, 6 radial M4, straight-through Ø28 H7 bore with
    DIN 472-28 circlips, spacer tube, stepped inner-race spacer, DIN 471-12 on the shaft
    - Rotor hub starts 2.2 above the motor flange; bore depth = measured shaft length - 2.2
    - Teeth tips truncated 0.1 on both rings (0.1 tip/root clearance), 8° slot bridges
    - Shaft flat under the hub, 2 set screws; Loctite 641; TIR budget; design.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
2026-10-20 Feed unit review fixes: Oldham drive, circlip bearing stack, encoder adapter, guard cup, tensioner
    - Stub drives the leadscrew through an acetal Oldham disc (tolerates plate offset and end float)
    - Plate 25 mm: straight-through Ø32 H7 with DIN 472-32 circlips and a spacer tube; stub has a
    shoulder on the inner bearing and a DIN 471-15 outboard
    - Encoder on an adapter disc + 3 posts at r=23, outside the bearing bore; stub end clears the encoder shaft
    - Belt guard is a closed-back cup; plate top edge raised to cover it; chamber 38
    - Drawbolt tension block below the module + radial M5 in the clutch cover; M5x35 module bolts
    - Interference checks added: mechanical/tools/check_clutch.py, check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
2026-10-20 Mechanical re-review fixes: circlip lands, module bolts clear the guard, stronger Oldham
    - Bore circlip grooves leave a 2.0 (clutch, Ø28) / 2.5 (plate, Ø32) land; the inner bearing
    locates each shaft, with the shaft circlip between the bearings (no clash with the bore circlips)
    - Plate 28 mm, grown toward the table (chamber 35), so the overhang is unchanged
    - Module bolt pattern 55/125/190/350° (clutch-local): heads outside the guard, clear of the drawbolt;
    lower standoffs moved to y=-78; bolt heads modelled and checked over the whole tension slot
    - Oldham disc Ø24 x 9 in steel or bronze, stub tongue 4 high
    - FEED_UNIT.md regenerated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
2026-10-20 Clutch sheet: workable bearing assembly order, slip fit for the floating bearings; check reports pilot clearance
2026-10-20 Interactive 3D viewer of the whole project (three.js: feed unit, clutch, box + PCB, panel)
2026-10-20 One box: drive, controller PCB and controls in a single housing on the table end
    - Plate widened to the operator side (+X) as the back wall; 3 mm 6061 panels on 10x10 bars;
    partition with the PCB on standoffs (components to the operator, connectors down) and a wire grommet
    - Front panel = control panel: E-stop / toggle / rapid column, OLED + SPEED dial over the PCB, engraved labels,
    adapter board + 150 mm ribbon to J4; bottom: drawbolt access, 2x M16 glands, vents; end-panel vents
    - 70 countersunk M3 joints modelled (panel holes + tapped holes in plate edges and bars)
    - Interference + clearance checks extended to the housing (0 bad pairs; >=3 mm everywhere over the tension slot)
    - Separa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
2026-10-20 Schematic: bare RP2040 instead of the Pico module
    RP2040 (QFN-56) per Raspberry Pi's minimal design: W25Q16JV 2 MB QSPI flash, 12 MHz crystal with 1k series,
    internal 1.1 V core regulator, BOOTSEL + RESET buttons, JST-SH SWD, status LED on GPIO25, USB-C (5.1k CC,
    27R series). +3V3 now from an AP2112K-3.3 fed by VSYS = +5V or USB VBUS through Schottkys. Same GPIO
    numbers as the Pico, so the firmware is unchanged. ERC 0 findings, netlist 132 nets / 189 parts match.
    Layout follows (PCB agent). LCSC numbers for the flash and crystal still to be verified.
    [clutch.kicad_sch, io.kicad_sch, mcu.kicad_sch, power-feed.kicad_sch]
2026-10-20 Docs: bare RP2040 instead of the Pico module (BOOTSEL/RESET buttons, JST-SH SWD, USB-C)
2026-10-20 RP2040 parts after LCSC check: W25Q128JVSIQ (C113767, W25Q16 out of stock), ABM8-272-T3 (C20625731), SWD on a 0.1in header (JST-SH out of stock)
    [mcu.kicad_sch]
2026-10-20 Housing 3D printed (PETG, Prusa MK3S): one shell print + control-panel print
    - Shell = back/top/bottom/end walls + partition + front corner rails + PCB bosses (gusseted, heat-set inserts)
    in one print standing on its end wall (176 x 190 x 199, no supports); overlaps the plate edges by 13 mm so it
    fits the 210 mm build height, M3 into the plate edges
    - Front panel 4 mm printed face down, labels engraved 0.6, thinned to 3 mm at the EC11
    - Aluminium panels and 10x10 bars dropped (70 -> 20 screws); checks: 0 collisions, >=4 mm clearances, print fit OK
2026-10-20 Compact rounded housing (PCB flat above the motor) + click-to-identify 3D viewer
    Housing: no separate electronics bay any more. The PCB lies flat above the motor on printed rails (clears the
    motor by >=6 mm over the whole tension slot), connectors toward the end wall; USB-C slot and 2 cable glands
    in the end wall; controls in a strip on the upper front. Two PETG prints that fit a Prusa MK3S: shell
    (116 x 187 x 202) and an L-shaped hood (top + control strip) that lifts off to expose the PCB. Long edges R12,
    end edges R8; plate corners rounded to match. 176 -> 116 mm front-to-back. Checks: no overlaps, controls >=2 mm,
    print fit OK.
    Viewer: click any part for a side panel (what it is, materia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
2026-10-20 Machinability pass: no sharp internal corners a cutter can't make
    - New mechanical/tools/check_machinable.py: flags concave straight edges along each machined part's tool
    axis (pocket/slot corners an end mill can't make sharp); negative-controlled on a square pocket
    - Rotor banana slots: true arcs with full-round ends (were square-ended polygons)
    - Clutch teeth: roots relieved 0.5 below where the flanks meet, so a Ø2 ball end mill's root fillet stays
    below the mating tip (0.6 clear); 0.5 mm turned run-out band so no milled end wall sits under the teeth
    - Field housing: 0.5x45 edge breaks on the front OD and bore, clearing the turned corners of the cover
    shoulder and the rotor hub
    - MA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
2026-10-20 Machinist review fixes: chamfer-mill teeth, real turning/milling procedure, setups and datums
    - Teeth are now FLAT 30° flanks, each the plane through a radial line at the pitch plane: one straight 60°
    chamfer-mill pass per flank, the same program for rotor and armature, exact mating (engaged overlap 0,
    flanks bear as soon as the armature is pushed); run-out groove 1.0 so the Ø2 rougher and the cone pass r 32
    - MACHINING.md teeth: turn the band to TIP height (rotor +0.30, armature +0.55 over the pole face), turn the
    run-out groove to the floor, Z zero on the tips, workholding, acceptance check (pole gap 0.15 ± 0.05)
    - Rotor bore bottom dimensioned from the face disc (0.70 ± 0.03),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
2026-10-20 Clutch sheet: rougher centre from r 32, chamfer-mill Z, drop the stale coil-cavity turning note (machinist review: ACCEPT)
2026-10-21 PCB: finish layout review fixes 1-9, replace the Pico module with the bare RP2040 circuit
    Part A (hardware/tools/layout_fixes_v2.py, rerunnable):
    - review fixes 1-9 finished; new fix10 drops GND stitching vias that end up
    too close to the reroutes
    - 36 V nets keep 0.5 mm on the outer layers (power-feed.kicad_dru), with
    documented exceptions inside the TMC/FET packages
    - the 1210 bridge caps under Q10-Q13 and the USB-C / J6 / H4 corner have
    explicit courtyard-overlap rules
    Part B (hardware/tools/rp2040_layout.py, runs after layout_fixes_v2.py):
    - Footprints are synced from the schematic (refs renumbered via refmap.py)
    and A1 is removed.
    - U3 RP2040 sits at (60, 13), with flash U4, cr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
    [power-feed-B_Cu.gbl, power-feed-B_Mask.gbs, power-feed-B_Paste.gbp, power-feed-B_Silkscreen.gbo, power-feed-Edge_Cuts.gm1, power-feed-F_Cu.gtl, power-feed-F_Mask.gts, power-feed-F_Paste.gtp]
2026-10-21 Housing + viewer follow the routed RP2040 board: real USB-C (J4) position for the end-wall slot, RP2040 group, buttons and SWD header in the PCB placeholder; connector names J5 clutch / J6 panel / J7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
2026-10-21 Schematic: 100 nF right at RP2040 DVDD pin 23 and USBLC6-2SC6 ESD (C7519) on the USB-C lines (PCB review round 2)
    [clutch.kicad_sch, io.kicad_sch, mcu.kicad_sch]
2026-10-21 PCB review round 2: bridge-cap and sense-resistor GND vias, USB off the +36V split, ESD + VDD_CORE cap
    - C20/C22/C24/C26: the GND vias that fix2 added were removed again by its own
    stitching-via clean-up. They are now added after the clean-up, with tracks ending
    on their centres: 3 vias at C20/C26 and 2 at C22/C24, where the next J2 pad is
    close.
    - R18/R21 pad 2: solid GND islands with 6 / 7 vias (0.6/0.3) into In1.
    - USB pair and I2C_SCL now run east on B.Cu above the In2 +36V finger. The
    finger is cut to y 33.5-53, which also clears LIM_R's drop. No B.Cu signal
    crosses the split now.
    - Schematic round 2 (04bb841) pulled in. refmap.OLD2NEW2 renumbers C40..C63
    -> C41..C64 and U5.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
    [power-feed-B_Cu.gbl, power-feed-B_Mask.gbs, power-feed-B_Paste.gbp, power-feed-B_Silkscreen.gbo, power-feed-Edge_Cuts.gm1, power-feed-F_Cu.gtl, power-feed-F_Mask.gts, power-feed-F_Paste.gtp]
2026-10-21 PCB review round 3: no vias inside the RP2040 exposed-pad paste windows
    The four 0.6/0.3 vias at (59.25/60.75, 12.25/13.75) sat in the EP's paste windows, open under the paste,
    and could wick the solder away from the RP2040's only GND joint. Removed from the board, from the pre-route list in
    rp2040_layout.py and from rp2040_routes.json (replay reproduces the board: 733 vias, 1730 tracks). EP keeps the
    footprint's 4 corner vias + 1 in the gap between the windows. DRC + parity PASS; fab outputs and renders regenerated.
    [power-feed-B_Cu.gbl, power-feed-B_Mask.gbs, power-feed-B_Paste.gbp, power-feed-B_Silkscreen.gbo, power-feed-Edge_Cuts.gm1, power-feed-F_Cu.gtl, power-feed-F_Mask.gts, power-feed-F_Paste.gtp]
2026-10-21 README: PCB accepted and ready to order; assembly notes; machinability and housing steps
2026-10-21 Housing review fixes: PCB tool access, plug room, printable without supports, fit gap, louvred exhaust
    - Rails over the PCB get 12 mm windows above all 4 holes (screwdriver + insert iron straight down, checked);
    PCB rails replaced by 4 bosses so air rises past the board; bosses and the louvre block have 45° undersides
    - Plugs: lap 13 -> 8, tail_clear 9 -> 19 (shell print 207 of 210 mm); MSTB plug + ferrule + wire-bend envelope
    modelled and checked; cable glands moved low, beside the motor, wires drop behind the motor tail
    - Print: end-wall edges and the top-front edge are 45° chamfers (they lie on the bed); hood back lip has a
    chamfered inside (no taper, no support); plate top corner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
2026-10-21 Housing review round 2: every print one solid, rails trimmed to the skin, glands clear
    - Back-top rail tied to the back wall by a 4 mm shelf, front rail by a web off the front wall; tool windows get
    a 45° top so the segment above prints unsupported; OLED/adapter posts run into the strip (were 0.25 mm off it)
    - Rails intersected with the outer skin (no slivers through the end chamfer)
    - Glands at x ±36: locknut and seal clear the shell, 14 mm from the motor tail
    - Fan/louvre field lowered under the rail shelf
    - check_feed_unit.py: asserts one solid per print and nothing outside the skin
2026-10-21 Housing: back-rail hood screw W 205 -> 192 (its insert seat was cut by the 45° window); checker asserts every insert seat >= 95 % material
2026-10-21 Housing: end hood screws 4 mm inboard so their countersunk heads sit fully on the flat, not the end chamfer (housing review: ACCEPT)
2026-10-21 README: housing reviewed and ready to print
2026-10-21 Program with the box closed: end-wall USB-C + SWD ports, USB FLASH menu item
    - End wall: Ø16 hole for a round nut-mount USB-C panel extension (e.g. Adafruit #6069) left plugged into J4,
    and a recessed SWD port (1x3 0.1in header, pins sunk 0.9 mm) wired to J3; both engraved; above the plugs,
    clear of rails, PCB, motor and controls (>= 8.9 mm). Old deep USB slot removed
    - Firmware: last settings-menu item USB FLASH -- hold to switch the driver and clutch off and reboot into the
    RP2040 ROM USB bootloader (UF2 through the end-wall USB-C). SWD + Debug Probe recovers any state
    - 48 core tests pass; housing checks: one solid each, 9 insert seats OK, print fit OK, 0 bad pairs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
    [main.rs, menu.rs, ui.rs]
2026-10-21 End wall: recessed BOOT and RESET buttons (wired across SW1/SW2) so the RP2040 can be reflashed from a Mac over USB-C with the box closed, whatever the firmware does
2026-10-21 Built-in 36 V supply: LRS-100-36 under the module, fused switched IEC inlet in the end wall
    - PSU lies flat under the clutch/motor on printed ribs (>= 3 mm clearance over the whole tension slot), terminals
    toward the end wall; floor and plate bottom 14 mm lower (print height unchanged, footprint 116 x 201 fits the MK3S)
    - Snap-in IEC C14 + fuse + switch low in the end wall (230V~ engraved); 36 V gland removed (wired internally to J1)
    - M4 earth-bond hole in the plate; mains wiring, PE, fuse and cord notes in FEED_UNIT.md; design.md R8/BOM updated
    - Port labels moved clear of the buttons
2026-10-21 Mains safety review fixes: earthed aluminium mains tray, LRS-75-36, real wiring room, docs
    - All 230 V in a folded 1.5 mm aluminium tray (floor, sides, end face, lid over the terminals) bolted to the plate:
    fixed and earthed by its flange; PSU screwed through the tray floor; inlet clipped into the tray's end face (1.5 mm
    panel, recessed 9 mm behind the end wall, away from run-off coolant); only the 36 V pair leaves via a grommet
    - LRS-100 -> LRS-75-36 (99 mm) for 35 mm of free wiring room between PSU terminals and inlet; worst case ~60 W
    - No floor vents (motor intake moved to slots in the back/front walls); drawbolt access kept through the tray floor
    - check_feed_unit.py: no part may en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
2026-10-21 Mains tray review fixes: buildable tray, real LRS-75 geometry, louvred intake, drains, checks
    - LRS-75-36 per Mean Well's drawing (99 x 97 x 30, two base M3 holes, max 3 mm): M3x4 button heads in floor pockets
    - Tray tabs bolted at x -45/-13, clear of the shell's plate-edge screws and the drawbolt tool path
    - Terminal/inlet zone 10 mm higher: inlet flange has 5.0 / 3.5 mm of flat sheet round it; lid on 4 M3 into rivnuts
    in inward-folded wall flanges; tray 104 wide, bottom long edges R8.5 so it fits the corners
    - Motor intake as 45° louvre blocks on the back/front walls; 2 drains behind the inlet
    - check_feed_unit.py: every plate hole against every other (negative-controlled on the old bol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
2026-10-21 Mains tray: shell slides on over the PSU screw heads (groove), terminal zone closed toward the PSU
    - Floor pockets -> one 7 mm groove along W open to the shell's rim; ribs 0.3 below the tray
    - Lid's plate-side edge folded down to just above the PSU (closes the 101 x 10 window); wall flanges 10 mm for
    closed-end M3 rivnuts, starting past the fold
    - check_feed_unit.py: shell slide-on sweep 0..200 mm against tray/PSU/module/screw heads, closure of the raised
    zone toward the PSU, mains-zone intrusion box up to the raised lid
2026-10-21 Viewer: show the power supply, mains tray, lid and AC inlet, with click descriptions
2026-10-21 Clutch: released/engaged section figure from the CAD; viewer shows the clutch released (coil off) with a coil-on toggle
2026-10-21 Clutch: leaf spring modelled as one stadium strap (round ends, straight sides), as the real shim
2026-10-21 Clutch: release check in the assembly steps (gap 1.25 with the coil off, no tooth contact)
2026-10-21 Design: leaf-spring torque path and strap load check (56 N per strap at cam-out, 10x buckling margin)
2026-10-21 Clutch: armature centring at assembly (hub flange = armature OD = Ø76 h7, one sleeve over both); what holds the floating armature
2026-10-21 Clutch: armature on 3 drive pins in bronze bushes with preloaded return springs (replaces the leaf springs); bottom service door on a pin hinge
    Clutch: the pins carry the torque and centre the armature; three compression springs behind the hub pull it
    onto the hub face when the coil is off (24 N preload, 32 N engaged), so the released position is a hard stop.
    Hub flange 8.7 so nothing else in the unit moves. Section figure, viewer, checks and docs updated.
    Door: x +-25 from the shell's rim to a hinge at W 172, Ø3 steel pin in knuckles under the floor, 2x M3 into
    the plate's bottom edge; pockets for the PSU screw heads replace the floor groove. Checks: one solid, swing
    0-100 deg clear, slid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
2026-10-21 Clutch review fixes: pins bonded through the bushes (no binding), hub set screws midway between the pins (hex-key check), fixture on the pin holes, pin friction and stroke split in the design table
2026-10-21 Clutch review round 2: through pin holes (glue exits at the back face), Ø6.10-6.15 glue gap, bushes flush with the stop face, hub position on the shaft stated
2026-10-21 Clutch review round 3: pins only move down onto a pre-set collar (no wet pin dragged into a bush), dry hole mouths + glue-trap chamfer, waxed bush ends, Ø6.15-6.20 glue gap; doc spring lengths 8.7/7.6
2026-10-21 Clutch step 0 in a doable order: bushes pressed and waxed, glue the armature holes on their own, then stack, sleeve, collared pins down
2026-10-21 Clutch step 0 wording from the final review (accepted): hub-side dry mouth, tooth-tip stand-off, light clamp, wax cleanup, hole line-up
2026-10-21 Viewer: clutch return springs stretch/compress with the armature (they were drawn engaged-length in the released view, looking detached from the washers); bushes split out
2026-10-21 Full bottom door: the whole floor hinged along the back edge; module and mains tray load from below
    - shell has no floor; the door (floor + rounded bottom edges + end band) swings down to the back on a Ø3 x 180 pin,
    2 screws on the front side (plate bottom edge + insert in an end-wall corner boss)
    - plate: clutch slot open to the bottom edge (module slides up into it), low module bolts 40/140 deg, tension block
    72 wide bridging the slot, 2 rebates + M4 for the tray's floor tabs (tray fixing and earth bond from below)
    - checks: module and tray lift in from below, door swing, end insert seat, door print (45-degree feet and drips)
2026-10-21 Bottom door review fixes: tension-block tongue seals the plate's open slot; inlet clipped in on the bench and lifted with the tray; webs under the door knuckles; order on the bench, earth re-test aft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
    Checks: slot 99.5 % filled, tray + inlet (with flange) lift in clear, no print island starts in mid-air (new
    layer-by-layer check; a door without the webs fails it).
2026-10-21 Door hinge pin: slides in from the end-wall end (clearance in all knuckles but the plate-end press fit), grooves for its way in and the punch's way out; insertion-path check
2026-10-21 Plug holes checked against real parts: USB-C hole Ø12.5 for the #6069's M12 thread, 90-degree adapter in J4 (the 38 mm straight plug can't fit the 29 mm to the wall), USB path envelope check; BOOT/RE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
2026-10-21 Clutch machining sheet: tools table (lathe + 3-axis CNC, no indexer/4th axis/form cutters); cover Ø28 H7 bored from the boss end, spigot bored on a Ø28 mandrel (no 89 mm reach)
2026-10-21 Every fastener in the models with ISO threads (bd_warehouse): 20 in the clutch, 98 in the unit, tapped-hole threads, inserts, rivnuts, circlips; check that each overlaps only what it threads into
    Fixes found by placing them: cover radial M4 countersunk (a socket head would hit the mains tray), ISO 10642 countersink
    size (Ø6.9), M6 standoff screws in plate counterbores (heads by the clutch cover), drawbolt M4 tapped 14 deep (never
    bottoms over the tension range), serrated earth washer between tray tab and plate (rebate 2.5), door end screw M3x6,
    motor flange holes and relieved body corners (the M5 nuts behind the flange).
2026-10-21 Clutch: return springs as real coils, E-clips as open clips; washers + E-clips as their own part (spring retainers) in the exploded view
2026-10-22 Real bought parts from their datasheets (bought.py): controls, end wall, drive, PSU; every hole and clearance re-checked
    - bought.py: 23HS45 motor, HTD-5M pulleys (hubs off, set screws through a tooth root) and a toothed 295-5M-15 belt
    seated in their grooves, LPD3806 encoder, LRS-75 (5-pole block), SE-AS-303 inlet + C13 plug, IDEC XA1E E-stop +
    legend plate, KN3C toggle (key tab), GQ16 rapid, PEC11R dial + Ø30 knob, SH1106 OLED, PBS-110 BOOT/RESET, M16
    gland, 40 mm fan, #6069 USB-C panel end; sources cited, inferred dims marked
    - Collisions the real parts showed, fixed: compact E-stop (the XB5 hit J6's plug), adapter board 40 x 28, encoder
    posts 25, USB bend, C14 bay + rocker side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
2026-10-22 Every bought part now ships to Israel from Amazon: new E-stop, toggle, buttons, knob, OLED, encoder, USB-C port, inlet, pulleys, coupling, inserts, rivnuts, Loctite; CAD from each listing's drawing, 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
    - E-stop: ZGSZJHF 22 mm ultra-short (keyed hole, 18.3 behind the panel), printed legend plate; ribs dropped
    - USB-C: QIANRENON M21 panel extension (Ø21.6 hole, port moved up clear of RESET)
    - Mains: JOYNANO 1.5 mm-panel inlet (SINORS drawing), Schuko-C13 cord + Israel adapter, open-end
    rivnuts with Ø8.5 lid holes + washers (screw tip stays inside the rivnut)
    - Drive: hubless Saelno 20T / uxcell 40T pulleys, Ø19x25 coupling on 30 mm encoder posts
    - Loctite 641 -> 243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
2026-10-22 Encoder posts: priaolker M3x30 brass hex standoffs, 6 across flats (Amazon B09NDJFLG7), modelled as hex; checks still clean
2026-10-23 36 V supply: Mean Well LRS-150-36 (Amazon B019GYOQDW, the only one that ships to Israel); housing lengthened and split for the MK3S
    - bought.py: LRS-150 from Mean Well's case 241A drawing (base holes 24/102 from the terminal end, 7-pole block)
    - mains tray: 36 mm free wiring room kept, raised lid over the whole terminal block; box now 262 mm long
    - new end cap print (end wall + floor under the tray's end): slides on last, 3 blocks screwed through the shell,
    45-degree scarf holds the door's far end, seam lapped over top and sides; shell/hood/door end at W 248
    - shell brace across the cut face; door's far screw replaced by the cap's scarf
    - checks: end cap in every check, its slide-on sweep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
2026-10-23 Exploded clutch in the viewer: show the 4 M5x35 module bolts + washers and the M4x30 drawbolt with the cover
    They thread into the cover but were only drawn in the mounted view (plate group), so the cover's tapped holes
    looked empty in the exploded view. feed_unit.py exports them in the clutch frame (fx_module_mount.stl).
2026-10-24 The mains tray and its lid export flat patterns for cutting on the CNC (#1)
    feed_unit.py now writes out/mains_tray_flat.dxf/.step and out/mains_tray_lid_flat.dxf/.step from the same F
    parameters as the folded model. DXF R2000 in mm ($INSUNITS 4): outline and every hole as closed LWPOLYLINE/CIRCLE on
    layer CUT, bend centre lines as LINEs on layer BEND. STEP: the blank extruded 1.5 mm. Each blank is drawn from the
    outside, so every bend folds 90 degrees away from the viewer.
    Bend method: inside radius 1.5 mm (1 t), K-factor 0.33 (DIN 6935 k/2 = 0.325 at r = t; the generic K-factor chart
    gives 0.33 for air-bent aluminium with r <= t): bend allowance 3.134, bend deduction 2.866 mm per bend. Sta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
2026-11-13 Migrate the mechanical CAD from build123d to SolidCraft (#2)
    Every part is its own parametric SolidCraft design (mechanical/solidcraft/parts/, 62 plain-JSON designs built
    through SolidCraft's MCP server), and two assemblies link them: clutch.sc (rotor/output turn, armature stroke)
    and feed_unit.sc (the clutch nested as clutch_module, door hinge, 2:1 belt link). Screws, nuts, washers and the
    6001/6002 bearings come from SolidCraft's ISO library. *.build.json rebuild the assemblies with solidcraft-cli.
    Each part was compared with the build123d part as STEP: identical apart from true arcs where the old model used
    polylines (clutch teeth, belt guard, belt, plate slots), label kerning, and the m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
    [mains_tray_flat.dxf, mains_tray_lid_flat.dxf, motor_23hs45.json]
